GrechTech/RetroRosetta/Wiki/LevelShifter/Parts.png

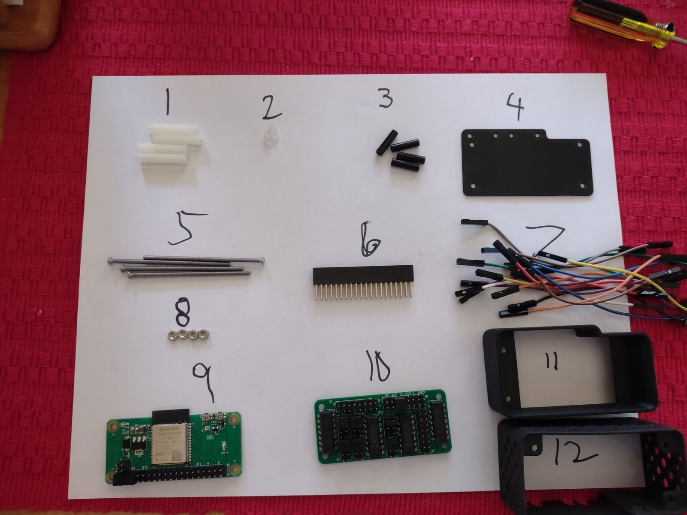
Wiki/LevelShifter/Parts.png
