GrechTech/RetroRosetta/Wiki/V2/RetroRosettaV2 DIY Setup_5.png

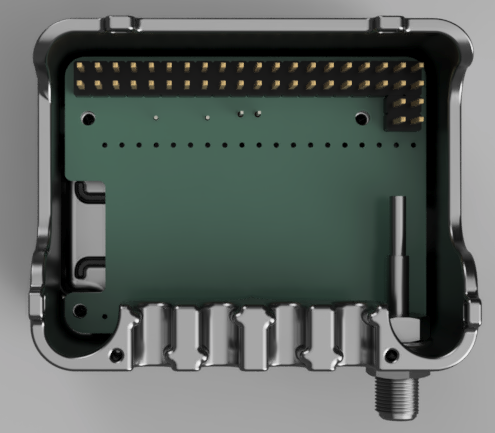
Wiki/V2/RetroRosettaV2 DIY Setup_5.png
