GrechTech/RetroRosetta/README.md

# RetroRosetta

Check the Wiki page for more information
https://github.com/GrechTech/RetroRosetta/wiki
