GrechTech/RetroRosetta/Marketing/cover2.png

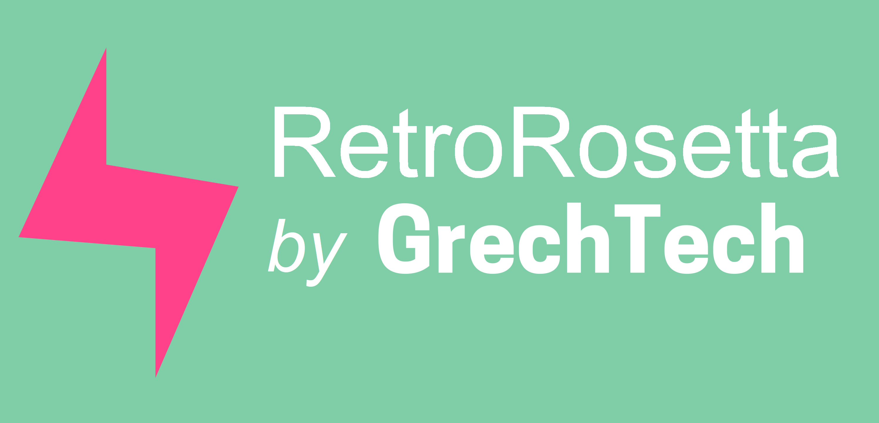
Marketing/cover2.png
