GrechTech/RetroRosetta/Wiki/3v3.png

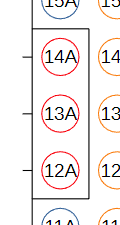
Wiki/3v3.png
