GrechTech/RetroRosetta/Wiki/BTN.png

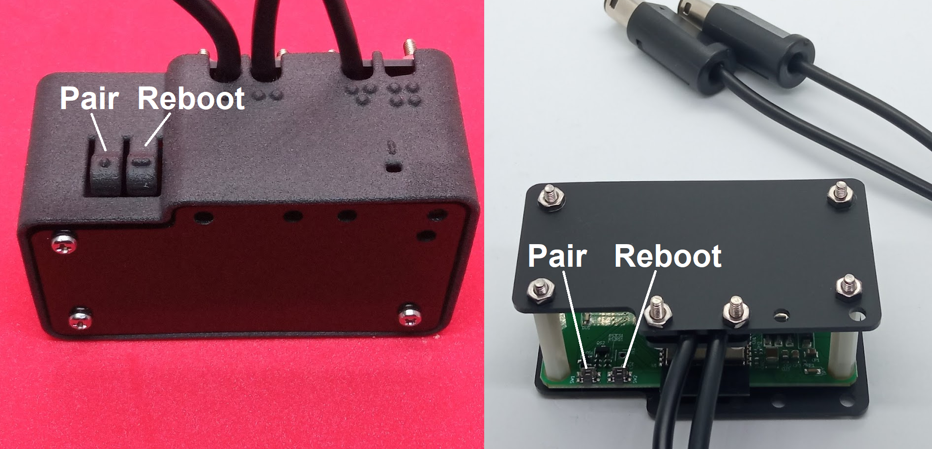
Wiki/BTN.png
