GrechTech/RetroRosetta/Wiki/Case2/1.jpg

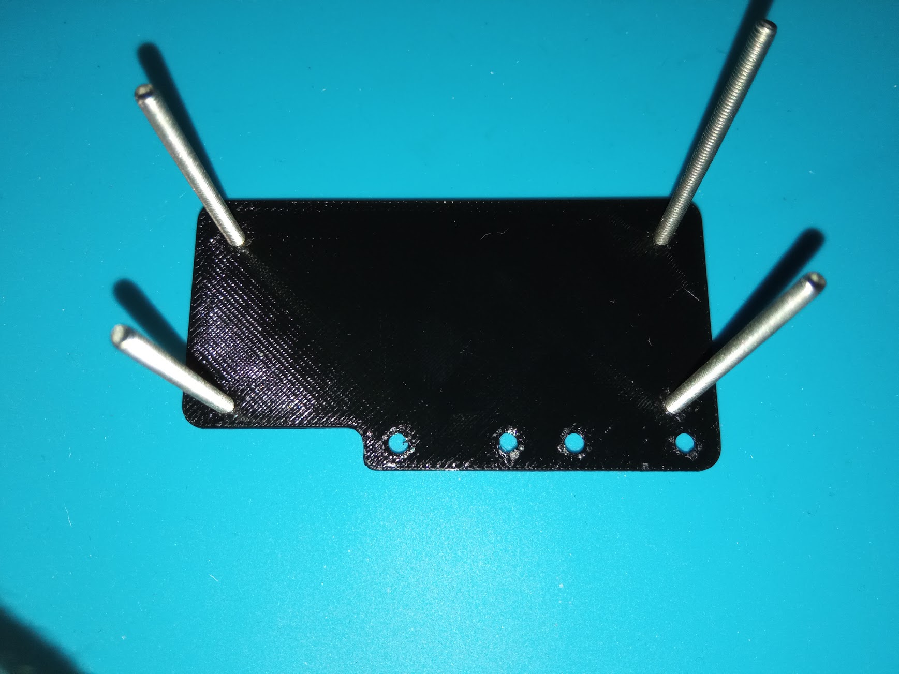
Wiki/Case2/1.jpg
