GrechTech/RetroRosetta/Wiki/Case2/2.jpg

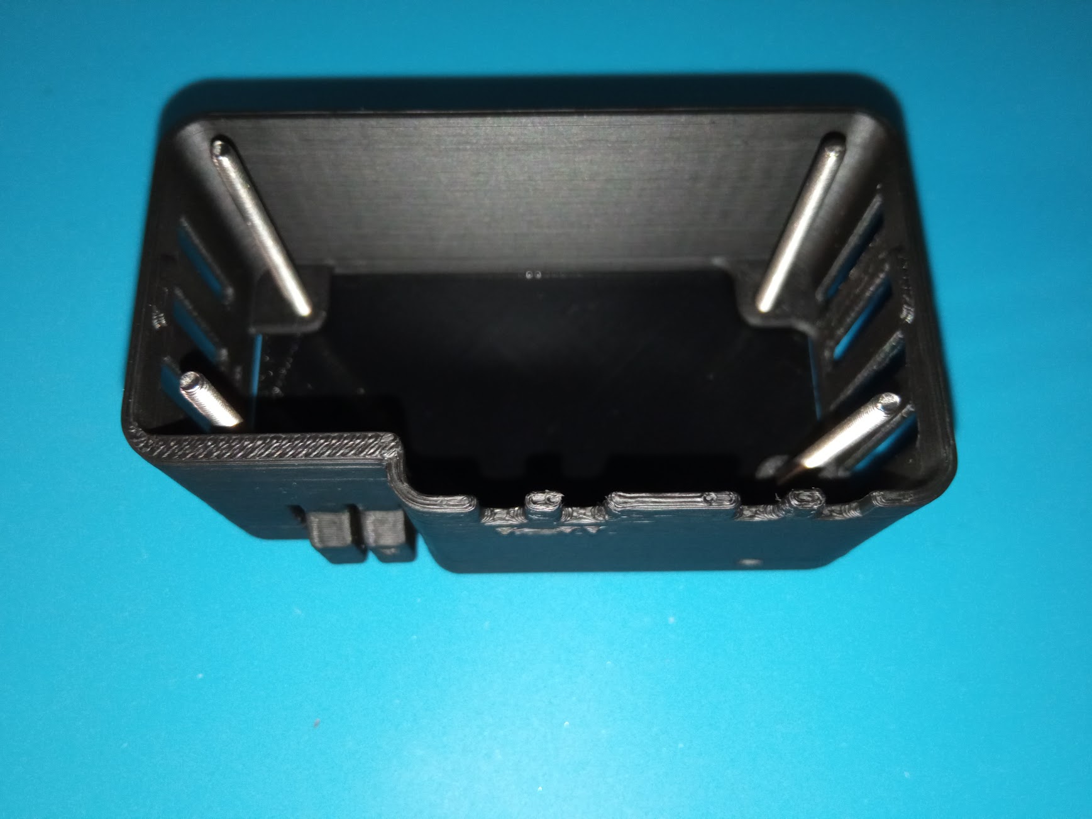
Wiki/Case2/2.jpg
