GrechTech/RetroRosetta/Wiki/Case2/3.jpg

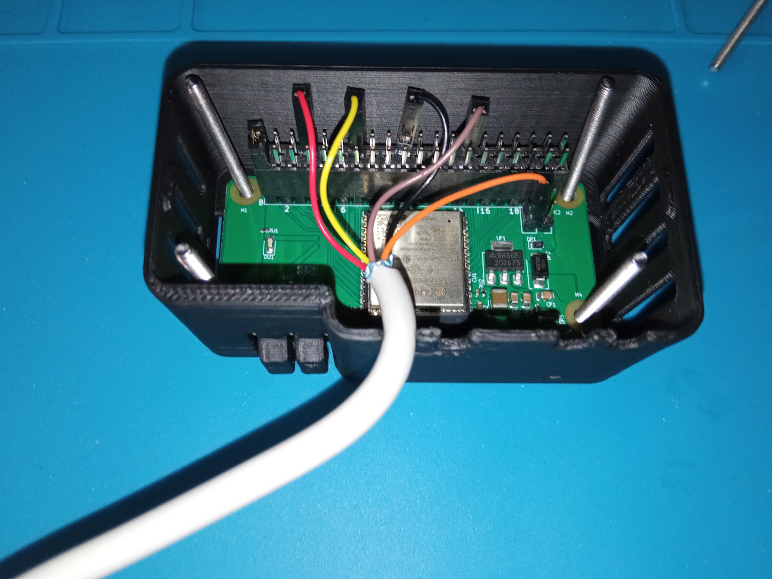
Wiki/Case2/3.jpg
