GrechTech/RetroRosetta/Wiki/Case2/4.jpg

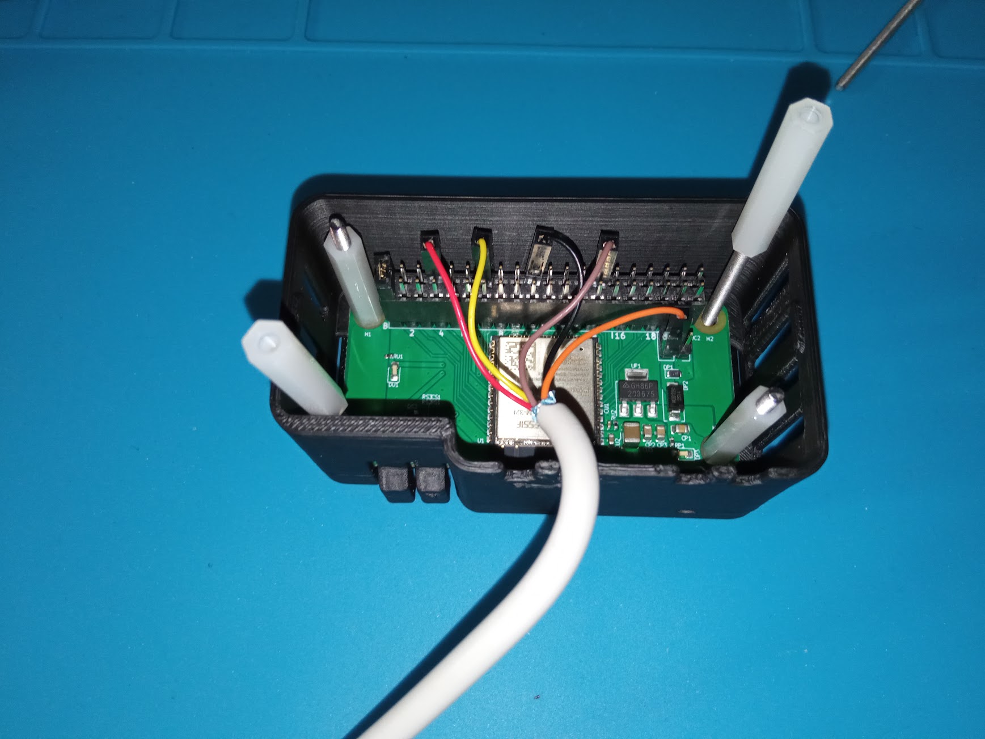
Wiki/Case2/4.jpg
