GrechTech/RetroRosetta/Wiki/Case2/5.jpg

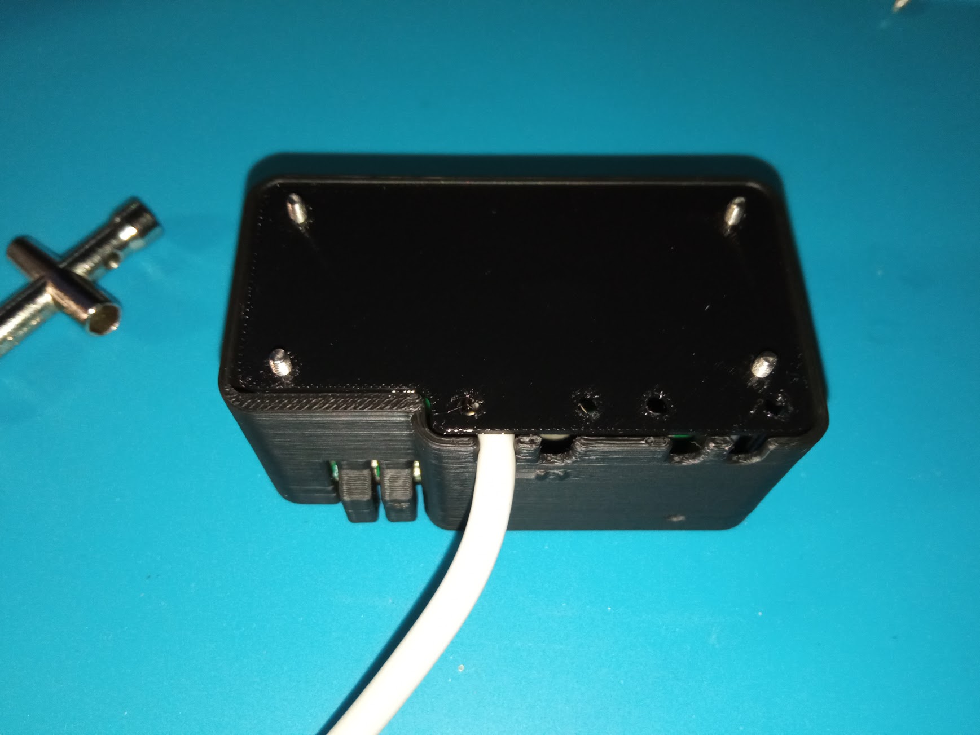
Wiki/Case2/5.jpg
