GrechTech/RetroRosetta/Wiki/Case2/6.jpg

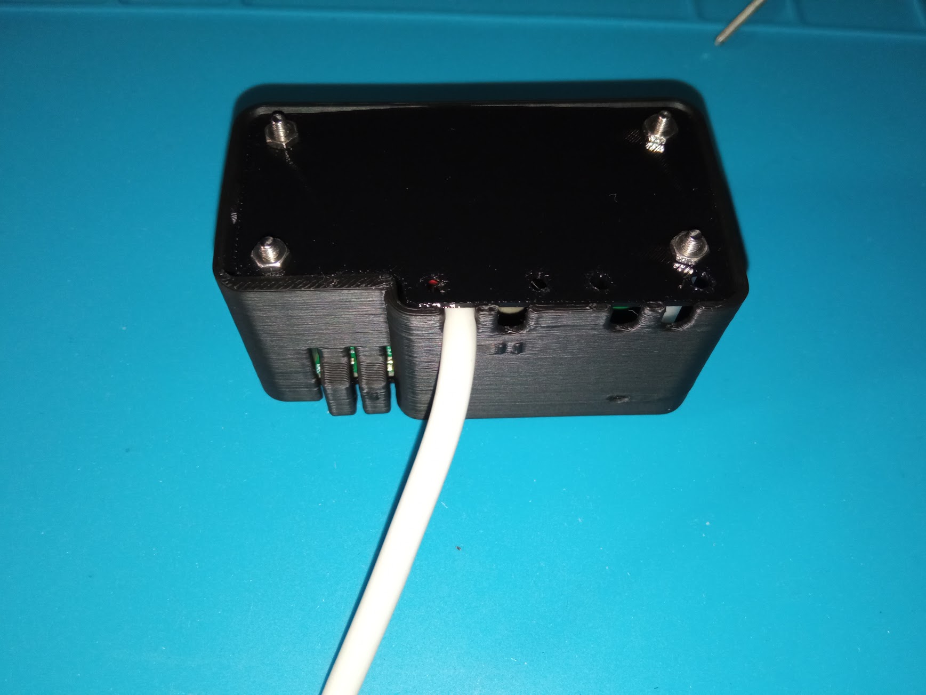
Wiki/Case2/6.jpg
