GrechTech/RetroRosetta/Wiki/Case2/7.jpg

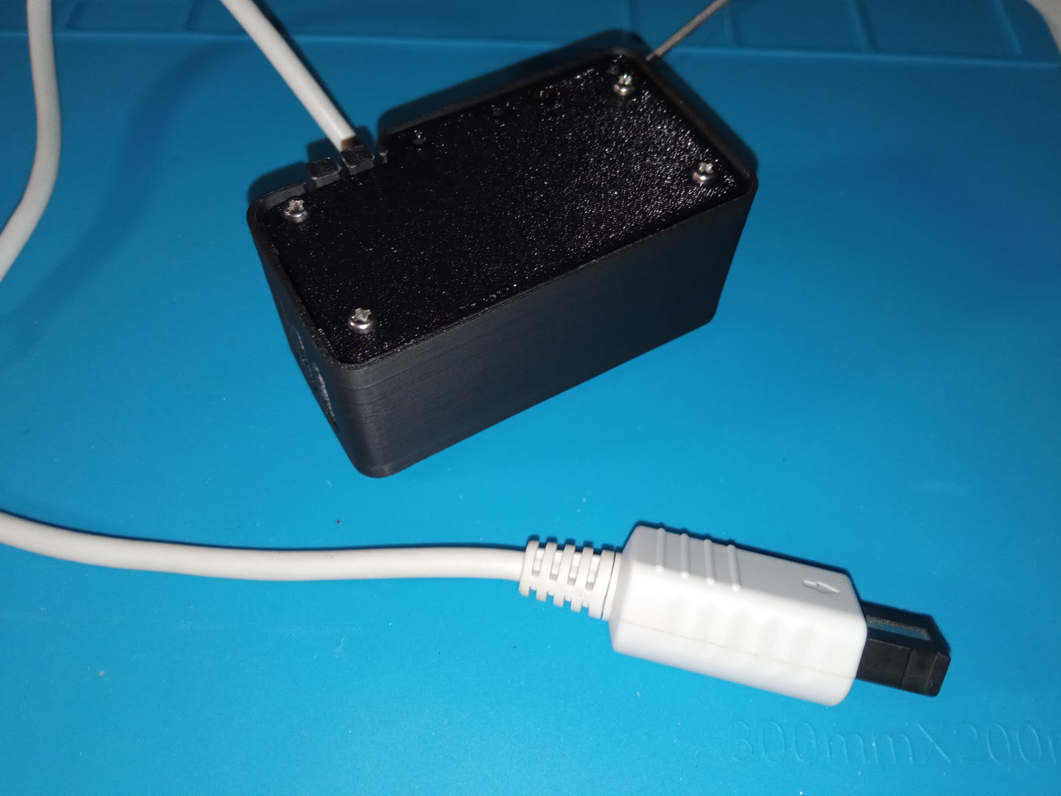
Wiki/Case2/7.jpg
