GrechTech/RetroRosetta/Wiki/DE9.png

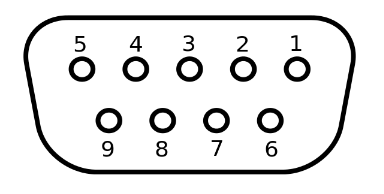
Wiki/DE9.png
