GrechTech/RetroRosetta/Wiki/Dreamcast_1P.png

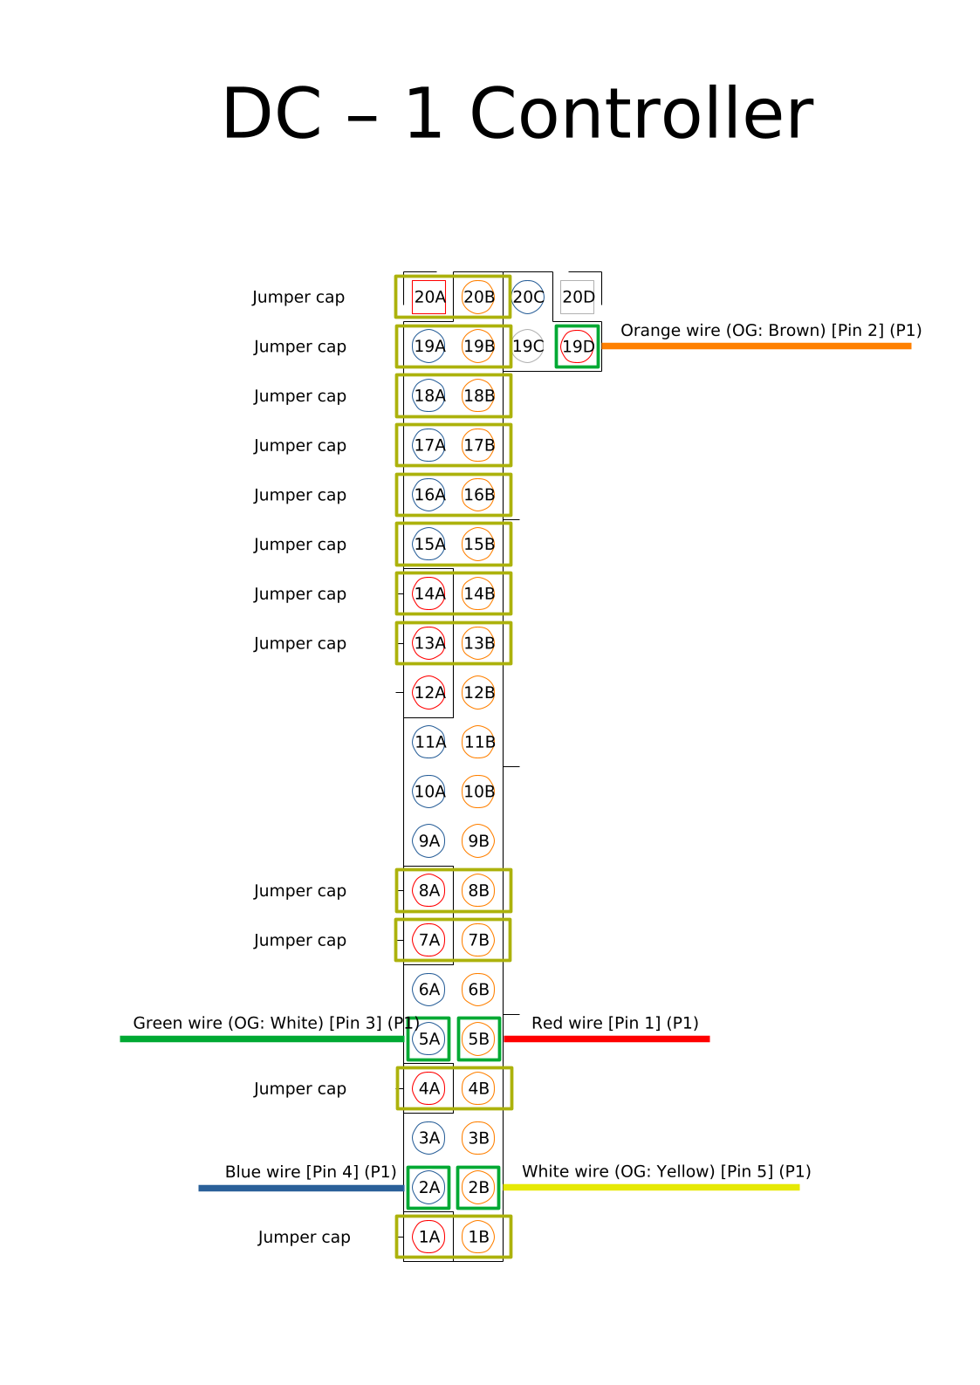
Wiki/Dreamcast_1P.png
