GrechTech/RetroRosetta/Wiki/Dreamcast_3P.png

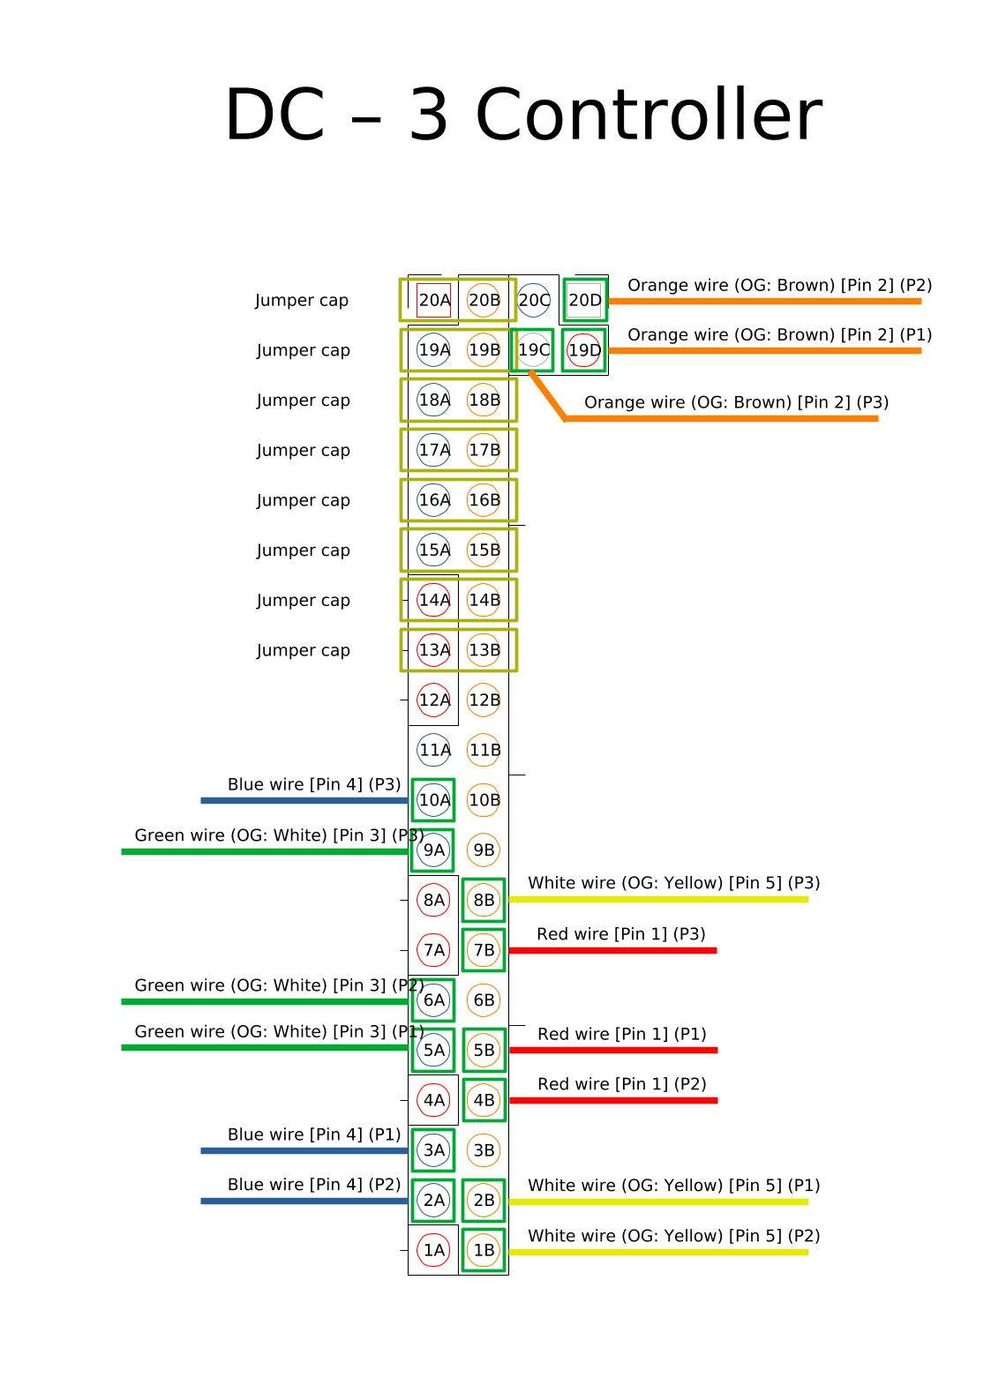
Wiki/Dreamcast_3P.png
