GrechTech/RetroRosetta/Wiki/Fami1.png

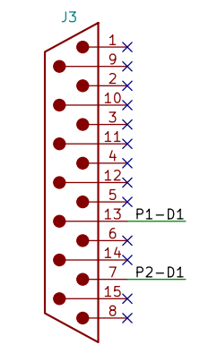
Wiki/Fami1.png
