GrechTech/RetroRosetta/Wiki/Fami2.png

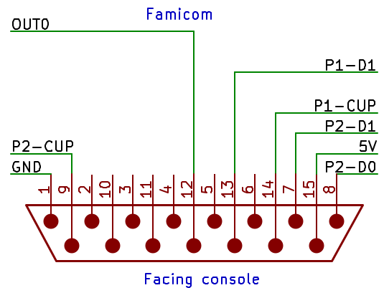
Wiki/Fami2.png
