GrechTech/RetroRosetta/Wiki/GameCube_1P.png

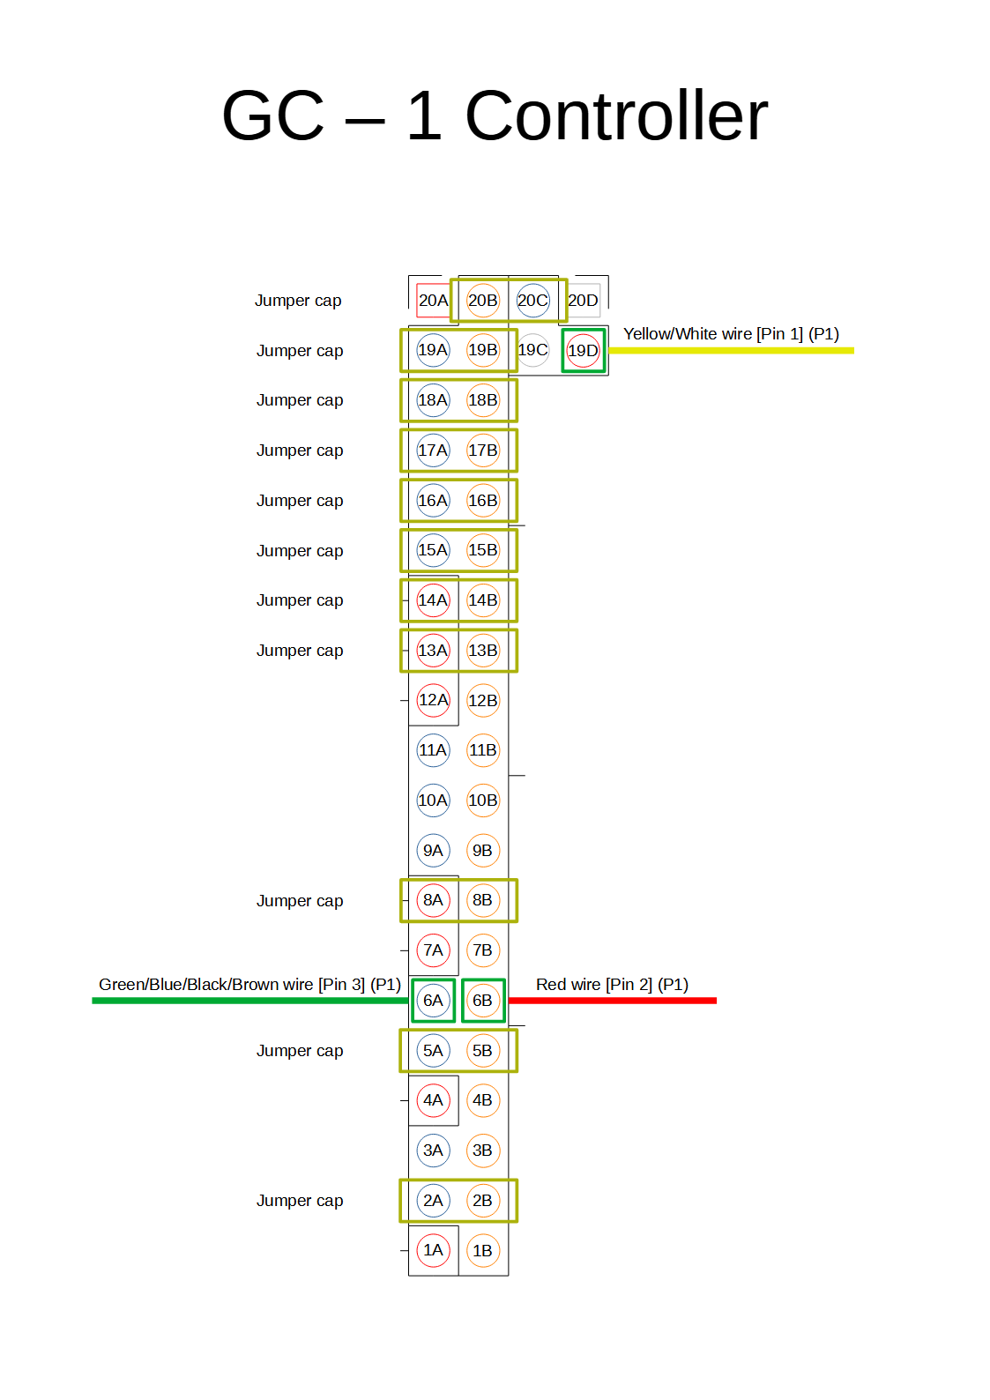
Wiki/GameCube_1P.png
