GrechTech/RetroRosetta/Wiki/GameCube_3P.png

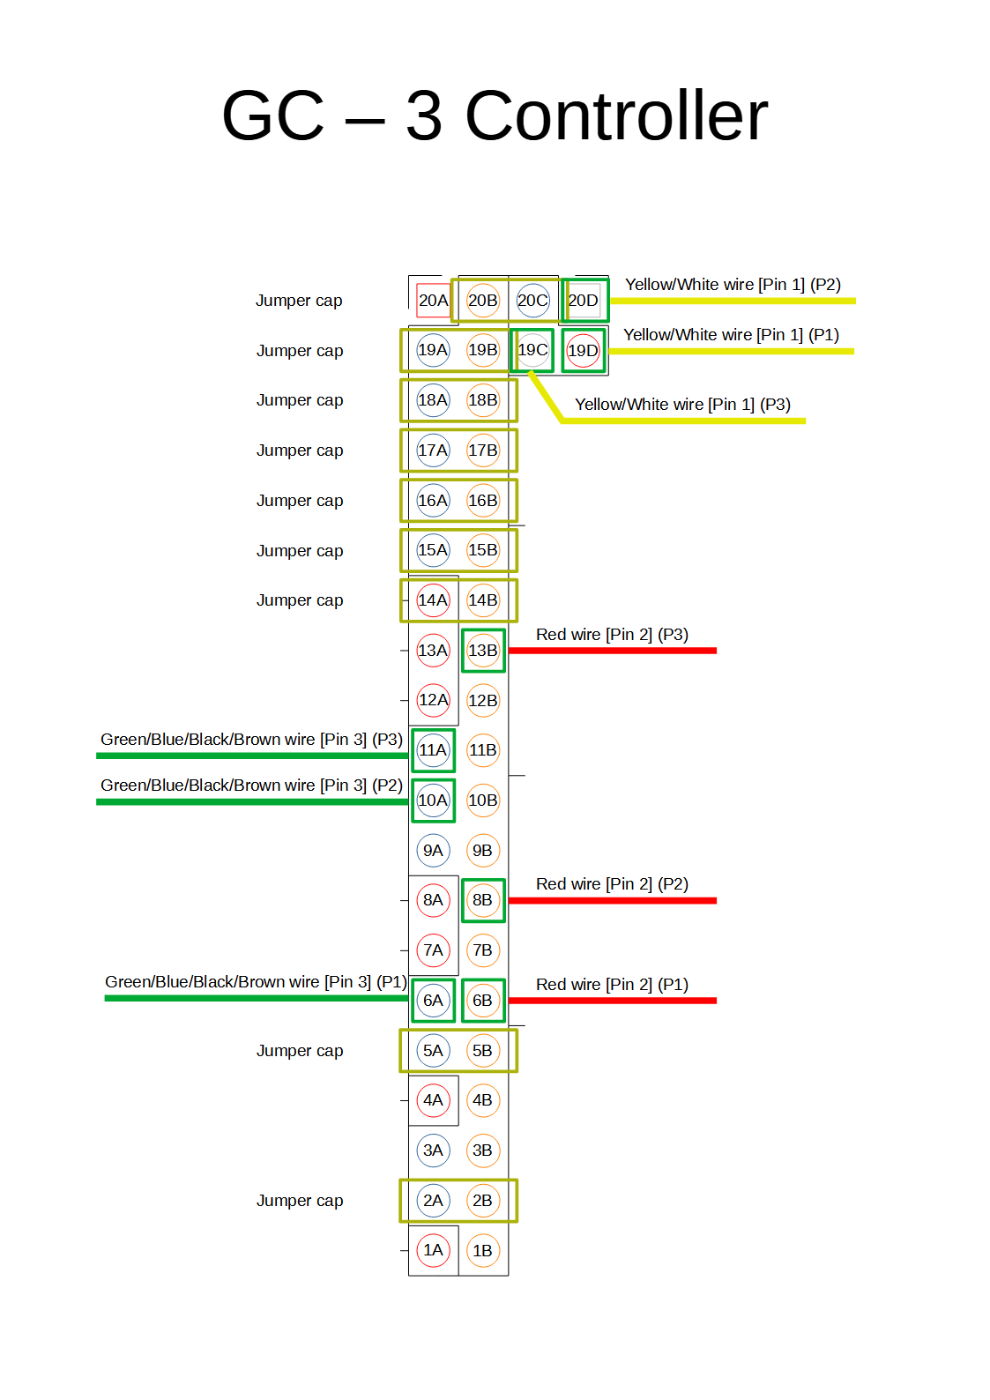
Wiki/GameCube_3P.png
