GrechTech/RetroRosetta/Wiki/LEDs.png

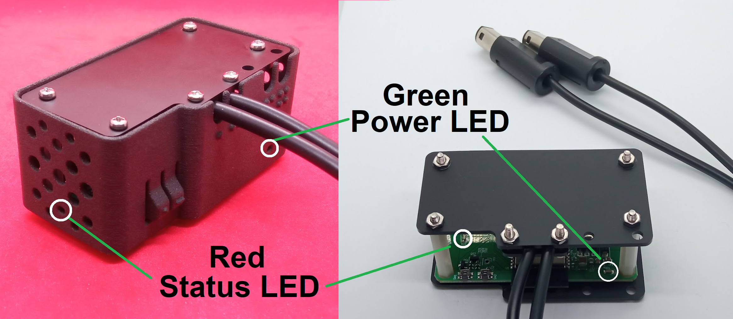
Wiki/LEDs.png
