GrechTech/RetroRosetta/Wiki/LevelShifter/BoardB.png

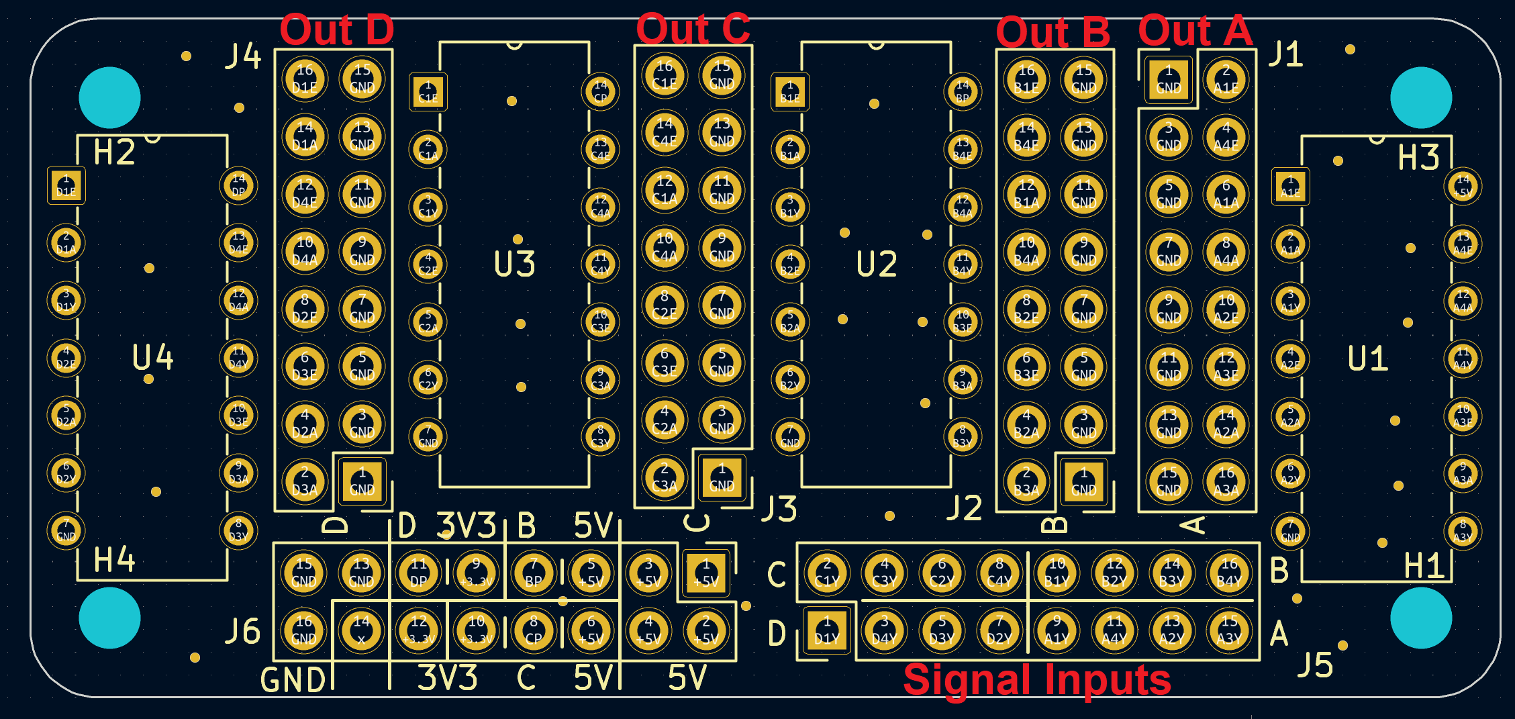
Wiki/LevelShifter/BoardB.png
