GrechTech/RetroRosetta/Wiki/LevelShifter/Case/Case0.jpg

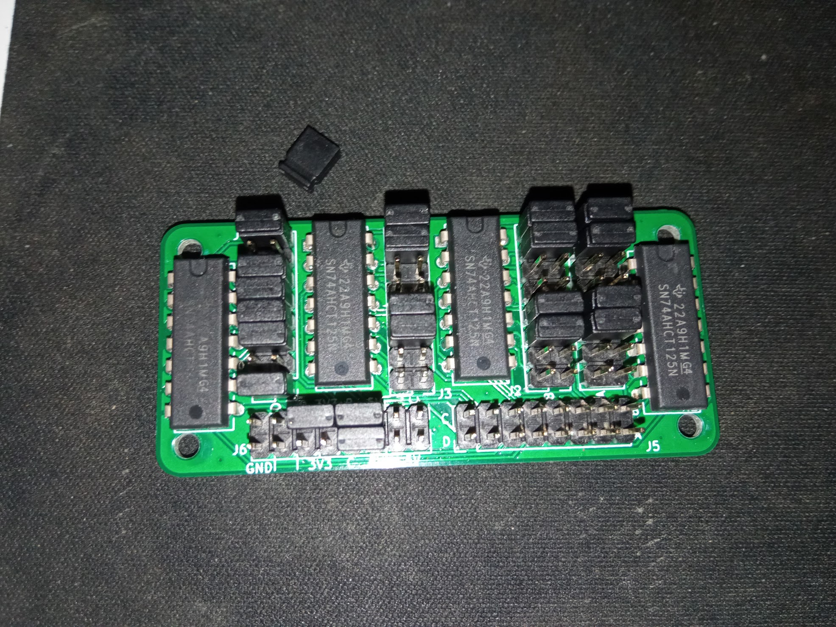
Wiki/LevelShifter/Case/Case0.jpg
