GrechTech/RetroRosetta/Wiki/LevelShifter/Case/Case1.jpg

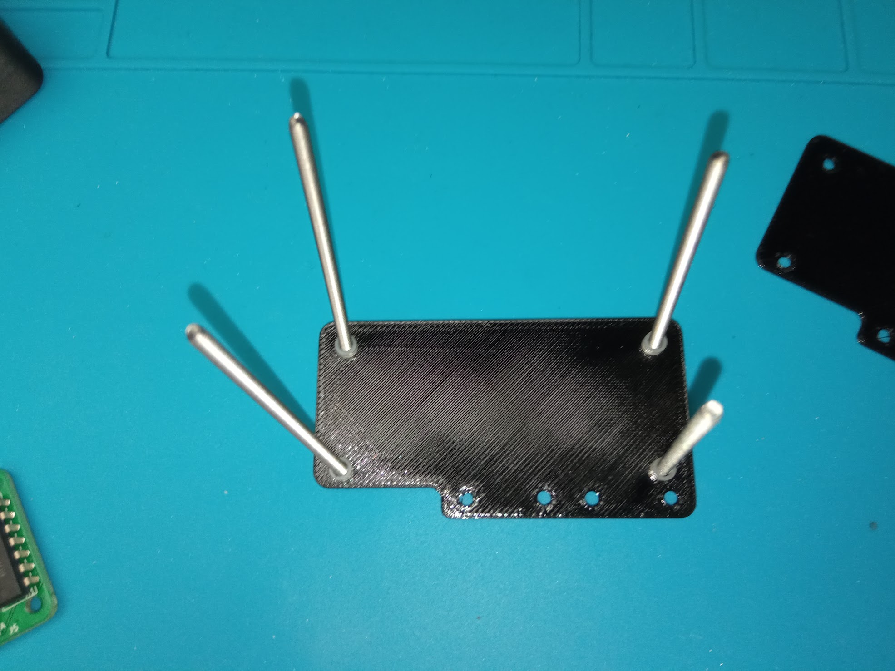
Wiki/LevelShifter/Case/Case1.jpg
