GrechTech/RetroRosetta/Wiki/LevelShifter/Case/Case2.jpg

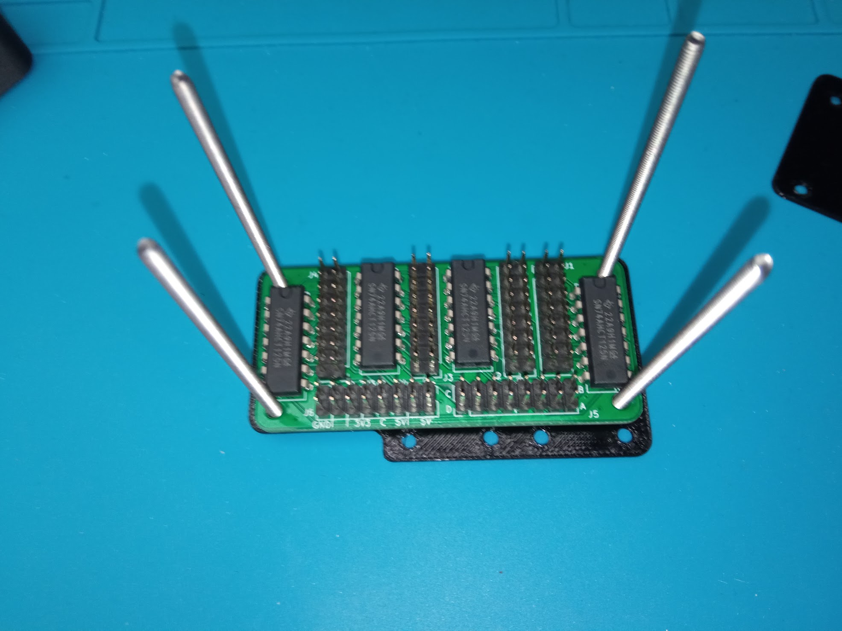
Wiki/LevelShifter/Case/Case2.jpg
