GrechTech/RetroRosetta/Wiki/LevelShifter/Case/Case3.jpg

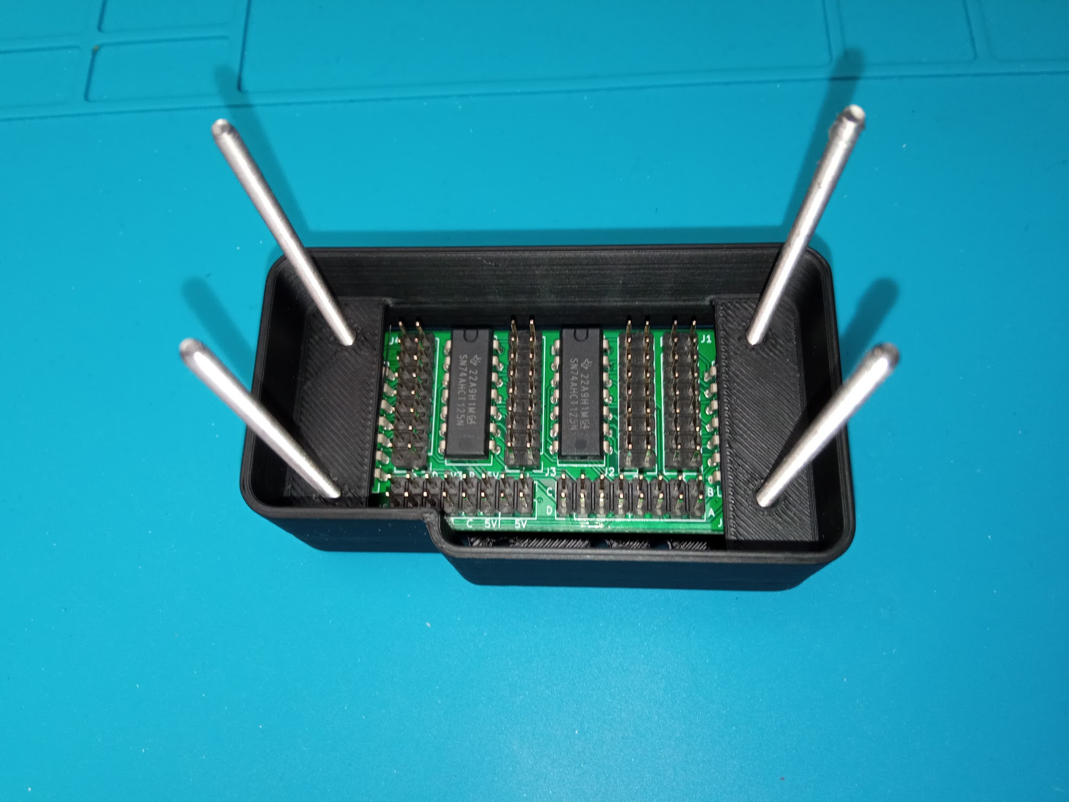
Wiki/LevelShifter/Case/Case3.jpg
