GrechTech/RetroRosetta/Wiki/LevelShifter/Case/Case4.jpg

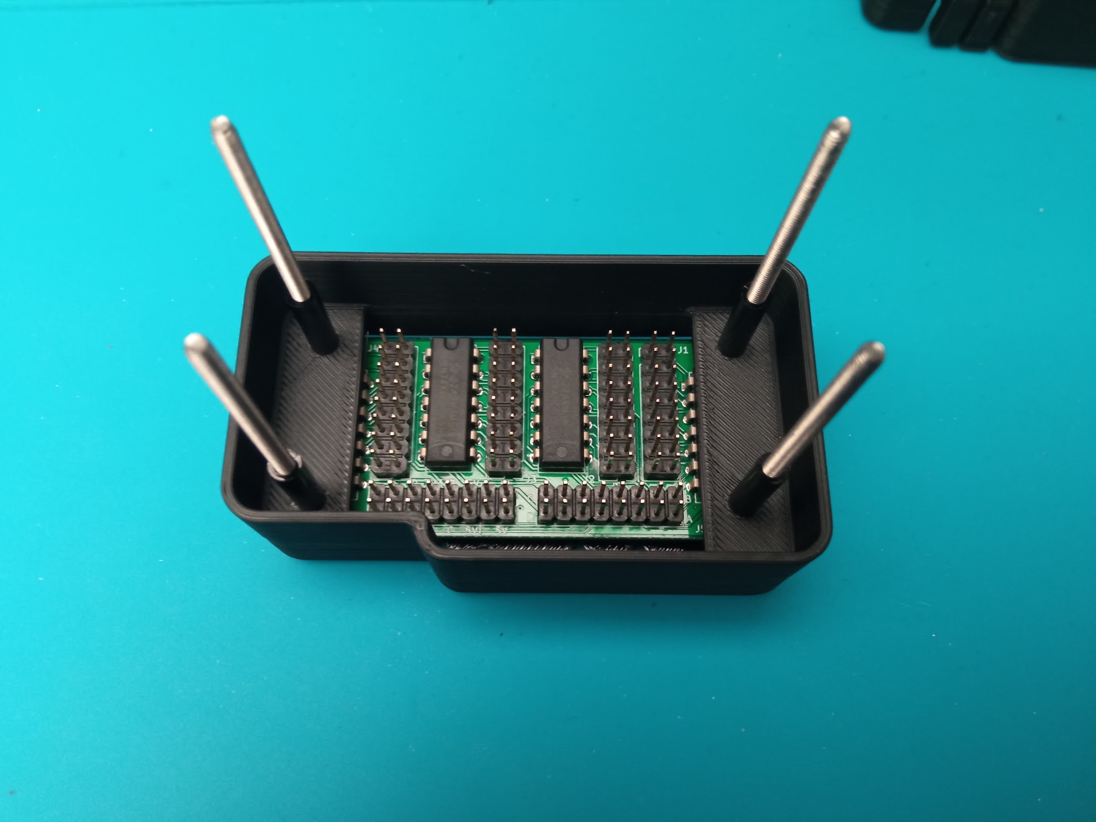
Wiki/LevelShifter/Case/Case4.jpg
