GrechTech/RetroRosetta/Wiki/LevelShifter/Case/Case5.jpg

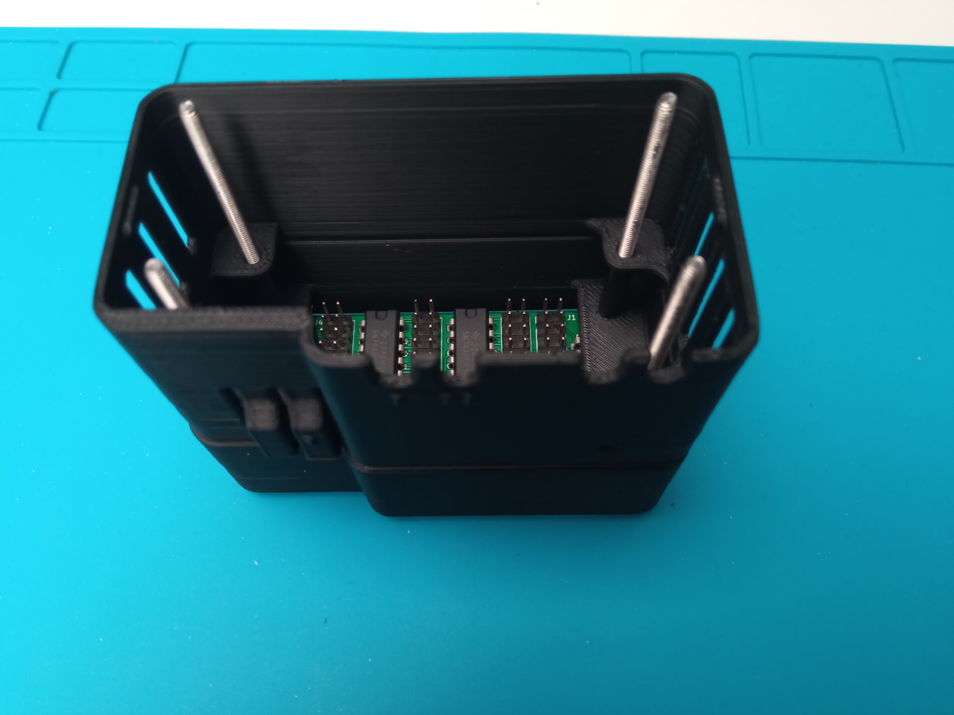
Wiki/LevelShifter/Case/Case5.jpg
