GrechTech/RetroRosetta/Wiki/LevelShifter/Case/Case6.jpg

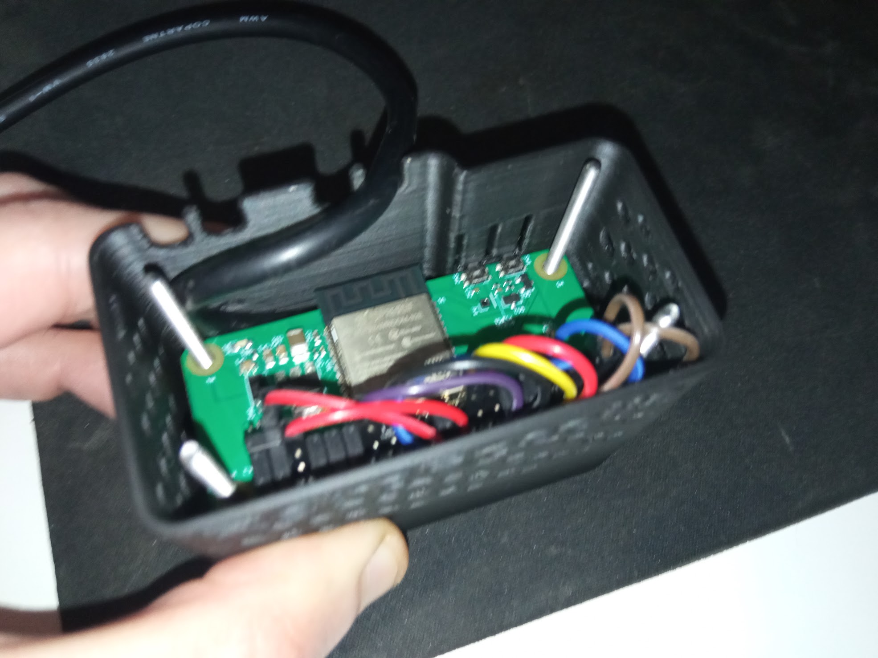
Wiki/LevelShifter/Case/Case6.jpg
