GrechTech/RetroRosetta/Wiki/LevelShifter/LSIO.png

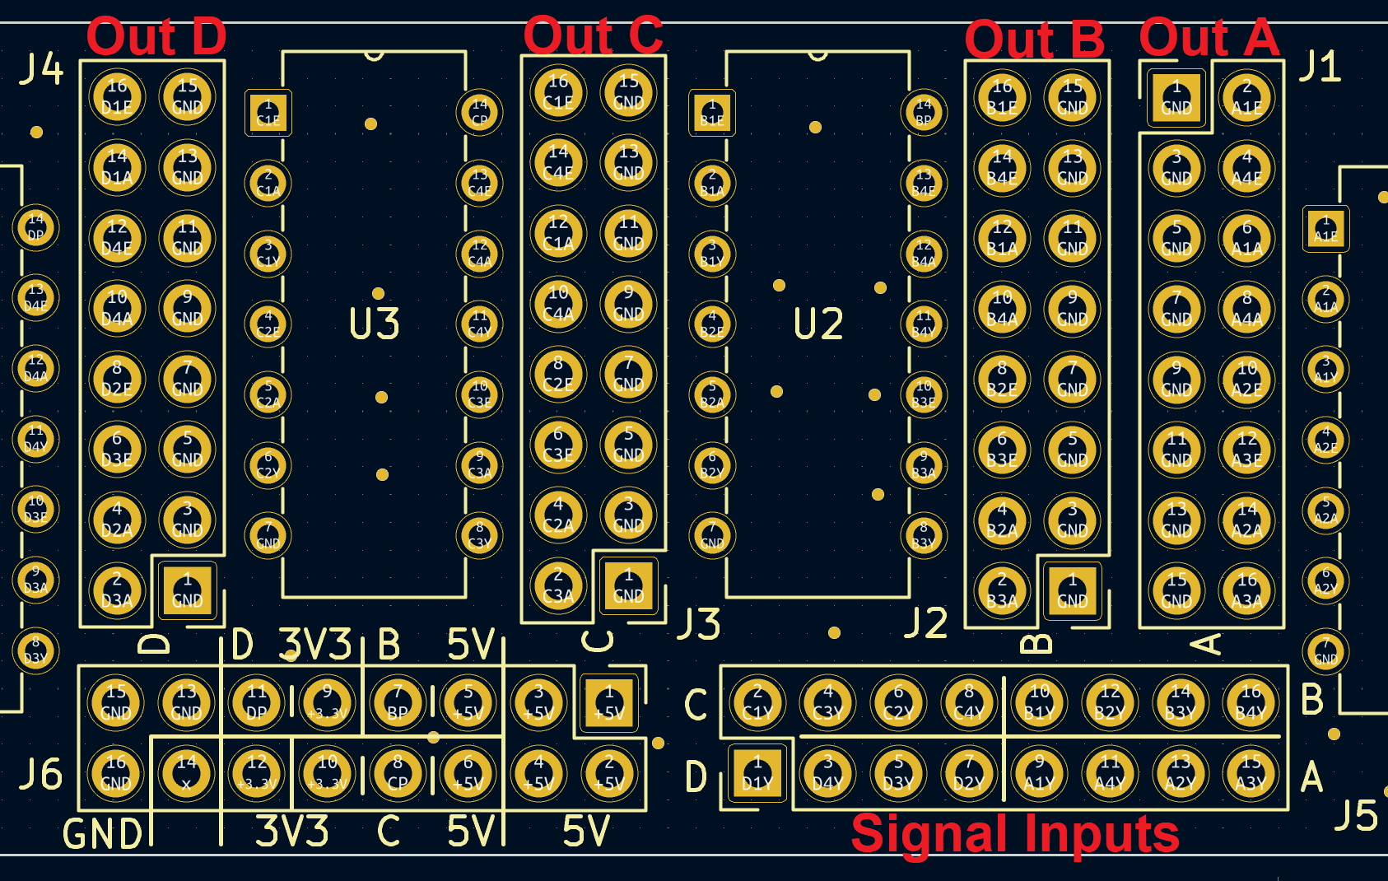
Wiki/LevelShifter/LSIO.png
