GrechTech/RetroRosetta/Wiki/LevelShifter/Schematic.png

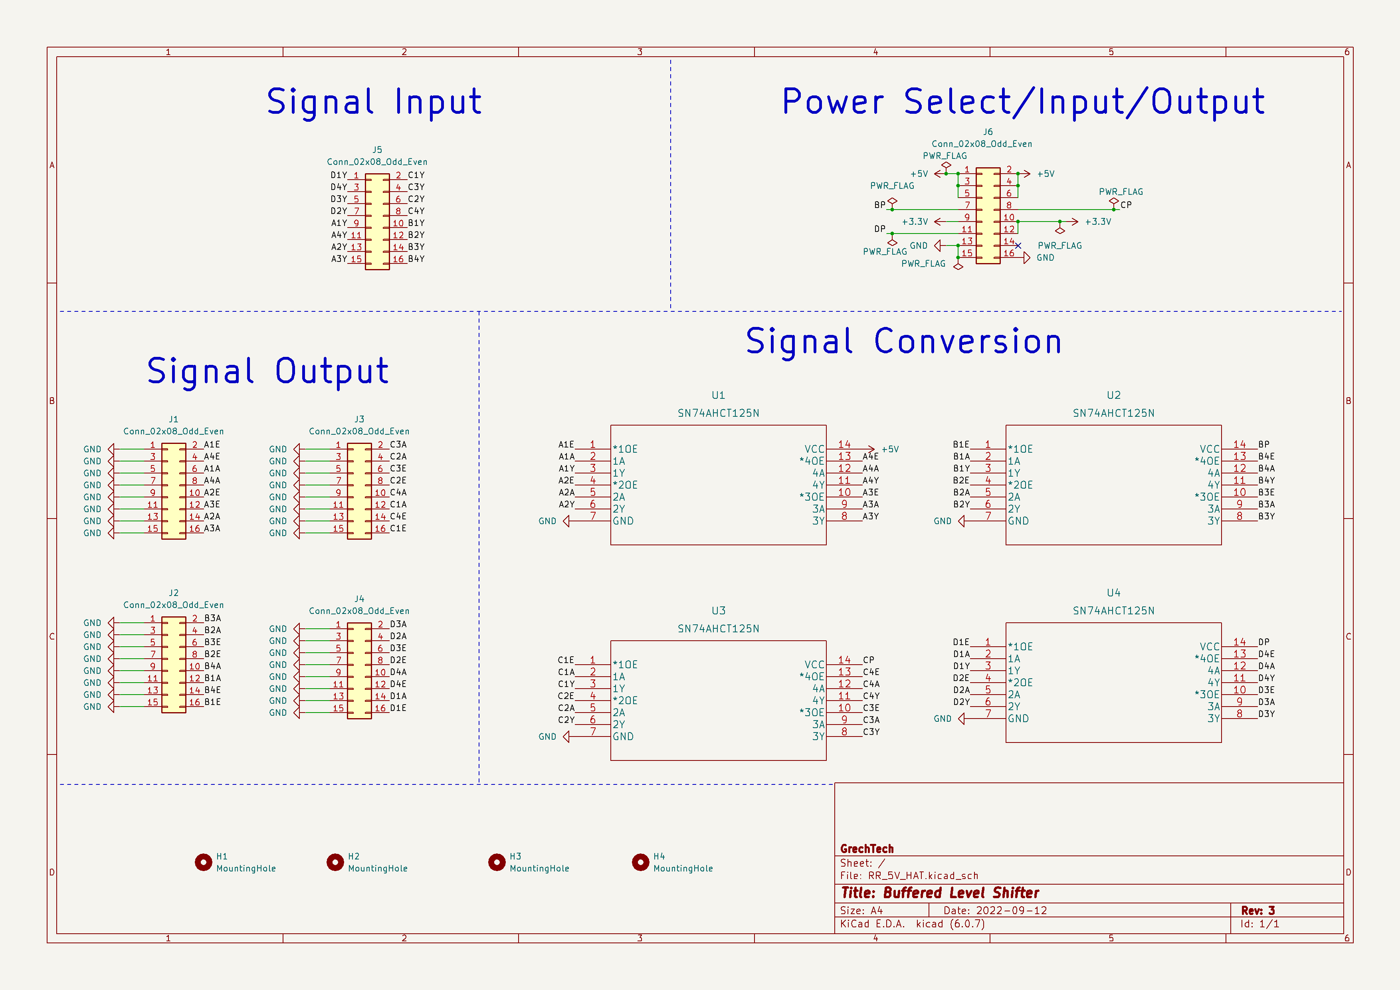
Wiki/LevelShifter/Schematic.png
