GrechTech/RetroRosetta/Wiki/N64_1P.png

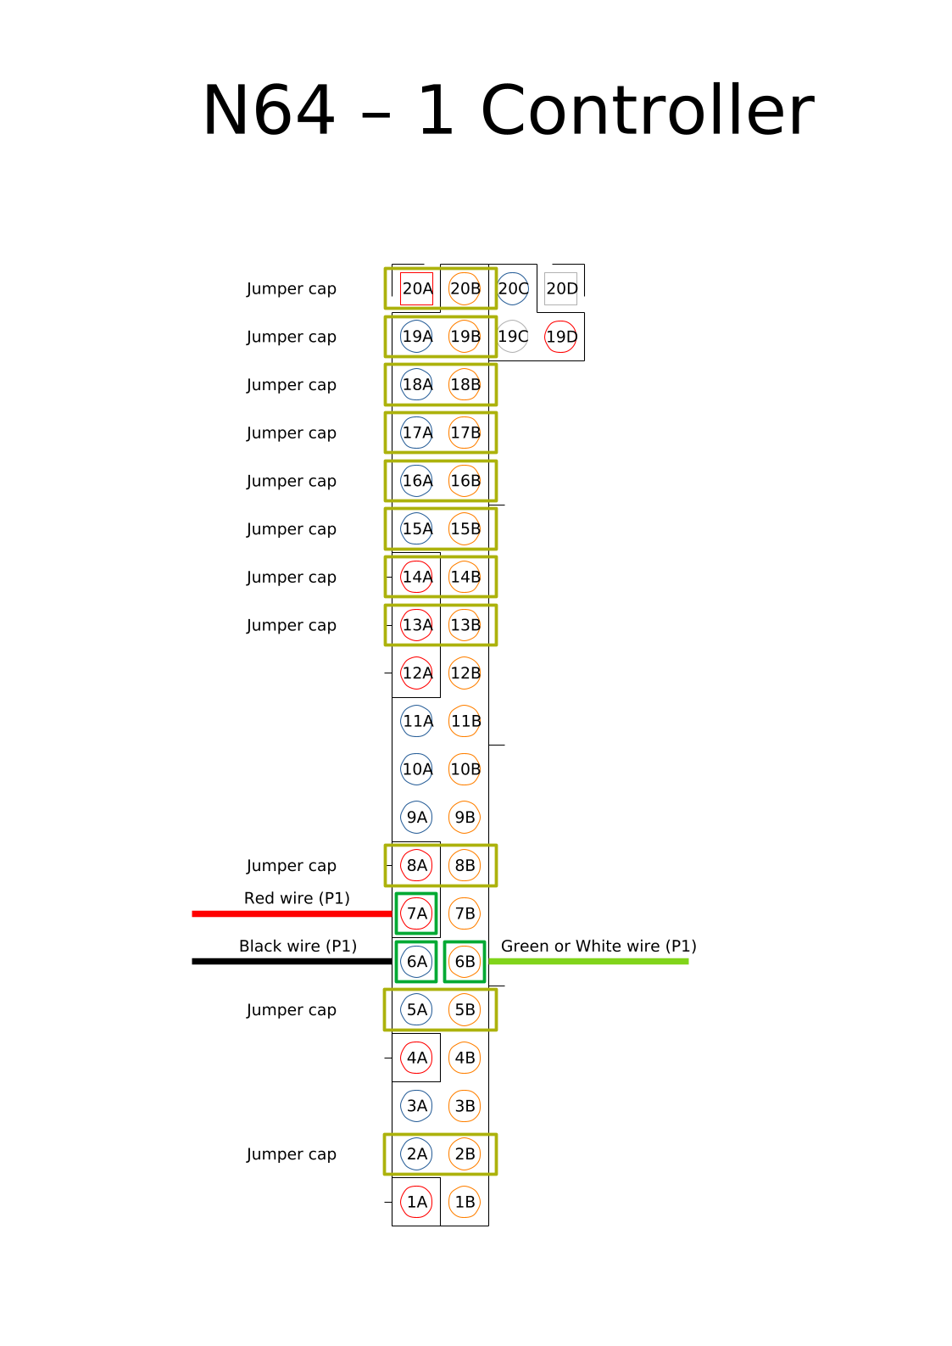
Wiki/N64_1P.png
