GrechTech/RetroRosetta/Wiki/NES.png

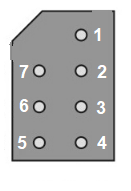
Wiki/NES.png
