GrechTech/RetroRosetta/Wiki/Pinout/DC.png

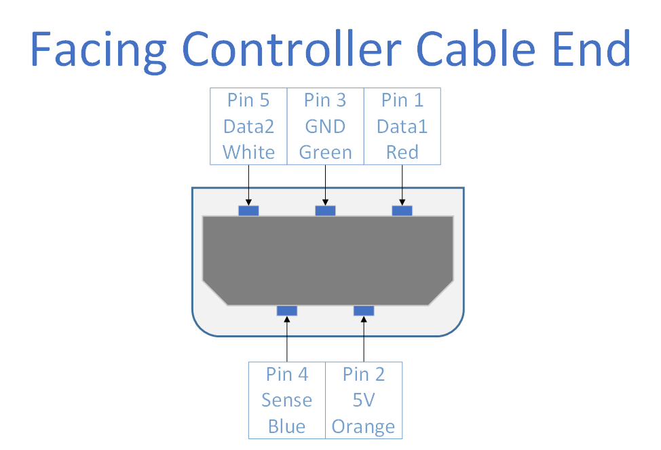
Wiki/Pinout/DC.png
