GrechTech/RetroRosetta/Wiki/Pinout/N64.png

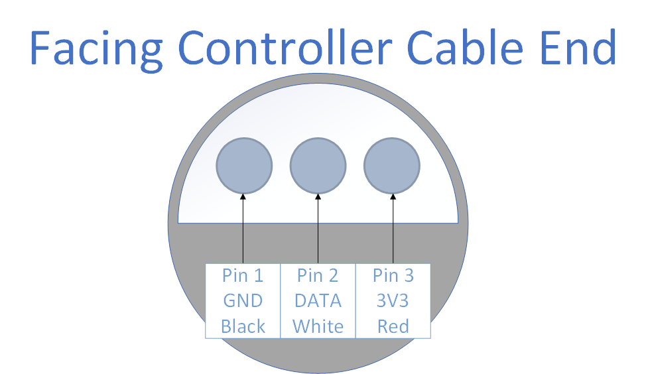
Wiki/Pinout/N64.png
