GrechTech/RetroRosetta/Wiki/Pinout/NGC.png

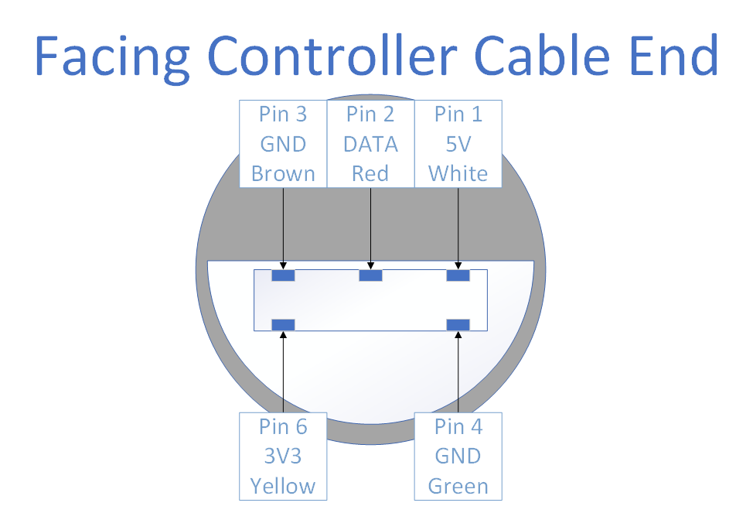
Wiki/Pinout/NGC.png
