GrechTech/RetroRosetta/Wiki/Pinout/PSX.png

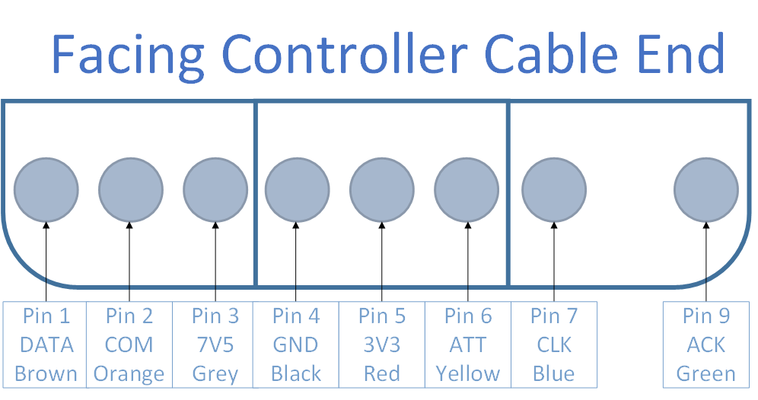
Wiki/Pinout/PSX.png
