GrechTech/RetroRosetta/Wiki/PSX_2P.png

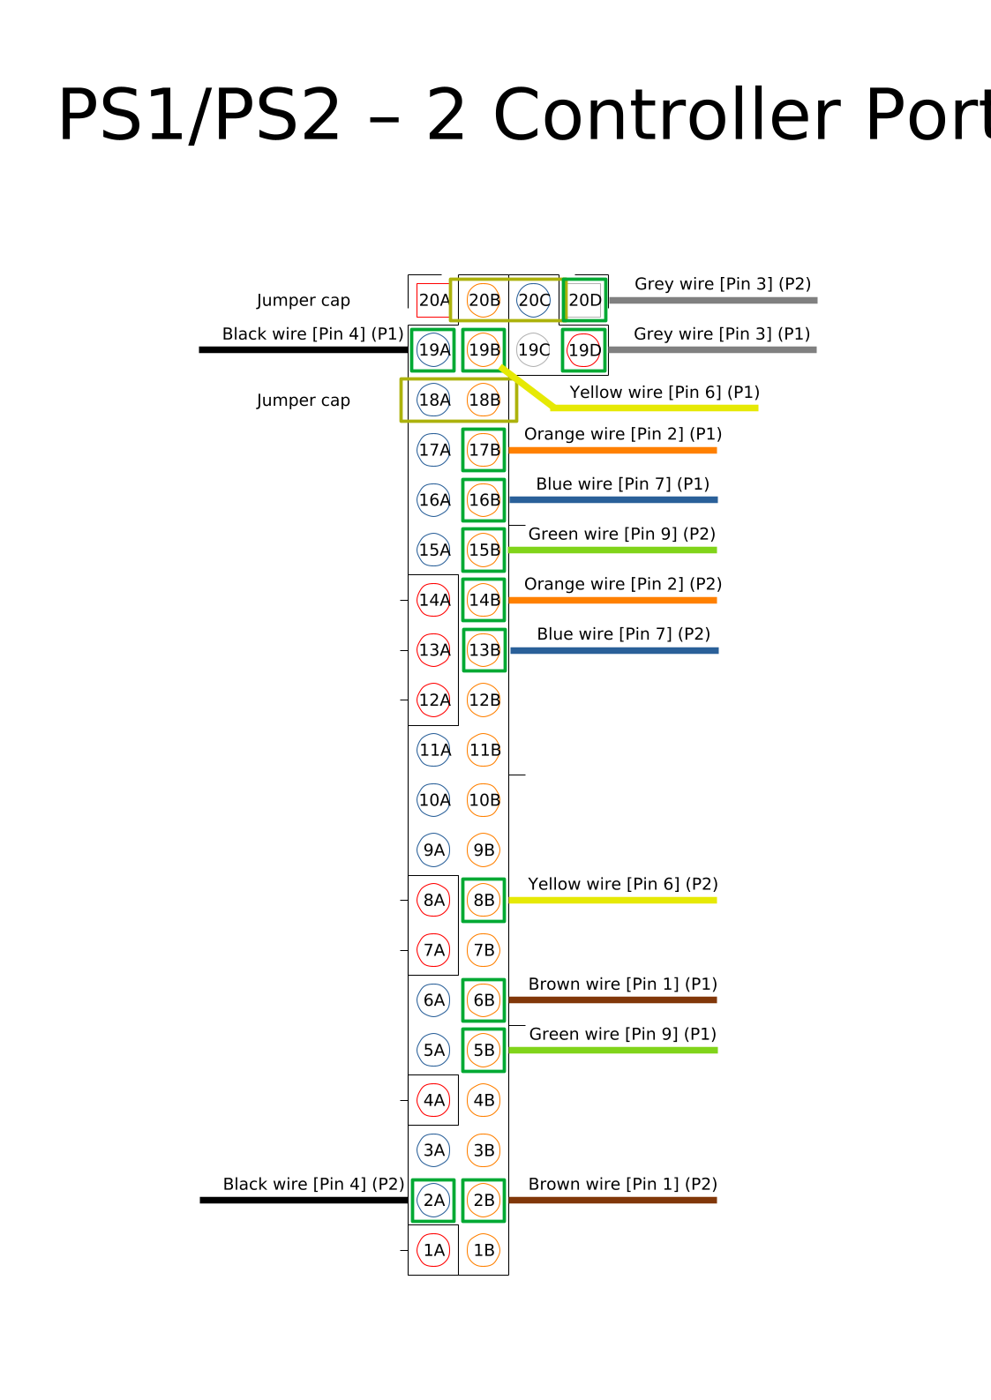
Wiki/PSX_2P.png
