GrechTech/RetroRosetta/Wiki/RRIO.jpeg

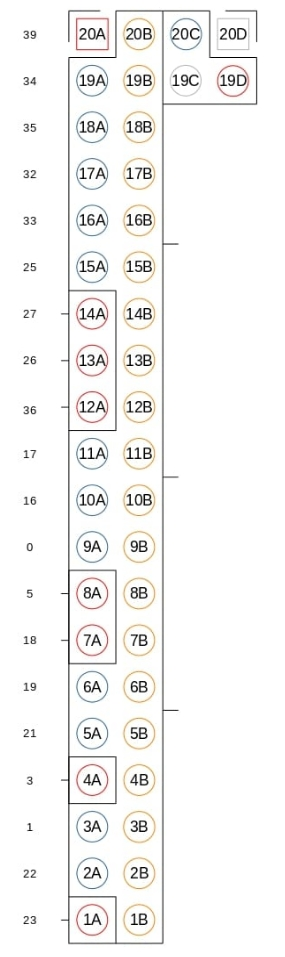
Wiki/RRIO.jpeg
