GrechTech/RetroRosetta/Wiki/Saturn.png

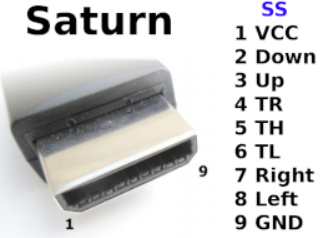
Wiki/Saturn.png
