GrechTech/RetroRosetta/Wiki/USB_Power.png

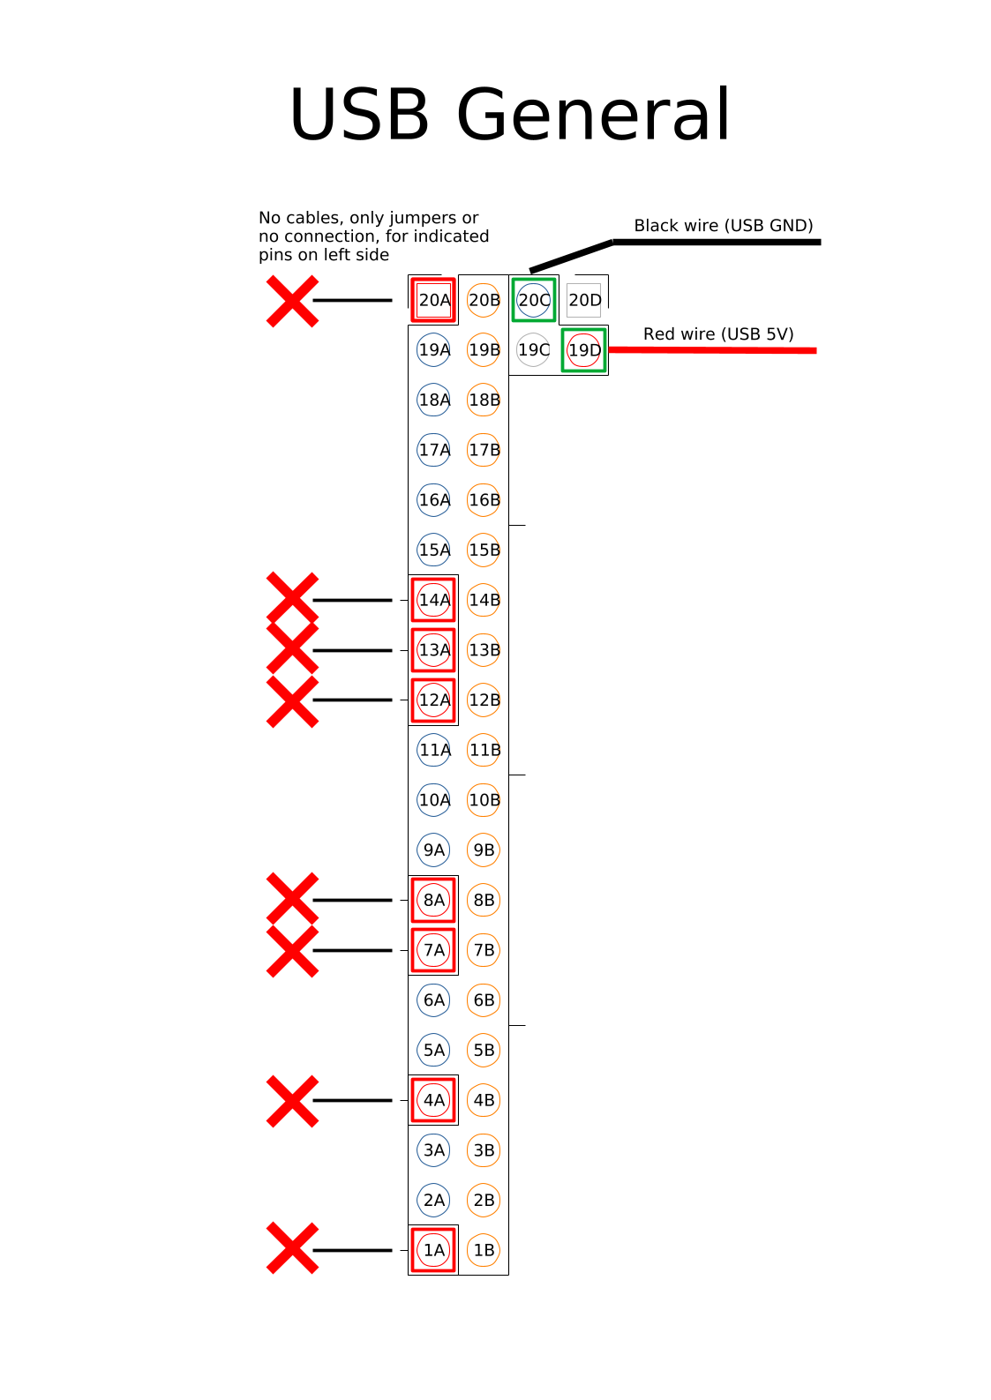
Wiki/USB_Power.png
