GrechTech/RetroRosetta/Wiki/V2/Connectors/3V - 64_4P.png

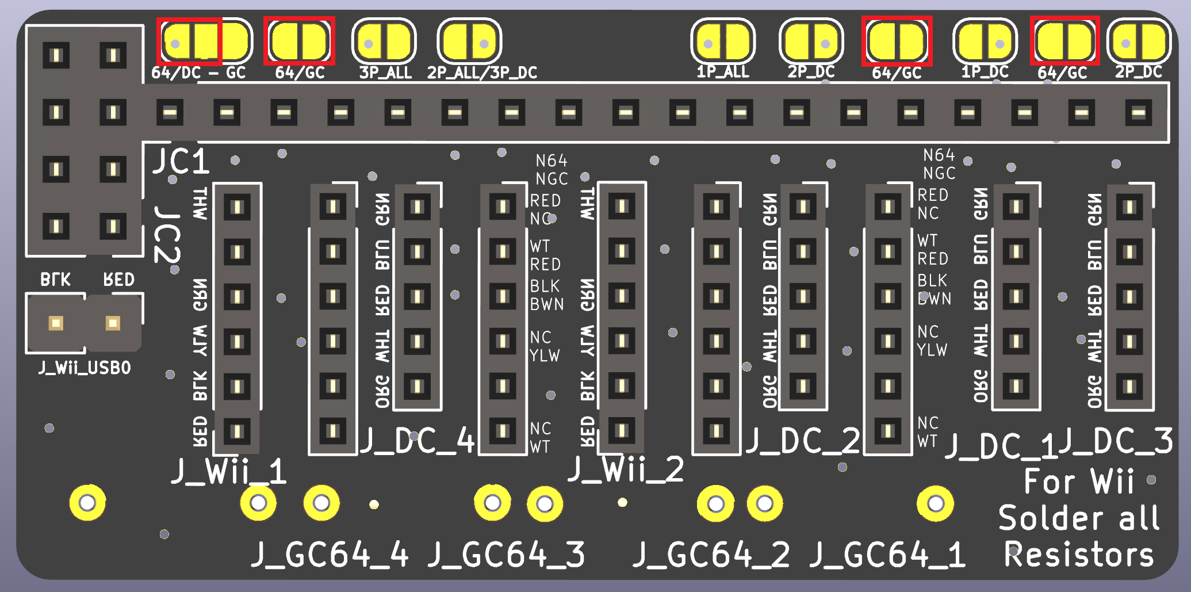
Wiki/V2/Connectors/3V - 64_4P.png
