GrechTech/RetroRosetta/Wiki/V2/Connectors/3V - Wii_REVERSE - Copy.png

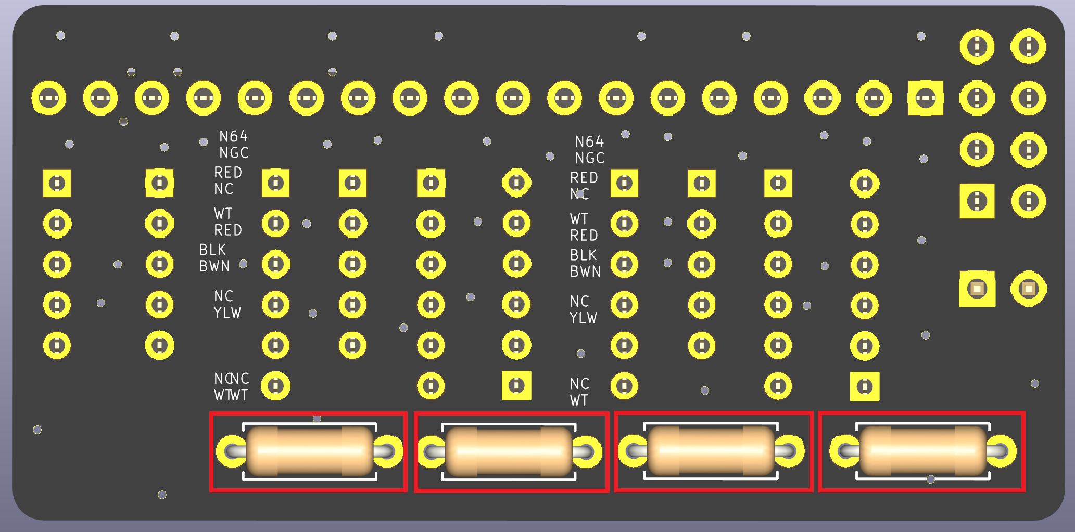
Wiki/V2/Connectors/3V - Wii_REVERSE - Copy.png
