GrechTech/RetroRosetta/Wiki/V2/Connectors/5V.png

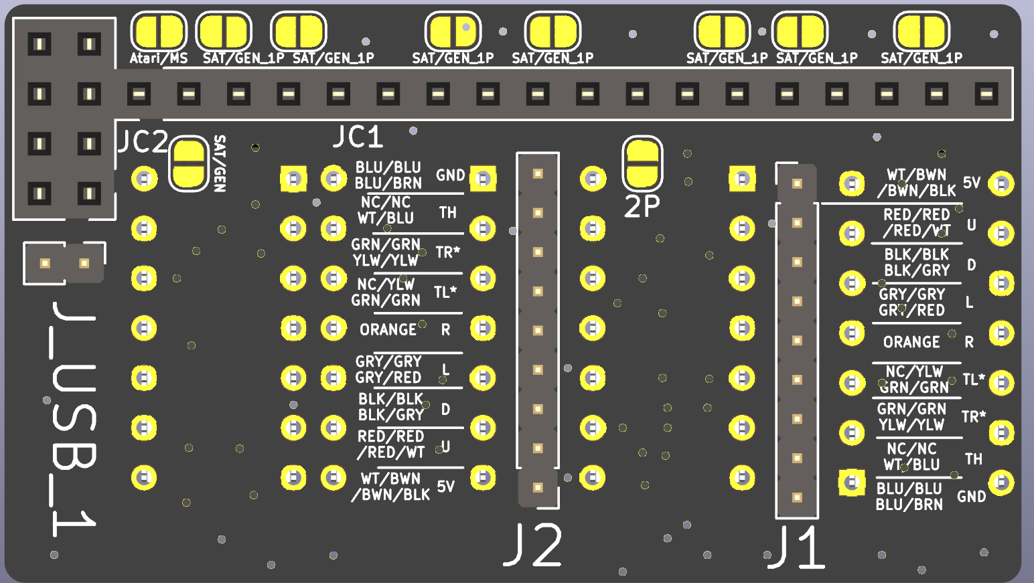
Wiki/V2/Connectors/5V.png
