GrechTech/RetroRosetta/Wiki/V2/Connectors/5V_REVERSE.png

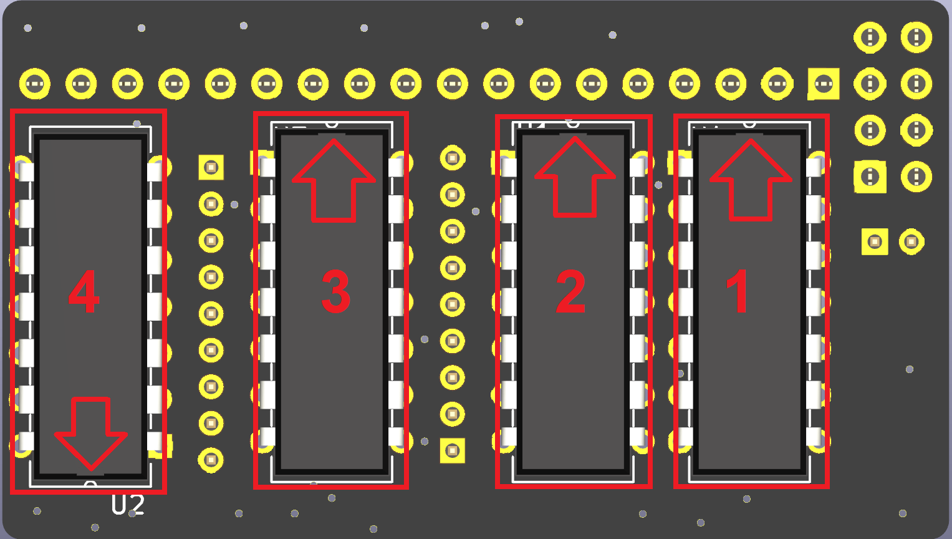
Wiki/V2/Connectors/5V_REVERSE.png
