GrechTech/RetroRosetta/Wiki/V2/Connectors/NES_3DO - 3DO.png

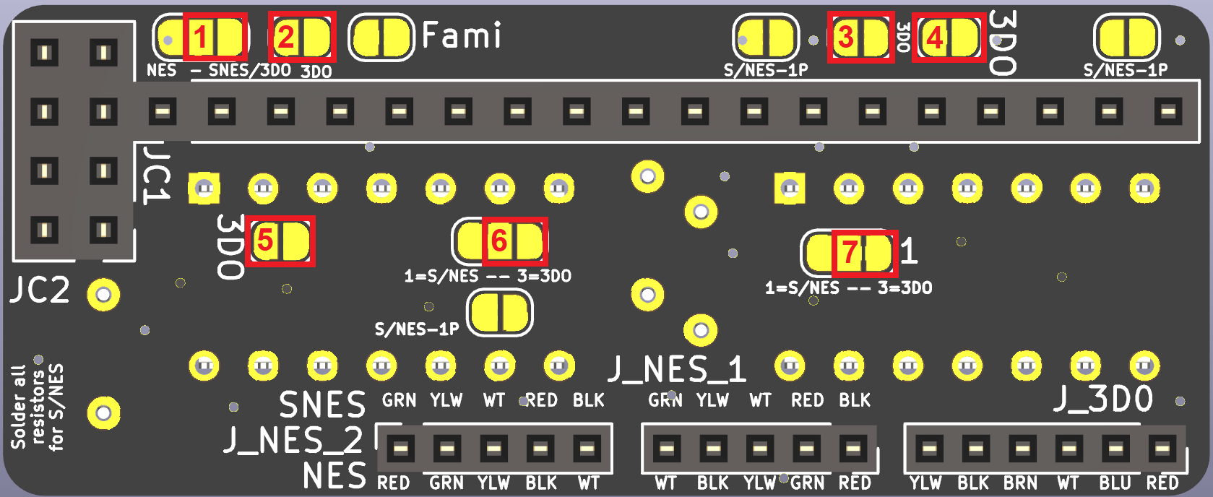
Wiki/V2/Connectors/NES_3DO - 3DO.png
