GrechTech/RetroRosetta/Wiki/V2/Connectors/NES_3DO_REVERSE - ICs.png

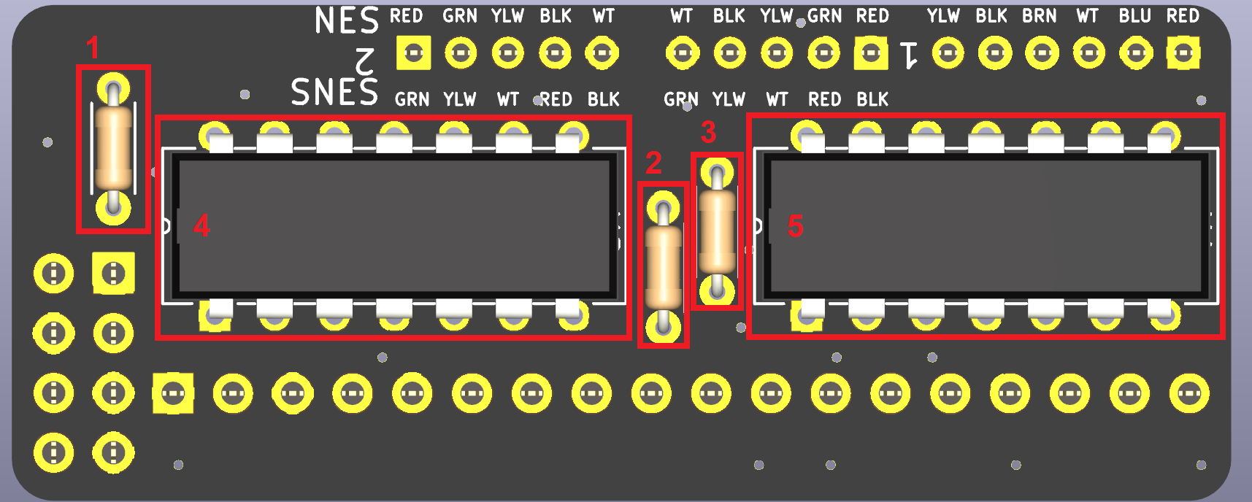
Wiki/V2/Connectors/NES_3DO_REVERSE - ICs.png
