GrechTech/RetroRosetta/Wiki/V2/Connectors/PSX.png

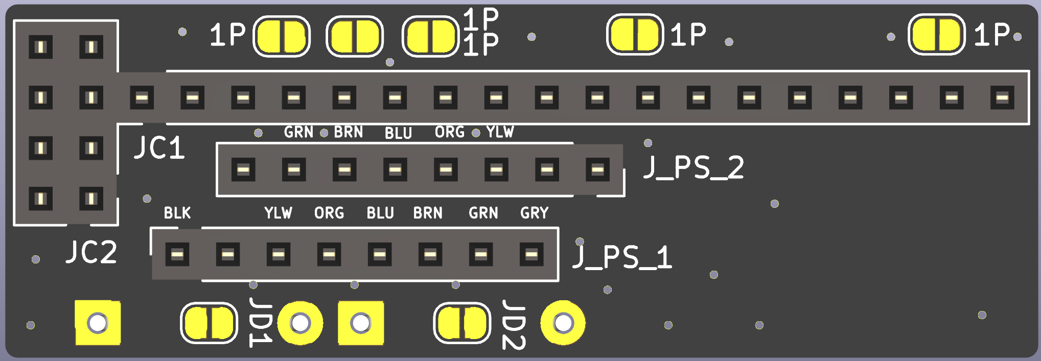
Wiki/V2/Connectors/PSX.png
