GrechTech/RetroRosetta/Wiki/V2/Connectors/PSX_REVERSE.png

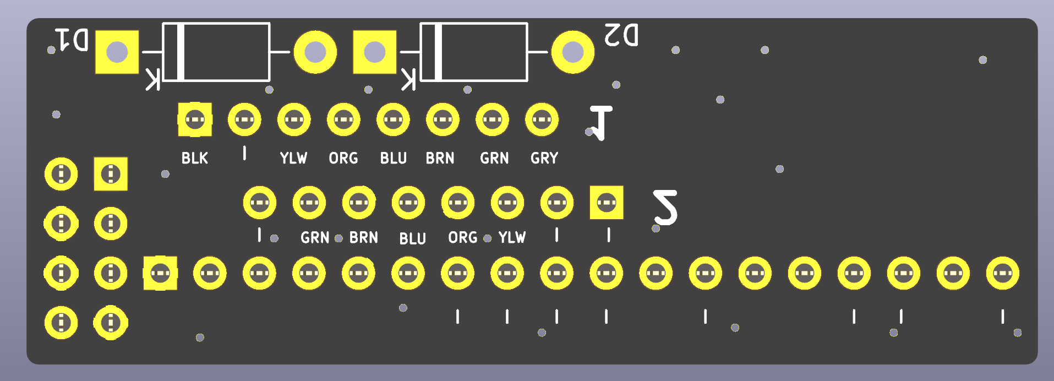
Wiki/V2/Connectors/PSX_REVERSE.png
