GrechTech/RetroRosetta/Wiki/V2/GTRR_V4_1B.png

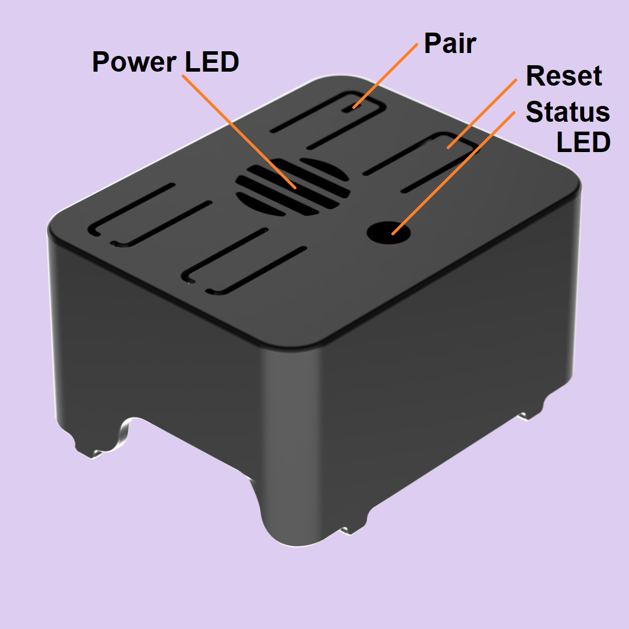
Wiki/V2/GTRR_V4_1B.png
