GrechTech/RetroRosetta/Wiki/V2/GTRR_V4_2B.png

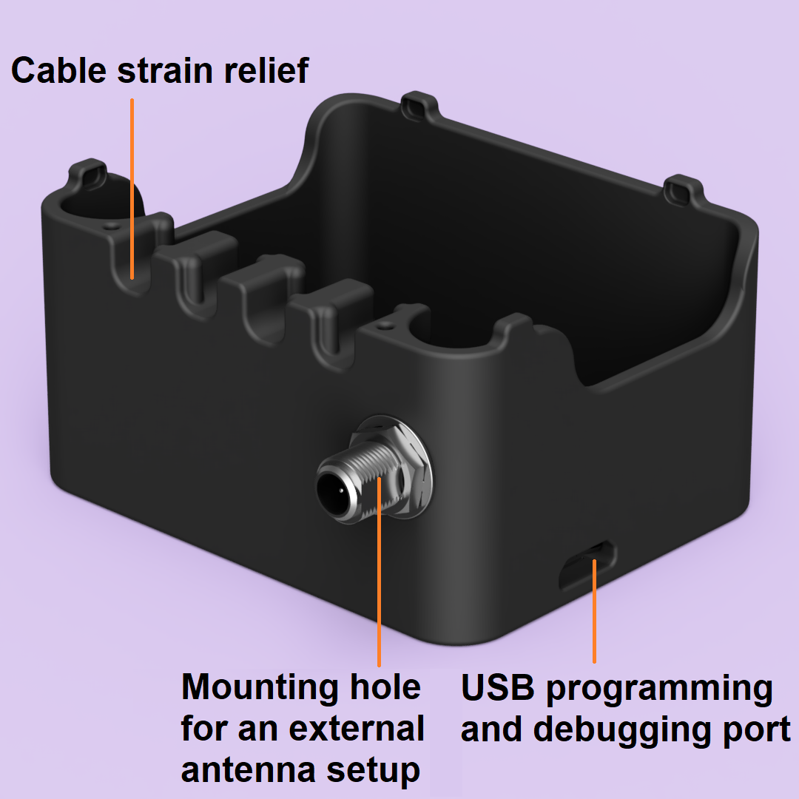
Wiki/V2/GTRR_V4_2B.png
