GrechTech/RetroRosetta/Wiki/V2/RR_IO.png

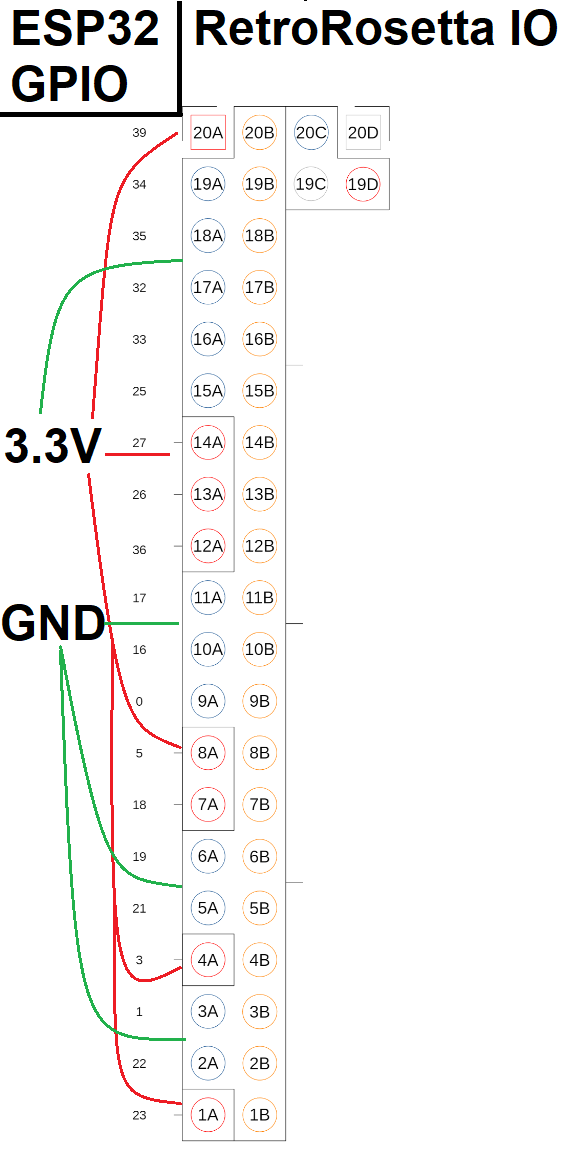
Wiki/V2/RR_IO.png
