GrechTech/RetroRosetta/Wiki/WEB.png

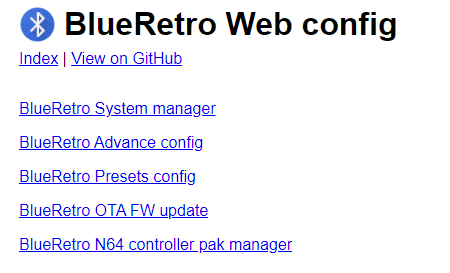
Wiki/WEB.png
