GrechTech/RetroRosetta/Wiki/WiiExt_1P.png

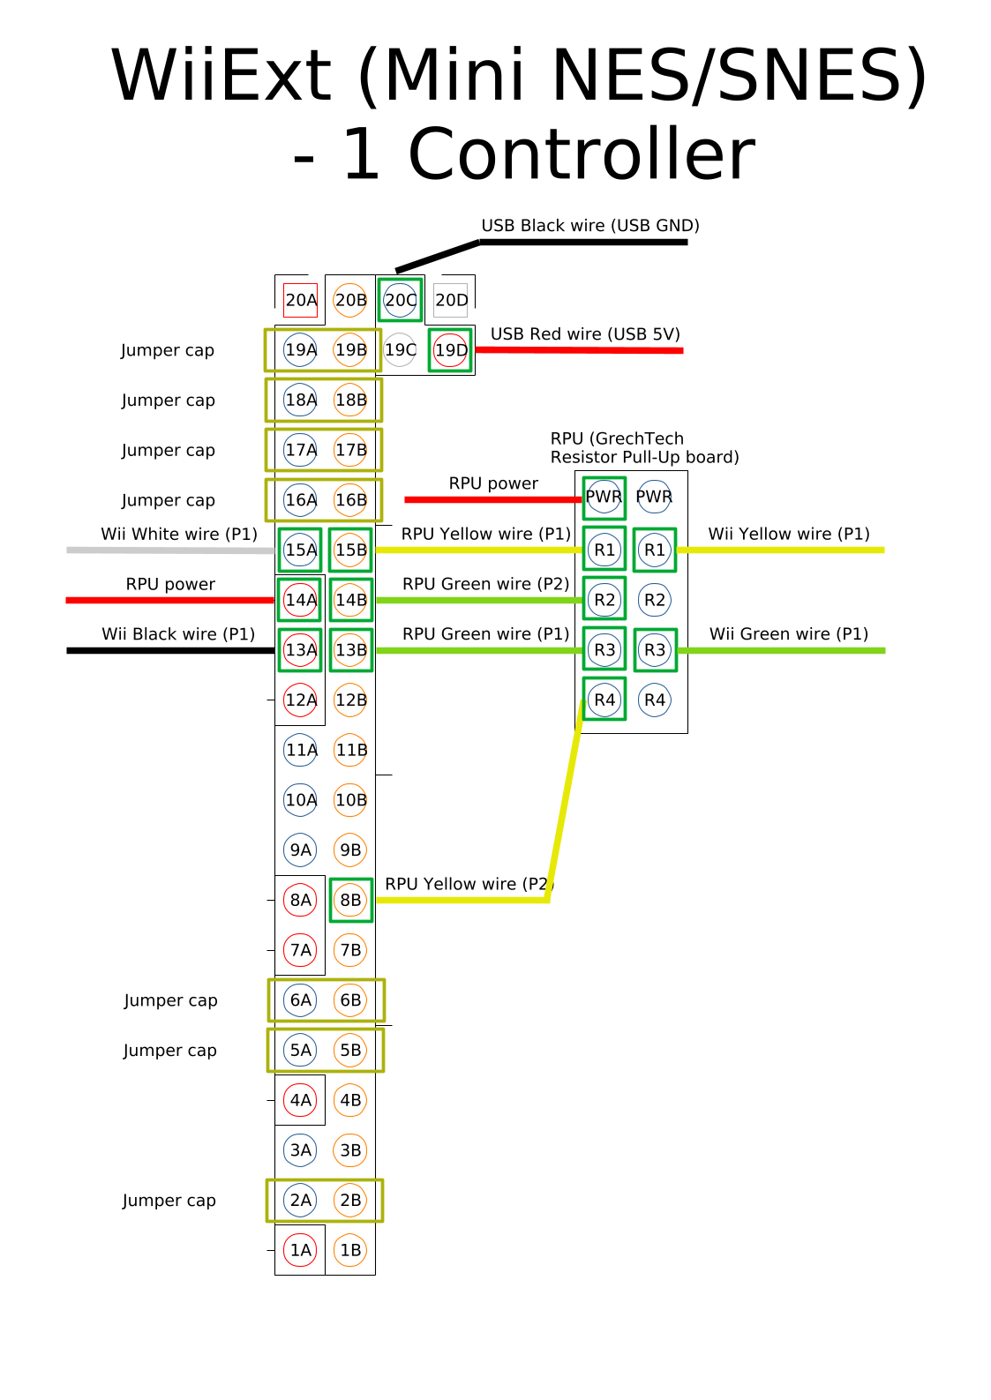
Wiki/WiiExt_1P.png
