GrechTech/RetroRosetta/HW/Case/Case 1 (2022)/Case 1.step

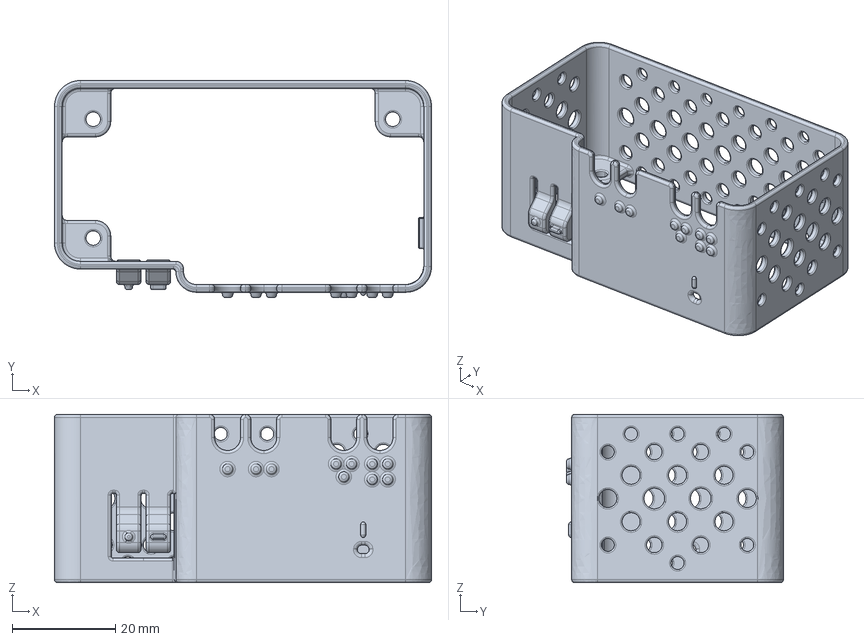
[picture p54: CAD file, 2023-08-14]
HW/Case/Case 1 (2022)/Case 1.step
73.0 x 42.0 x 32.6 mm
