GrechTech/RetroRosetta/HW/V2/Case/Case2.step

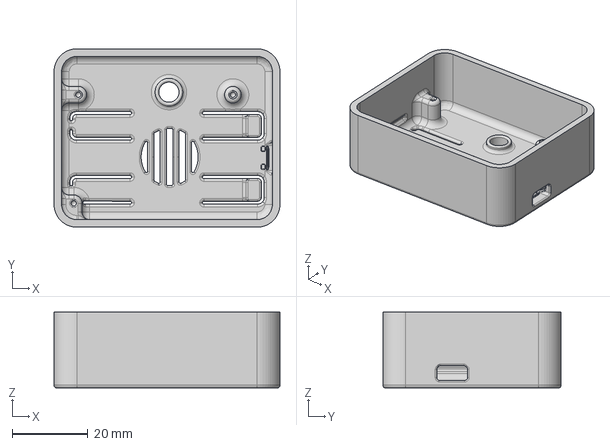
[picture p55: CAD file, 2023-12-24]
HW/V2/Case/Case2.step
59.5 x 47.0 x 20.0 mm
