GrechTech/RetroRosetta/HW/V2/Case/Top2.step

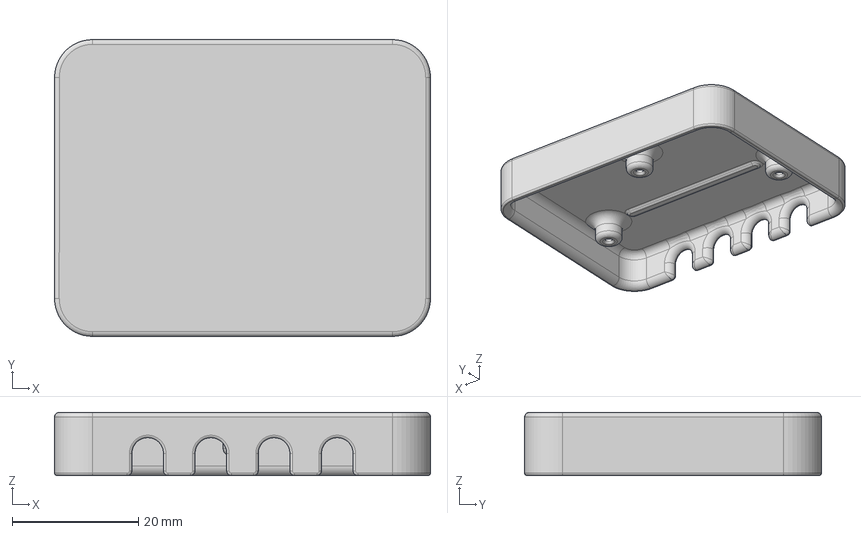
[picture p56: CAD file, 2023-12-24]
HW/V2/Case/Top2.step
59.5 x 47.0 x 10.0 mm
