GrechTech/RetroRosetta/HW/V1/Case/Case Slim (2023 Unreleased)/RetroRosetta Slim2 Assembly.step

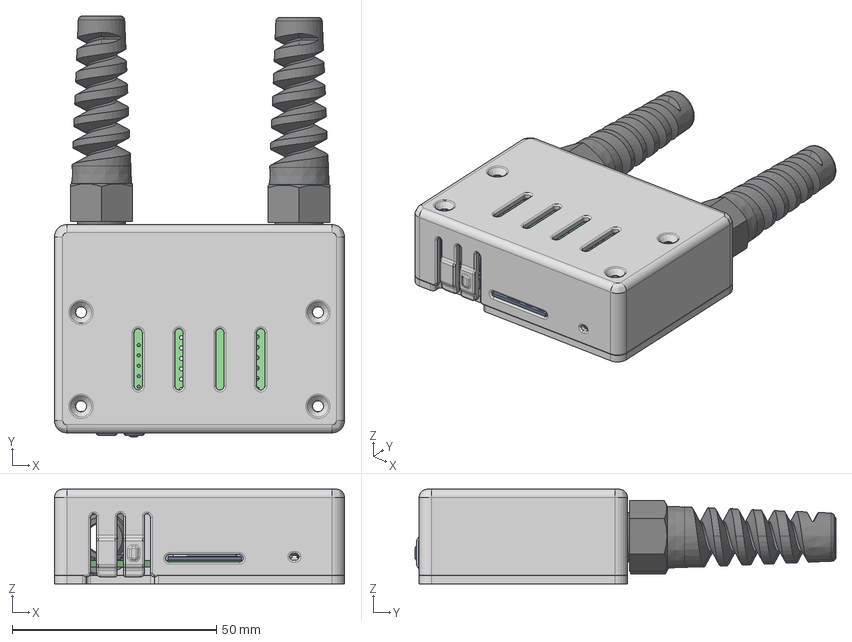
[picture p57: CAD file, 2023-12-24, an earlier design]
HW/V1/Case/Case Slim (2023 Unreleased)/RetroRosetta Slim2 Assembly.step
71.0 x 103.0 x 23.2 mm
RR_5V_HAT PCB
Case Main
Case Btm
