GrechTech/RetroRosetta/HW/V1/Case/Case Slim (2023 Unreleased)/Slim1 Case Main.step

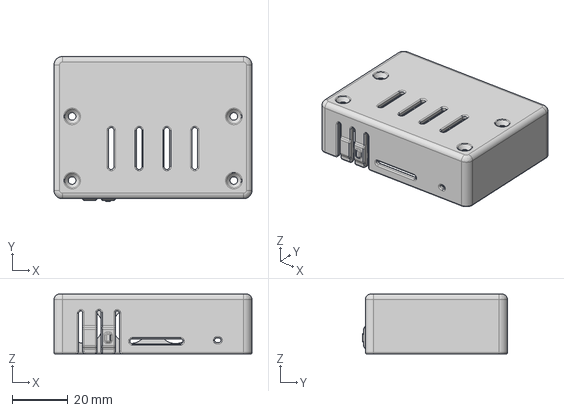
[picture p58: CAD file, 2023-12-24, an earlier design]
HW/V1/Case/Case Slim (2023 Unreleased)/Slim1 Case Main.step
71.0 x 52.0 x 21.5 mm
