GrechTech/RetroRosetta/HW/V1/Case/Case Slim (2023 Unreleased)/RetroRosetta Slim1 Assembly.step

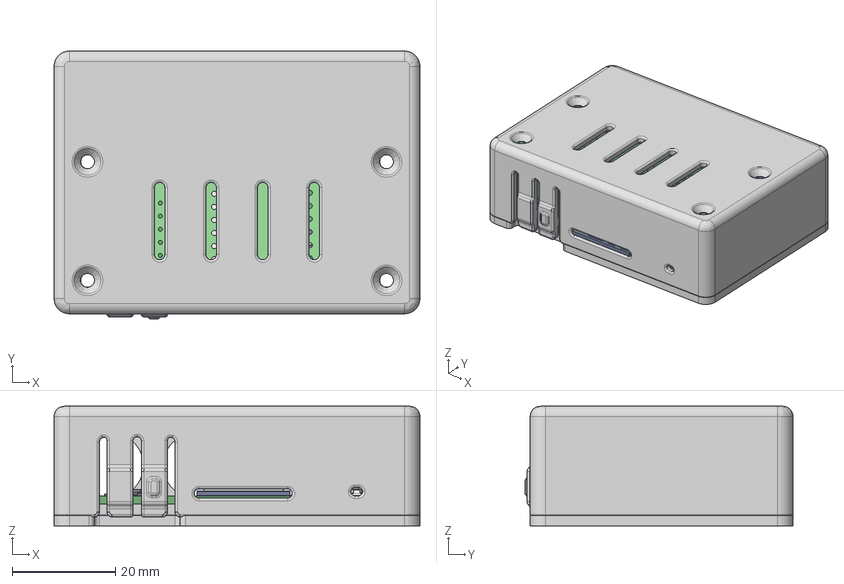
[picture p59: CAD file, 2023-12-24, an earlier design]
HW/V1/Case/Case Slim (2023 Unreleased)/RetroRosetta Slim1 Assembly.step
71.0 x 52.0 x 23.2 mm
RR_5V_HAT PCB
Case Main
Case Btm
