GrechTech/RetroRosetta/HW/V1/Case/Case 1 Alt (2022 Unreleased)/Case C4.step

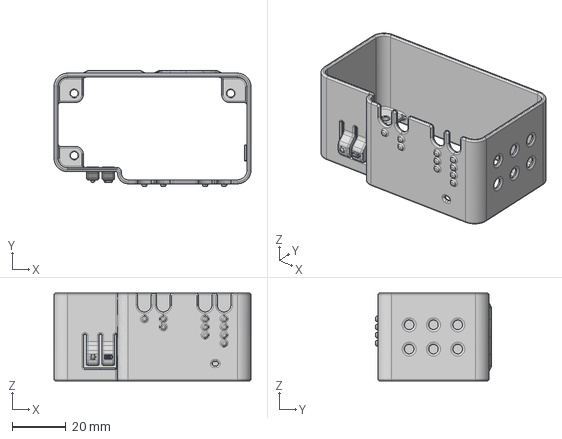
[picture p60: CAD file, 2023-12-24, an earlier design]
HW/V1/Case/Case 1 Alt (2022 Unreleased)/Case C4.step
73.0 x 43.0 x 32.6 mm
