GrechTech/RetroRosetta/HW/V1/Case/Case Extender/Case Ext.step

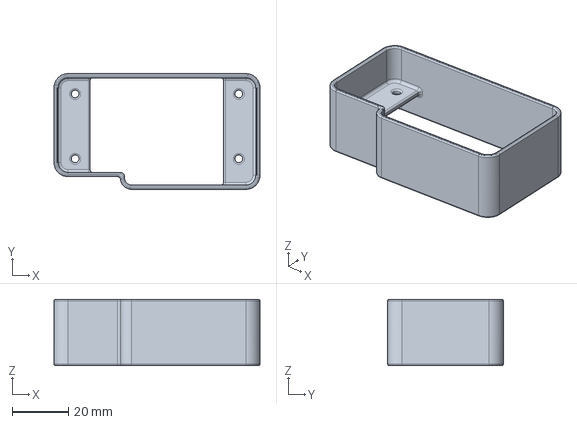
[picture p61: CAD file, 2023-12-24, an earlier design]
HW/V1/Case/Case Extender/Case Ext.step
73.0 x 41.0 x 23.4 mm
