GrechTech/RetroRosetta/HW/V1/Case/Case Extras/Case Flat.step

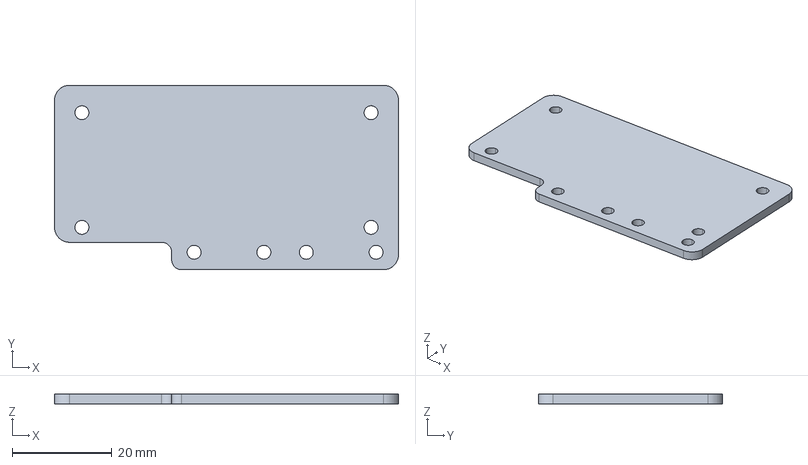
[picture p62: CAD file, 2023-12-24, an earlier design]
HW/V1/Case/Case Extras/Case Flat.step
69.0 x 37.0 x 2.00 mm
