GrechTech/RetroRosetta/HW/V1/PCB/RetroRosettaLevelShifter/RetroRosettaLevelShifter.step

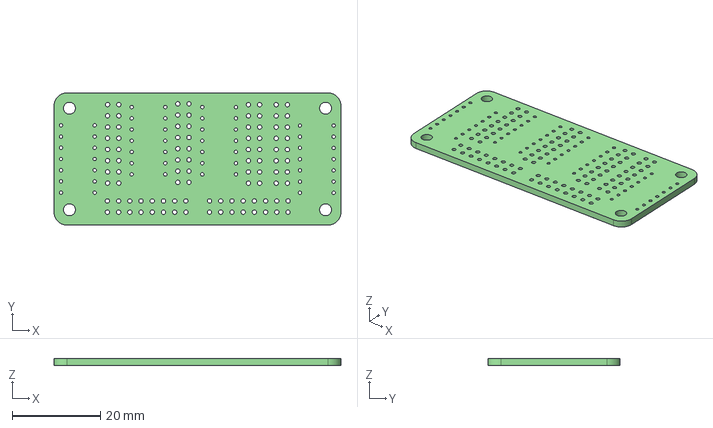
[picture p63: CAD file, 2023-12-24, an earlier design]
HW/V1/PCB/RetroRosettaLevelShifter/RetroRosettaLevelShifter.step
65.0 x 30.0 x 1.60 mm
