GrechTech/RetroRosetta/HW/V1/PCB/RetroRosettaV1/RetroRosettaV1.step

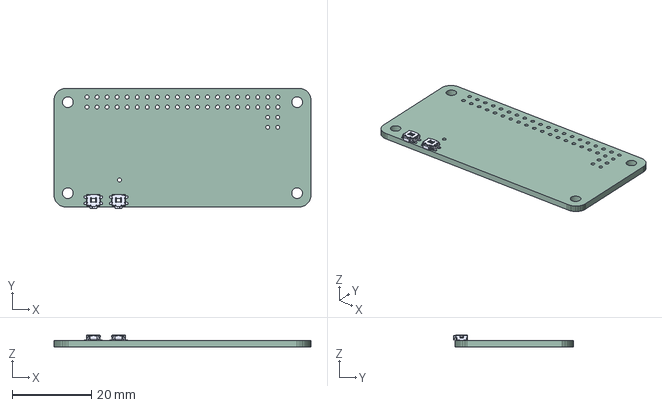
[picture p64: CAD file, 2023-12-24, an earlier design]
HW/V1/PCB/RetroRosettaV1/RetroRosettaV1.step
65.0 x 30.4 x 3.00 mm
PCB
