GrechTech/RetroRosetta/HW/V1/Case/Case 1 Alt (2022 Unreleased)/Case D.step

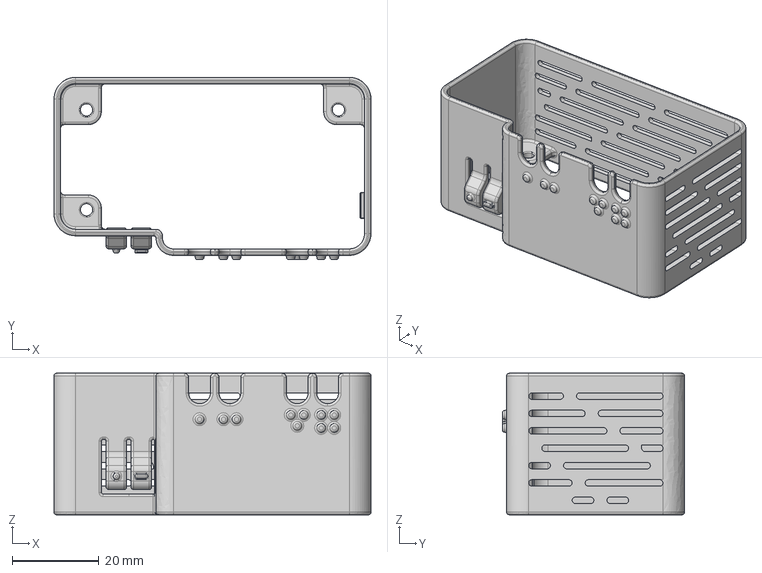
[picture p65: CAD file, 2023-12-24, an earlier design]
HW/V1/Case/Case 1 Alt (2022 Unreleased)/Case D.step
73.0 x 42.0 x 32.6 mm
