GrechTech/RetroRosetta/HW/V1/Case/Case Extras/Case Grip.step

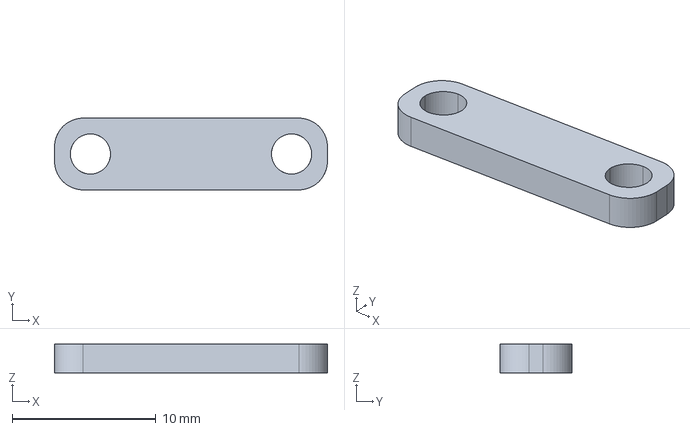
[picture p66: CAD file, 2023-12-24, an earlier design]
HW/V1/Case/Case Extras/Case Grip.step
19.0 x 5.00 x 2.00 mm
