GrechTech/RetroRosetta/HW/V1/Case/Case Slim (2023 Unreleased)/Slim2 Case Btm.step

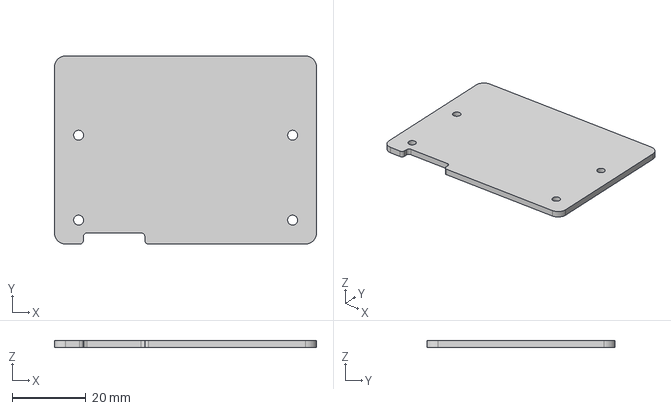
[picture p67: CAD file, 2023-12-24, an earlier design]
HW/V1/Case/Case Slim (2023 Unreleased)/Slim2 Case Btm.step
71.0 x 51.0 x 2.00 mm
