GrechTech/RetroRosetta/(list of files, cad)

Other CAD files:
HW/V1/Case/Case Slim (2023 Unreleased)/Slim2 Case Main.step
HW/V1/Case/Case 1 Alt (2022 Unreleased)/Case C.step
HW/V1/Case/Case Slim (2023 Unreleased)/Slim1 Case Btm.step
HW/V1/Case/Case 2 (2023)/Case 2.f3d
HW/V1/Case/Case Extras/Case Flat.stl
HW/V1/Case/Case Extras/Case Grip.stl
