GrechTech/RetroRosetta/Documenation/CaseAssembly.pdf

## Basic Case Assembly

## Parts

8 x M2.5 hex nuts
4 x M2.5 * 35mm bolts
4 x M2.5 * 12mm bolts
4 x M2.5 * 25mm white plastic spacers (Threaded hex)
4 x M2.5 * 2mm white plastic spacers (Unthreaded smooth) 2x Main acrylic case sheet
2 x Cable grip acrylic case

## Recommended tools

PH00 screwdriver
M2.5 hex wrench/spanner OR small mole grips

## Instructions

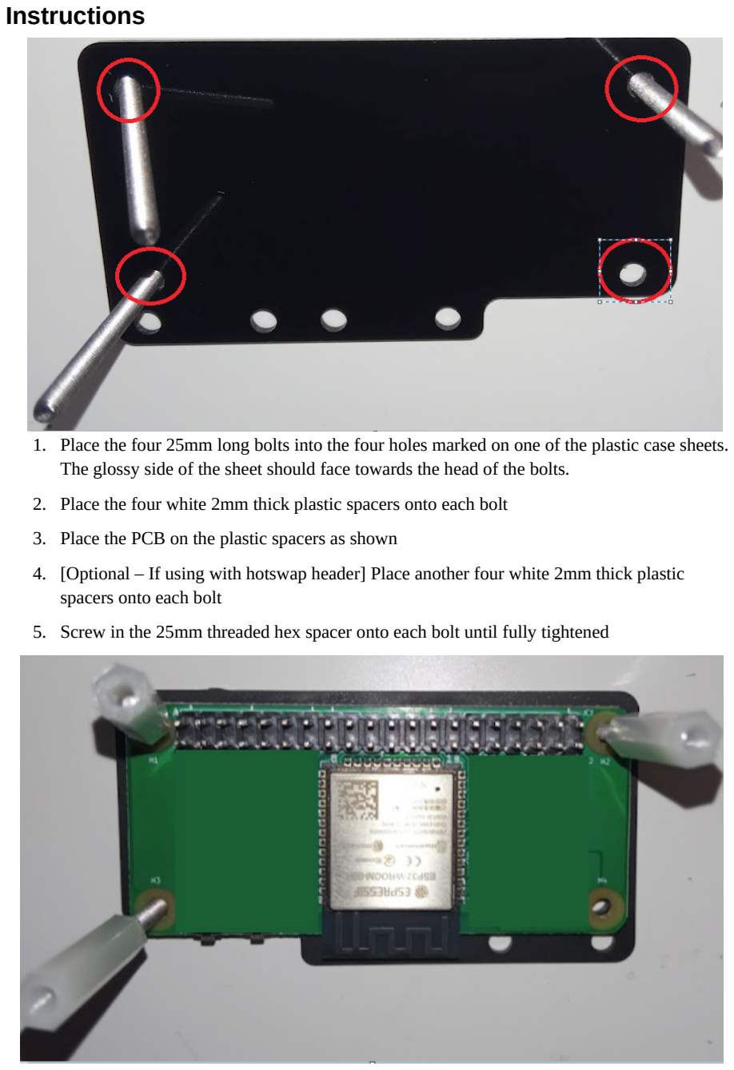
[picture p68: page 2]

1. Place the four 25mm long bolts into the four holes marked on one of the plastic case sheets. The glossy side of the sheet should face towards the head of the bolts.
2. Place the four white 2mm thick plastic spacers onto each bolt
3. Place the PCB on the plastic spacers as shown
4. [Optional – If using with hotswap header] Place another four white 2mm thick plastic spacers onto each bolt
5. Screw in the 25mm threaded hex spacer onto each bolt until fully tightened

6. Complete the cable and jumper connection process for your system
7. Lay the cable out across the 2nd piece of acrylic with the glossy side up like so

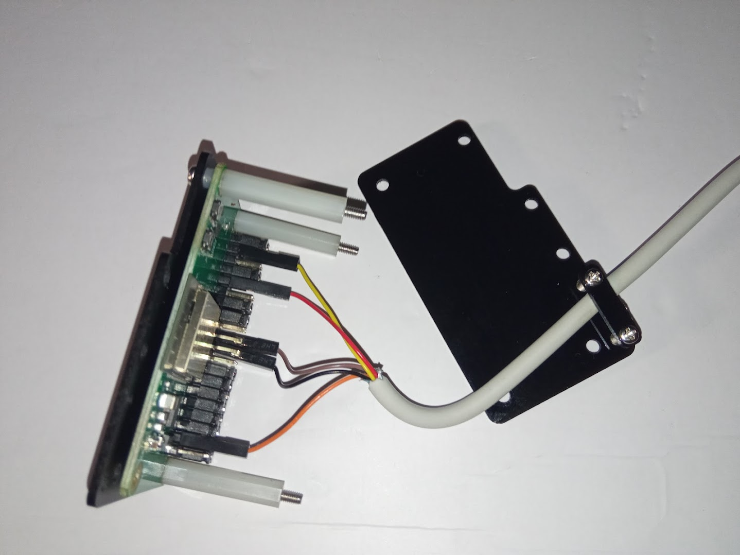
[picture p69: figure]

8. Insert the 15mm long bolts into the holes shown and place the cables between the bolts
9. Add the cable grip acrylic piece to the bolts over the cables as shown
10. Use M2.5 nuts to lightly secure the grip in place
11. Repeat steps 6 to 8 for the 2nd grip if 2 to 4 cables are used
12. Pull the cable through until it is a length that allows you to easily place the final case sheet atop the spacers, with the matte side of the sheet facing up
13. Secure the top piece to the bolts with four nuts

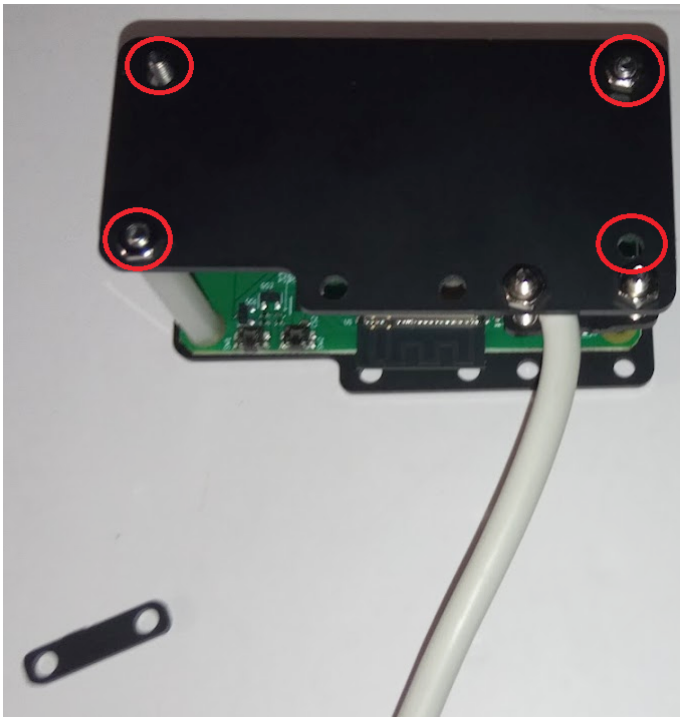
[picture p70: figure]
