GrechTech/RetroRosetta/Documenation/V2/3DO Soldering guide.pdf

# SNES Soldering guide

## 1 CONFIGURATION JUMPERS

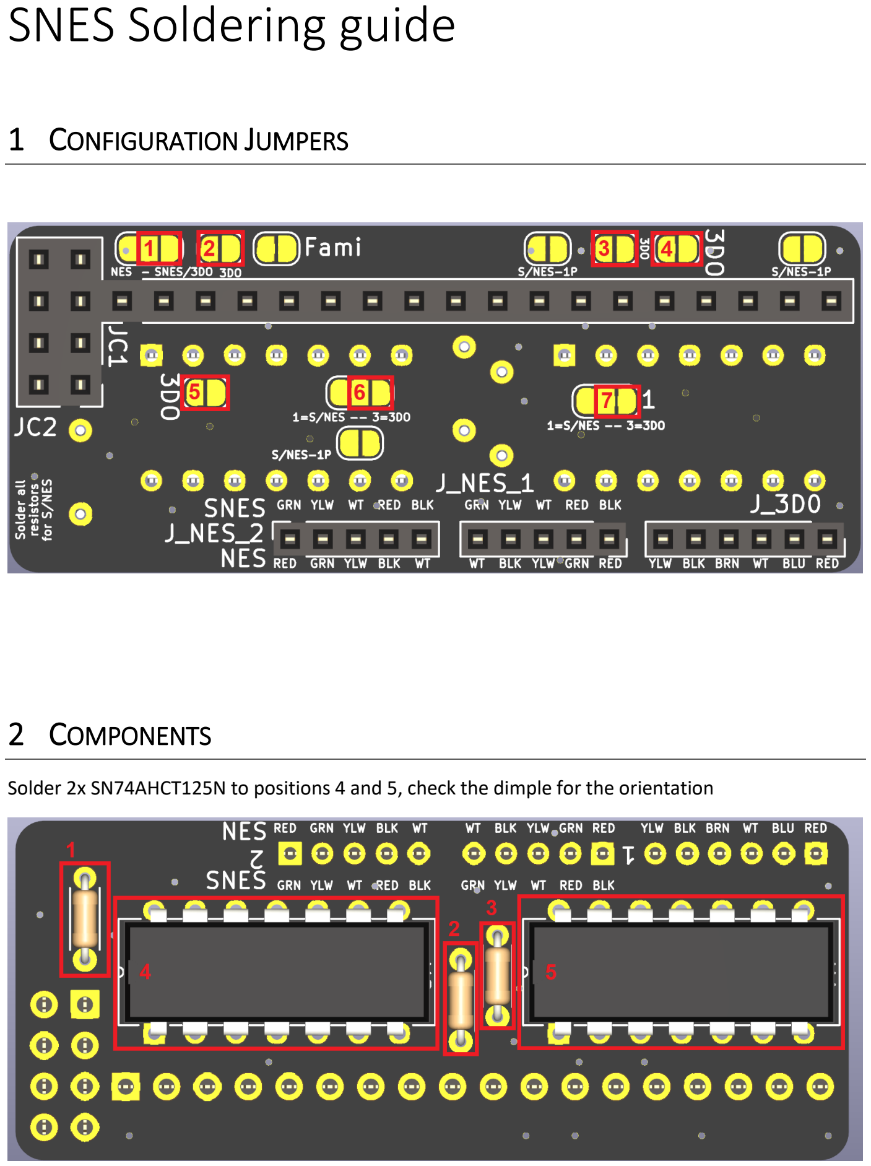
[picture p77: page 1]

## 2 COMPONENTS

Solder 2x SN74AHCT125N to positions 4 and 5, check the dimple for the orientation

## 3 HEADERS

Facing the same side as the configuration pins, solder:

1x20 2.54mm socket header

2x4 2.54mm socket header

1x2 2.54mm socket header

## 4 CONNECTORS

Solder the controller cables to J_3DO ensuring you follow the colour guide.
