GrechTech/RetroRosetta/Documenation/V2/DC Soldering guide.pdf

# DC Soldering guide

### 1 CONFIGURATION JUMPERS

### 1.1 4 PLAYER

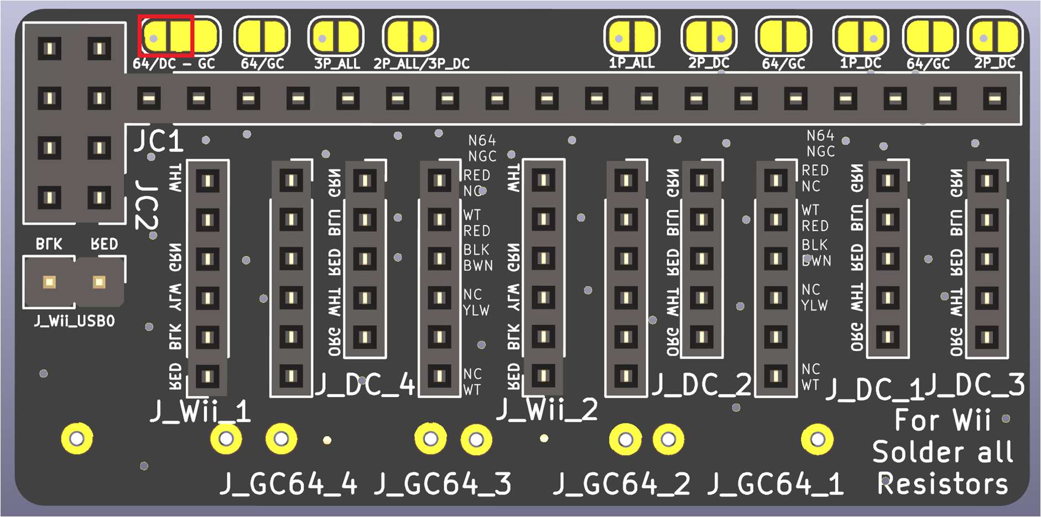
[picture p78: figure]

### 2 HEADERS

Facing the same side as the configuration pins, solder: 1x20 2.54mm socket header
2x4 2.54mm socket header
1x2 2.54mm socket header

### 3 REVISED CONNECTOR GUIDE

Solder the controller cables to J_DC_1 to J_DC_4. If your model was bought after August 2023, it’s likely you will need the following revised colour guide:

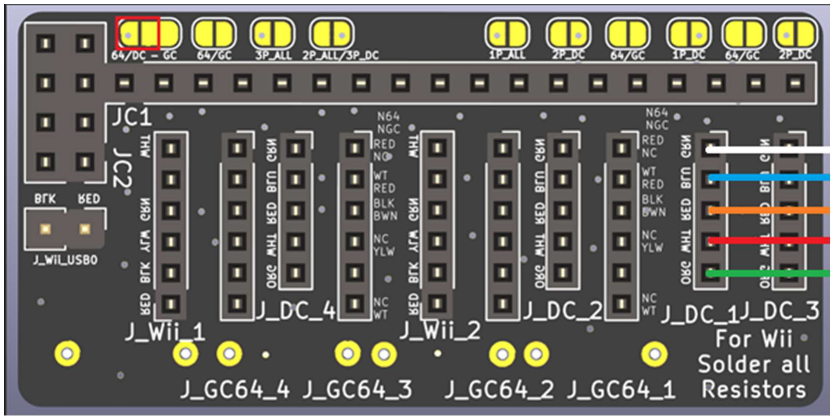
[picture p79: figure]

PCB Colour Name → Cable Colour | → Pinout
Green | → White | → Ground
Blue | → Blue | → Sense
Red | → Orange | → Data 1
White | → Red | → Data 2
Orange | → Green | → VCC

### 4 CONNECTORS [ORIGINAL]

Solder the controller cables to J_DC_1 to J_DC_4. If your cable is a pre August 2023 model using the following wire colours, then follow the PCBs colour guides for the wires. If your model was bought after August 2023, please note our supplier of Dreamcast cables changed their wire colours, see the guide further below.

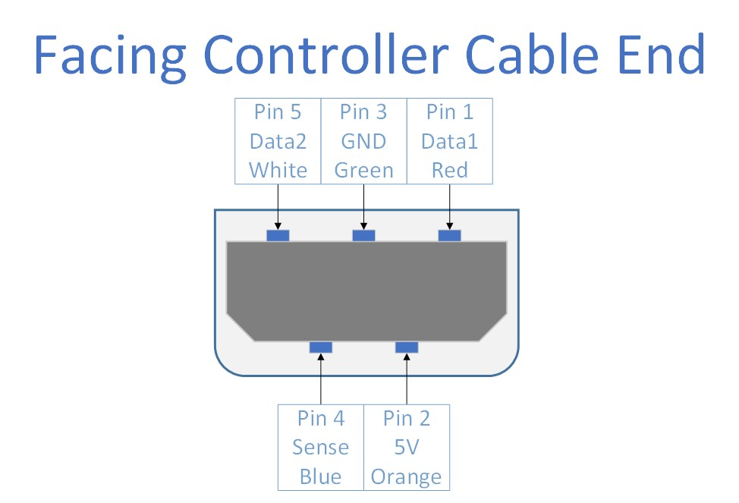
[picture p80: figure]
