GrechTech/RetroRosetta/Documenation/V2/GC Soldering guide.pdf

# NGC Soldering guide

## 1 CONFIGURATION JUMPERS

### 1.1 4 PLAYER

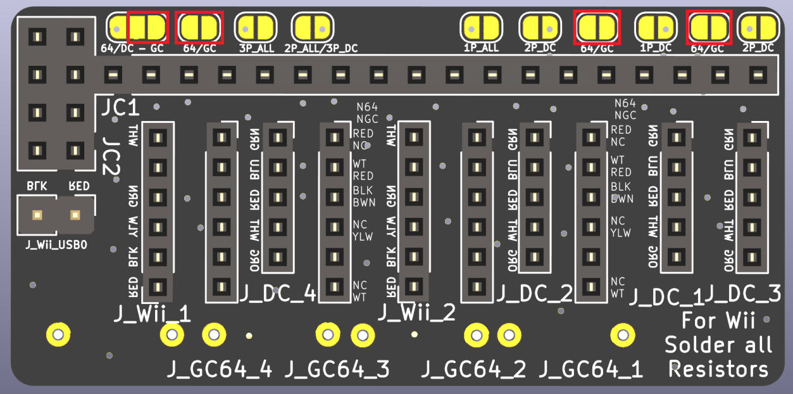
[picture p81: figure]

## 2 HEADERS

Facing the same side as the configuration pins, solder:

1x20 2.54mm socket header

2x4 2.54mm socket header

1x2 2.54mm socket header

## 3 CONNECTORS

Solder the controller cables to J_GC64_1 to J_GC64_4, using the colour guides for the NGC (Lower colours on the silkscreen)
