GrechTech/RetroRosetta/Documenation/V2/Genesis Soldering guide.pdf

# Saturn Soldering guide

## 1 CONFIGURATION JUMPERS

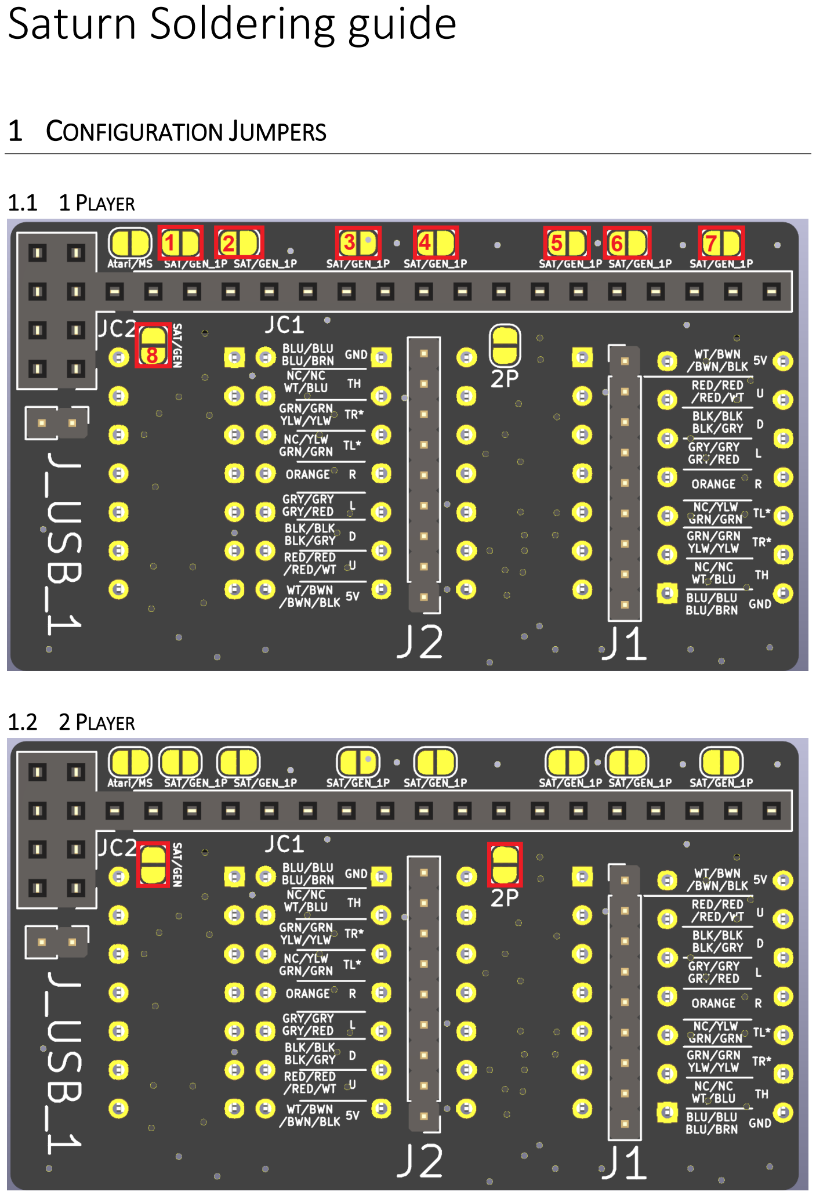
[picture p82: page 1]

### 1.1 1 PLAYER

### 1.2 2 PLAYER

## 2 COMPONENTS

Solder 4x SN74AHCT125N, check the dimple for the orientation


## 3 HEADERS

Facing the same side as the configuration pins, solder:

1x20 2.54mm socket header

2x4 2.54mm socket header

1x2 2.54mm socket header

## 4 CONNECTORS

Solder the controller cables to J1 and J2, ensuring you follow the Genesis colour guide (The third, bottom left colour).
