GrechTech/RetroRosetta/Documenation/V2/PS Soldering guide.pdf

# PSX Soldering guide

## 1 CONFIGURATION JUMPERS

### 1.1 1 PLAYER

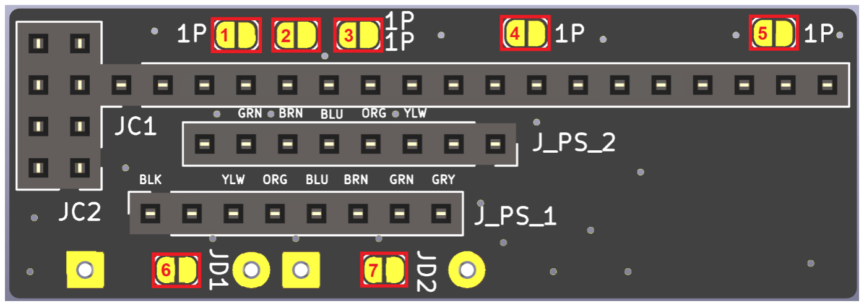
[picture p85: figure]

### 1.2 2 PLAYER

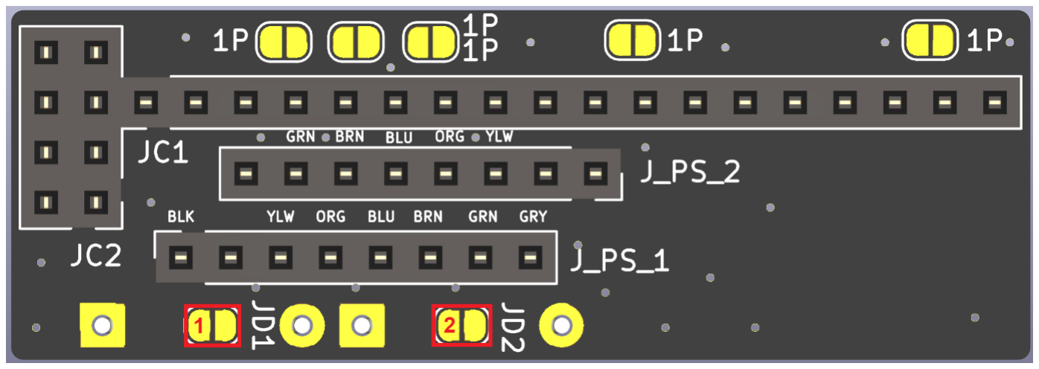
[picture p86: figure]

## 2 HEADERS

Facing the same side as the configuration pins, solder:

1x20 2.54mm socket header

2x4 2.54mm socket header

1x2 2.54mm socket header

## 3 CONNECTORS

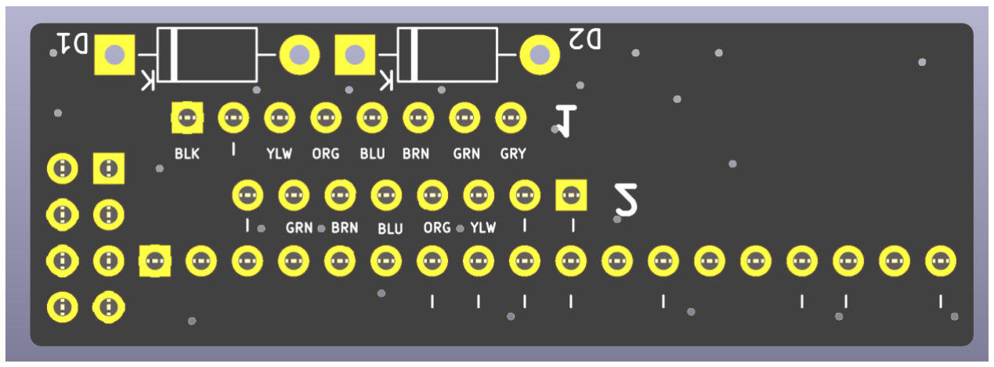
[picture p87: figure]

Solder the controller cables to J_PS_1 and for 2 players, J_PS_2, ensuring you follow the colour guide.
