GrechTech/RetroRosetta/Documenation/V2/Wii Soldering guide.pdf

# Wii - Mini NES / SNES Soldering guide

## 1 CONFIGURATION JUMPERS

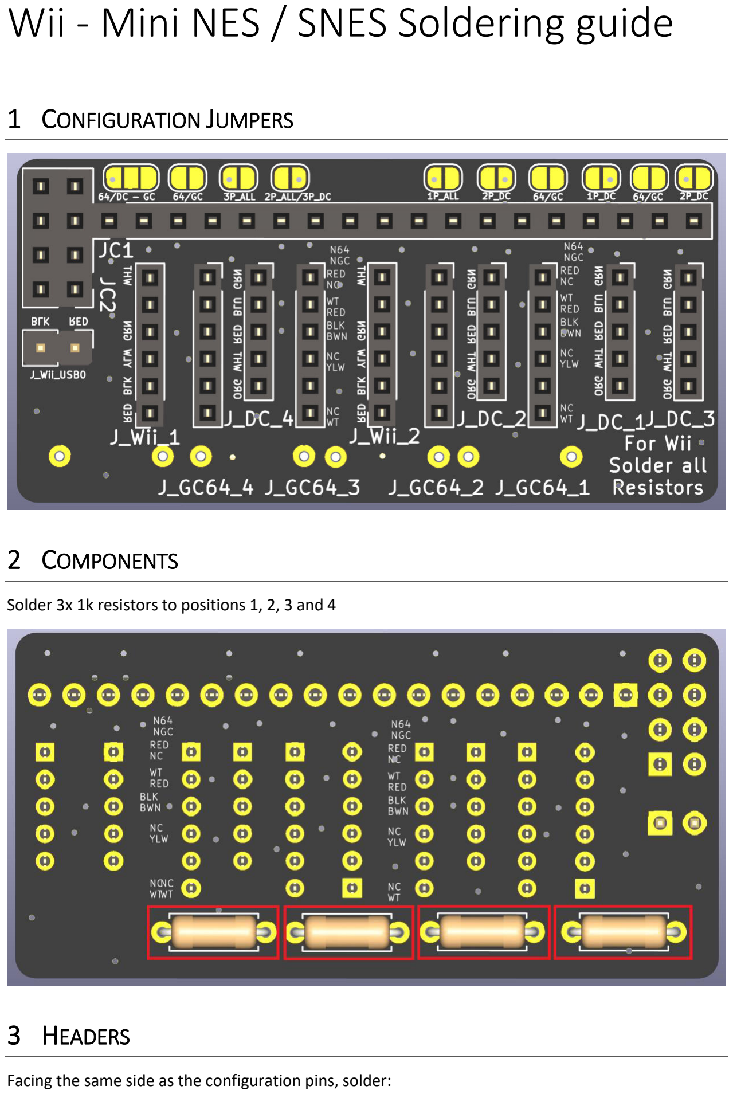
[picture p90: page 1]

## 2 COMPONENTS

Solder 3x 1k resistors to positions 1, 2, 3 and 4

## 3 HEADERS

Facing the same side as the configuration pins, solder:

1x20 2.54mm socket header

2x4 2.54mm socket header

1x2 2.54mm socket header

## 4 CONNECTORS

Solder the controller cables to J_Wii_1 to J_Wii_4, using the colour guides for the wires.

Solder the USB power input cable to J_Wii_USB0, using the colour guides for the wires.
