GrechTech/RetroRosetta/Documenation/Setup/DC 2 Player Cable Setup Guide.pdf

## Dreamcast cable assembly

1. If recycling a cable from a broken controller, or if using an extension cable, cut the cable 10-40cm from the plug.
2. Strip 3-5 cm of the outer insulation sleeving from the cable
3. Isolate the inner wires from the cable and strip 5mm from each wire
4. Crimp each wire with a female Dupont crimp in line with the crimping guide
5. Repeat steps 1 to 4 for a second cable

## Crimping


1. Place the wire in a female Dupont crimp
2. Fold the pull relief around the wire


3. Use a crimping tool to shrink the connector around the wire ends
4. Slide the connector housing onto the crimp until it mounts, making sure the orientation is correct

## Dreamcast 2 Player connection diagram

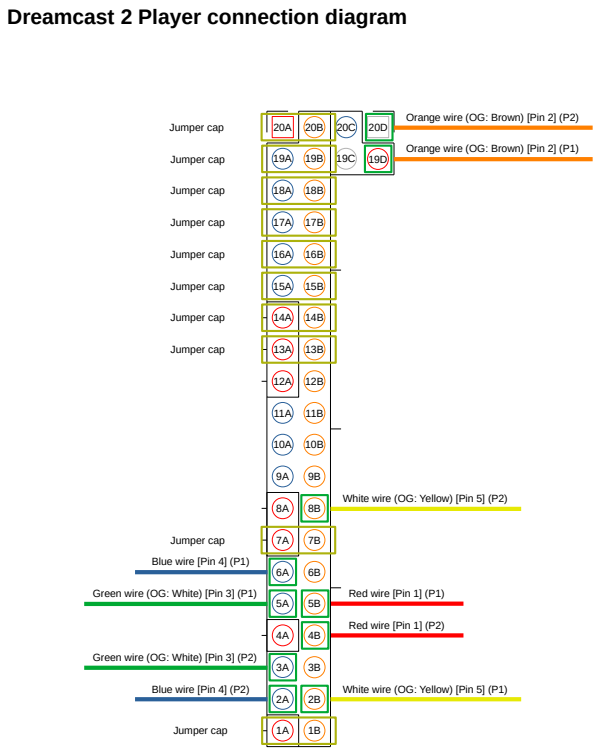
[picture p101: page 2]
Jumper cap

Orange wire (OG: Brown) [Pin 2] (P2)

Orange wire (OG: Brown) [Pin 2] (P1)

White wire (OG: Yellow) [Pin 5] (P2)

Jumper cap
Blue wire [Pin 4] (P1)

Green wire (OG: White) [Pin 3] (P1)

Red wire [Pin 1] (P1)

Red wire [Pin 1] (P2)

Green wire (OG: White) [Pin 3] (P2)

Blue wire [Pin 4] (P2)

White wire (OG: Yellow) [Pin 5] (P1)

## Dreamcast 2 Player connection guide

1. Place the jumper caps on rows 1, 7, 13, 14, 15, 16, 17, 18, 19, 20
2. Connect the blue wire [Pin 4] of Player 1 to pin 2A
3. Connect the white (OG yellow) wire [Pin 5] of Player 1 to pin 5B
4. Connect the red wire [Pin 1] of Player 1 to pin 5B
5. Connect the green (OG white) wire [Pin 3] of Player 1 to pin 5A
6. Connect the orange (OG brown) wire [Pin 2] of Player 1 to pin 19D
7. Connect the blue wire [Pin 4] of Player 2 to pin 8A
8. Connect the white (OG yellow) wire [Pin 5] of Player 2 to pin 8B
9. Connect the red wire [Pin 1] of Player 2 to pin 4B
10. Connect the green (OG white) wire [Pin 3] of Player 2 to pin 4A
11. Connect the orange (OG brown) wire [Pin 2] of Player 2 to pin 19C or leave disconnected
1. Connections should now resemble the diagram
