GrechTech/RetroRosetta/Documenation/Setup/IO.pdf

# IO General

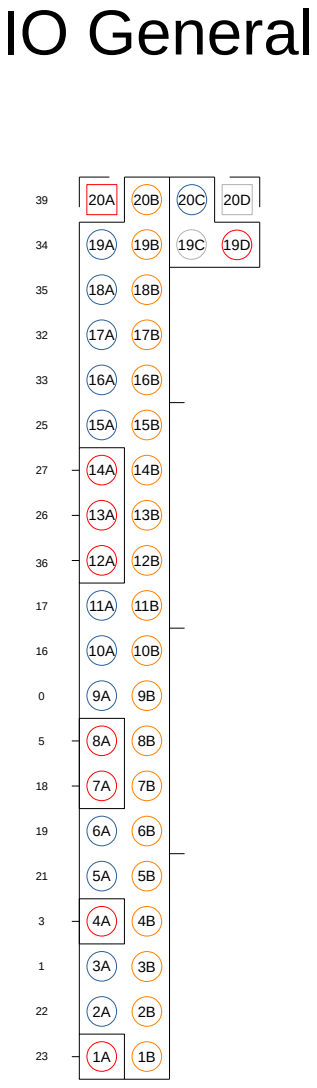
[picture p104: page 1]

# N64 – 1 Controller

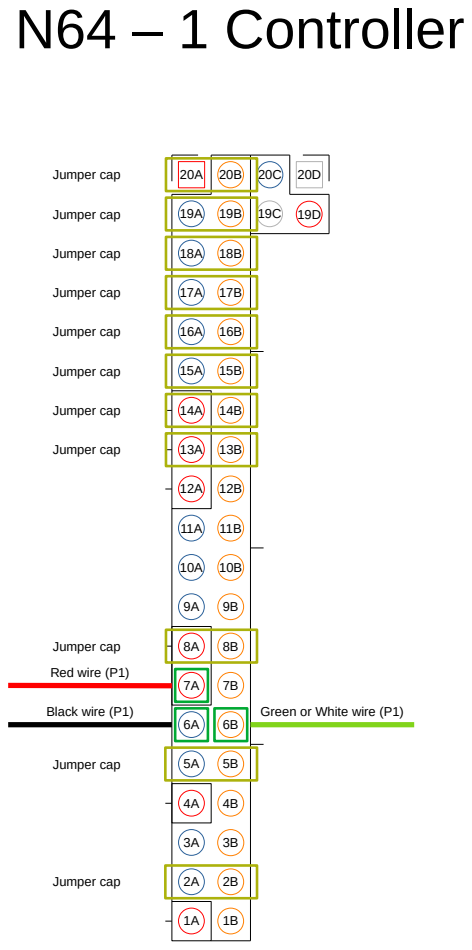
[picture p105: page 2]
Black wire (P1); Green or White wire (P1); Red wire (P1); Jumper cap

# N64 – 2 Controller

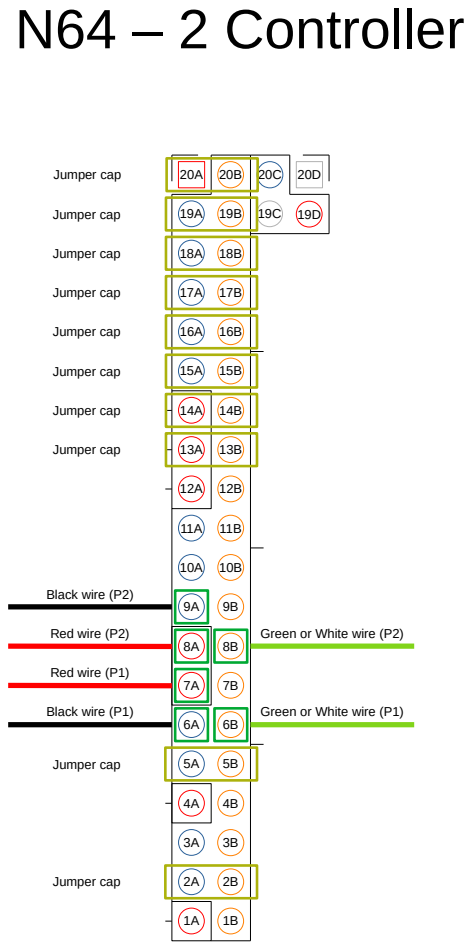
[picture p106: page 3]
Black wire (P1); Green or White wire (P1); Red wire (P1); Jumper cap; Black wire (P2); Red wire (P2)

Green or White wire (P2)

# N64 – 3 Controller

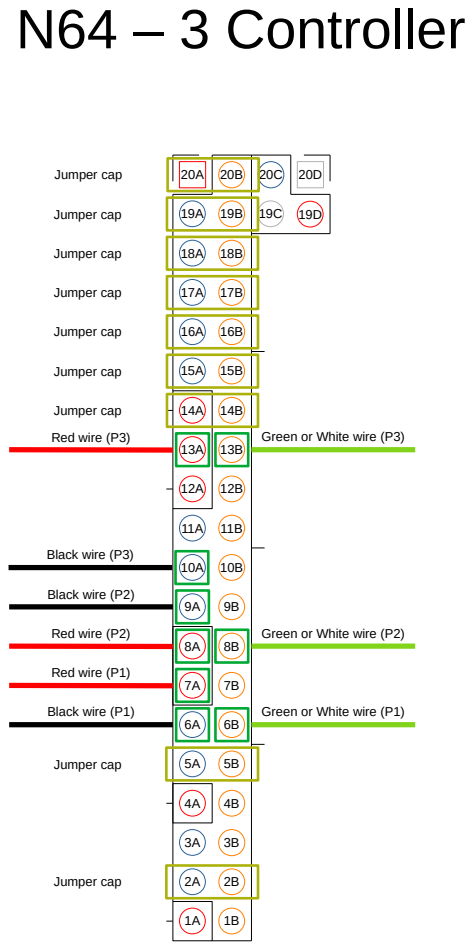
[picture p107: page 4]
Black wire (P1); Green or White wire (P1); Red wire (P1); Jumper cap; Black wire (P2); Red wire (P2); Red wire (P3); Green or White wire (P3); Black wire (P3)

Green or White wire (P2)

# N64 – 4 Controller

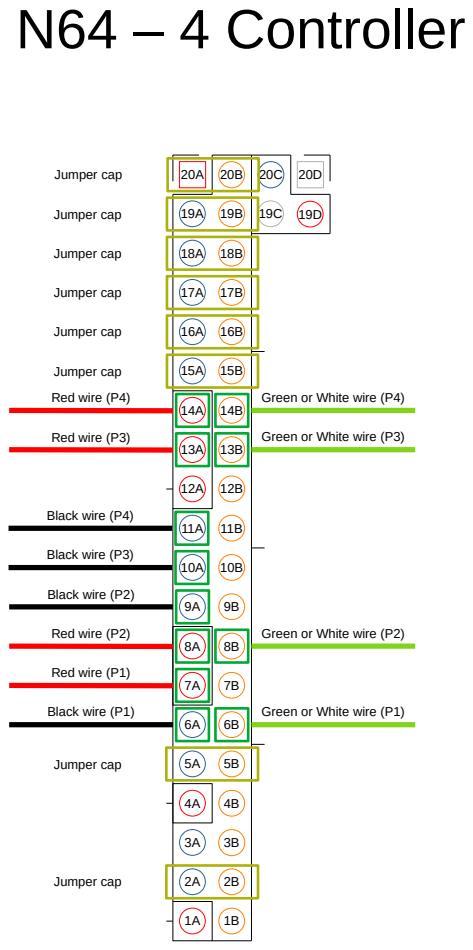
[picture p108: page 5]
Black wire (P1); Green or White wire (P1); Red wire (P1); Jumper cap; Black wire (P2); Red wire (P2); Red wire (P3); Green or White wire (P3); Black wire (P3); Black wire (P4); Red wire (P4); Green or White wire (P4)

Green or White wire (P2)

# GC – 1 Controller

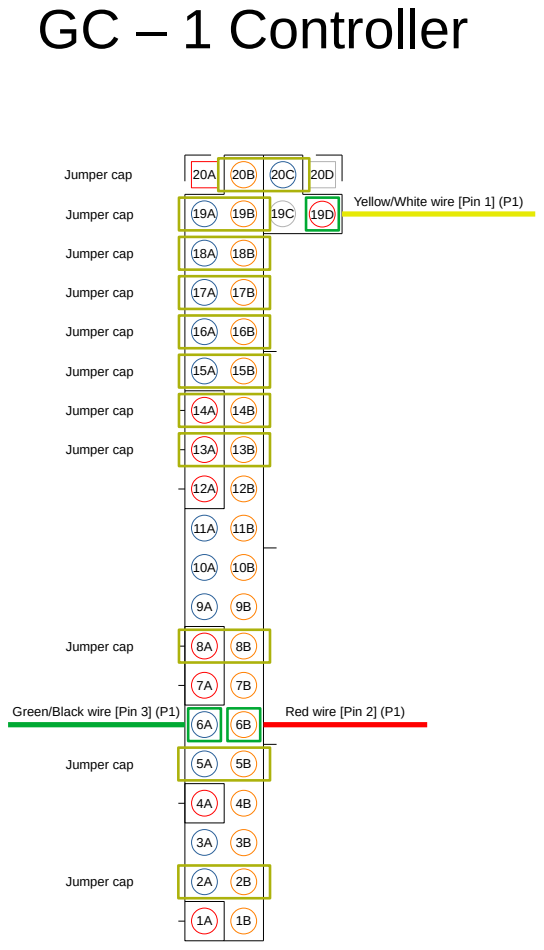
[picture p109: page 6]
Green/Black wire [Pin 3] (P1); Red wire [Pin 2] (P1); Jumper cap

Yellow/White wire [Pin 1] (P1)

# GC – 2 Controller

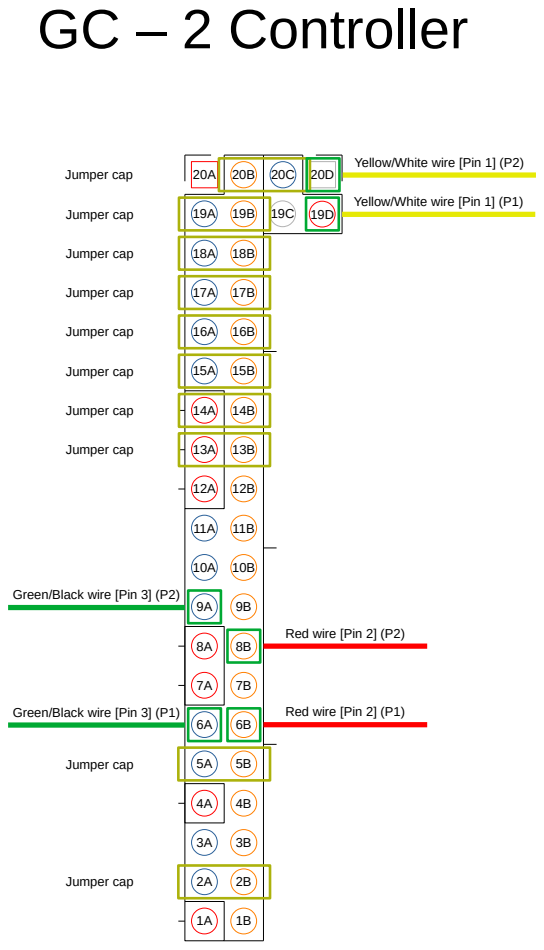
[picture p110: page 7]
Jumper cap

Yellow/White wire [Pin 1] (P2)

Yellow/White wire [Pin 1] (P1)

Green/Black wire [Pin 3] (P2)

Red wire [Pin 2] (P2)

Green/Black wire [Pin 3] (P1)

Red wire [Pin 2] (P1)

# GC – 3 Controller

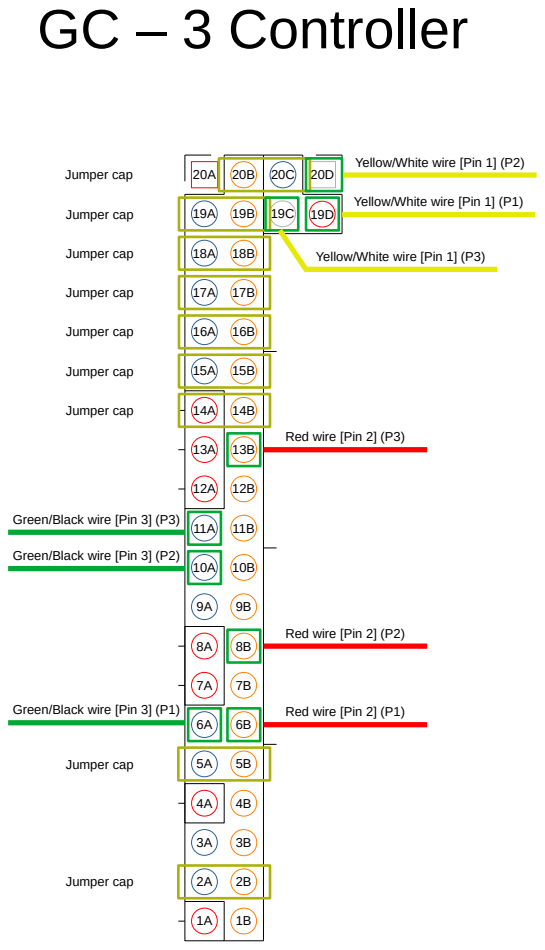
[picture p111: page 8]
Jumper cap

Yellow/White wire [Pin 1] (P2)

Yellow/White wire [Pin 1] (P1)

Yellow/White wire [Pin 1] (P3)

Red wire [Pin 2] (P3)

Green/Black wire [Pin 3] (P3)

Green/Black wire [Pin 3] (P2)

Red wire [Pin 2] (P2)

Green/Black wire [Pin 3] (P1)

Red wire [Pin 2] (P1)

# GC – 4 Controller

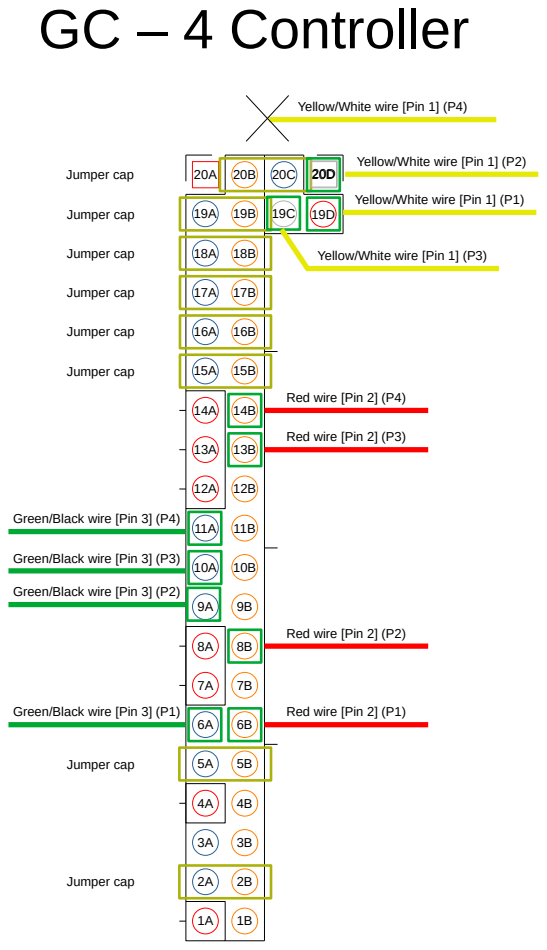
[picture p112: page 9]
Jumper cap

Yellow/White wire [Pin 1] (P4)

Yellow/White wire [Pin 1] (P2)

Yellow/White wire [Pin 1] (P1)

Yellow/White wire [Pin 1] (P3)

Red wire [Pin 2] (P4)

Red wire [Pin 2] (P3)

Green/Black wire [Pin 3] (P4)

Green/Black wire [Pin 3] (P3)

Green/Black wire [Pin 3] (P2)

Red wire [Pin 2] (P2)

Green/Black wire [Pin 3] (P1)

Red wire [Pin 2] (P1)

# DC – 1 Controller

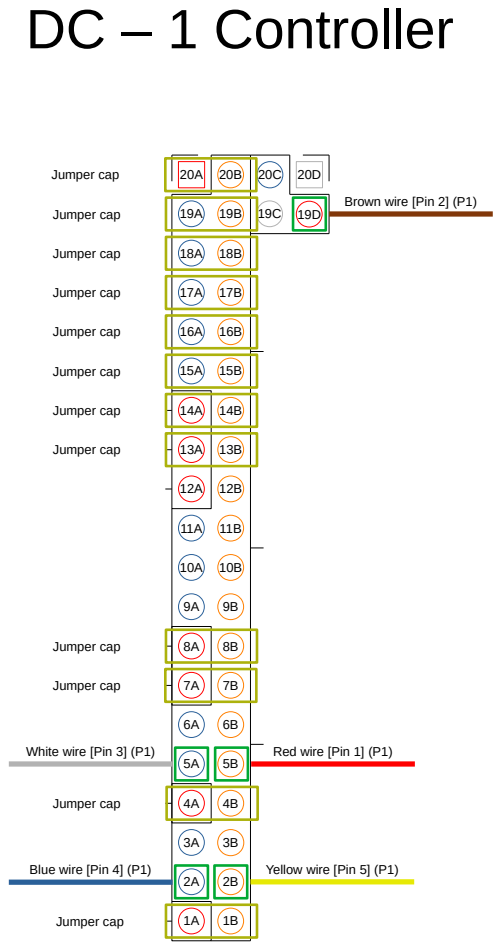
[picture p113: page 10]
Jumper cap

Brown wire [Pin 2] (P1)

White wire [Pin 3] (P1)

Red wire [Pin 1] (P1)

Blue wire [Pin 4] (P1)

Yellow wire [Pin 5] (P1)

# DC – 2 Controller

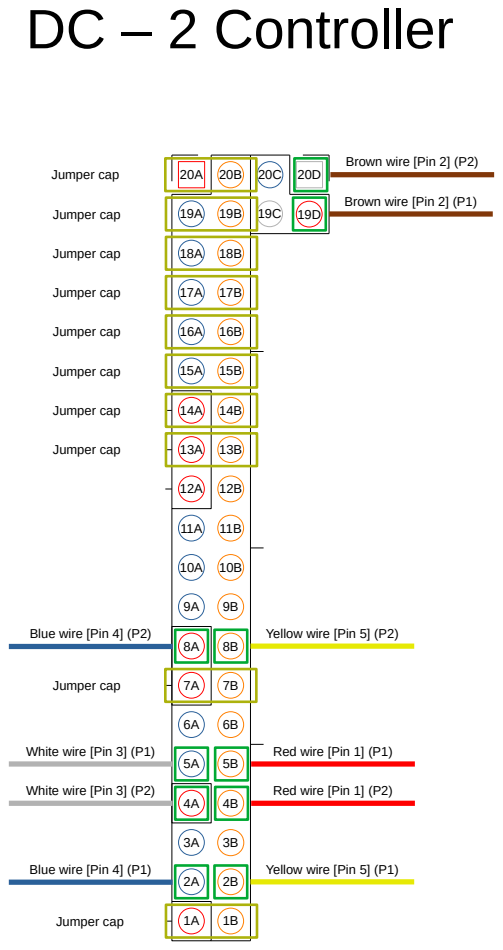
[picture p114: page 11]
Jumper cap; White wire [Pin 3] (P2); Red wire [Pin 1] (P2); Blue wire [Pin 4] (P2); Yellow wire [Pin 5] (P2)

Brown wire [Pin 2] (P2)

Brown wire [Pin 2] (P1)

White wire [Pin 3] (P1)

Red wire [Pin 1] (P1)

Blue wire [Pin 4] (P1)

Yellow wire [Pin 5] (P1)

# DC – 3 Controller

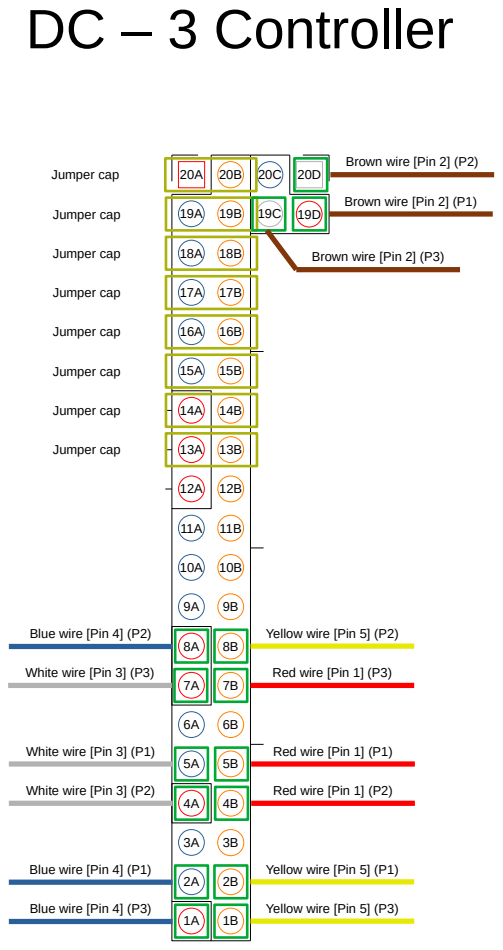
[picture p115: page 12]
Jumper cap; White wire [Pin 3] (P2); Red wire [Pin 1] (P2); Blue wire [Pin 4] (P2); Yellow wire [Pin 5] (P2); White wire [Pin 3] (P3); Red wire [Pin 1] (P3); Blue wire [Pin 4] (P3); Yellow wire [Pin 5] (P3)

Brown wire [Pin 2] (P2)

Brown wire [Pin 2] (P1)

Brown wire [Pin 2] (P3)

White wire [Pin 3] (P1)

Red wire [Pin 1] (P1)

Blue wire [Pin 4] (P1)

Yellow wire [Pin 5] (P1)

# DC – 4 Controller

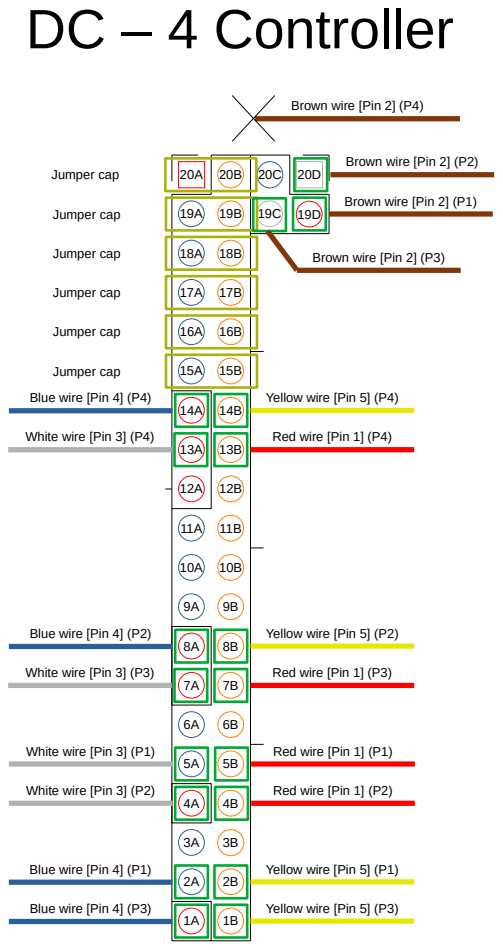
[picture p116: page 13]
Jumper cap; White wire [Pin 3] (P2); Red wire [Pin 1] (P2); Blue wire [Pin 4] (P2); Yellow wire [Pin 5] (P2); White wire [Pin 3] (P3); Red wire [Pin 1] (P3); Blue wire [Pin 4] (P3); Yellow wire [Pin 5] (P3); White wire [Pin 3] (P4); Red wire [Pin 1] (P4); Blue wire [Pin 4] (P4); Yellow wire [Pin 5] (P4)

Brown wire [Pin 2] (P4)

Brown wire [Pin 2] (P2)

Brown wire [Pin 2] (P1)

Brown wire [Pin 2] (P3)

White wire [Pin 3] (P1)

Red wire [Pin 1] (P1)

Blue wire [Pin 4] (P1)

Yellow wire [Pin 5] (P1)

# PS1/PS2 – 1 Controller Port

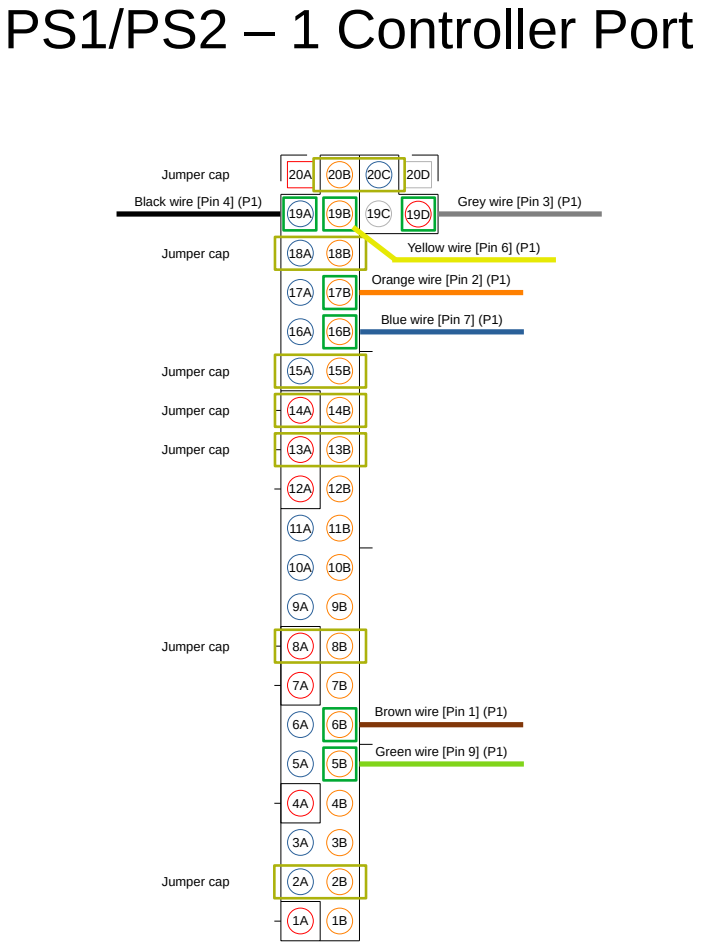
[picture p117: page 14]
Jumper cap

Jumper cap
Black wire [Pin 4] (P1)

Grey wire [Pin 3] (P1)

Yellow wire [Pin 6] (P1)

Orange wire [Pin 2] (P1)

Blue wire [Pin 7] (P1)

Brown wire [Pin 1] (P1)

Green wire [Pin 9] (P1)

# PS1/PS2 – 2 Controller Port

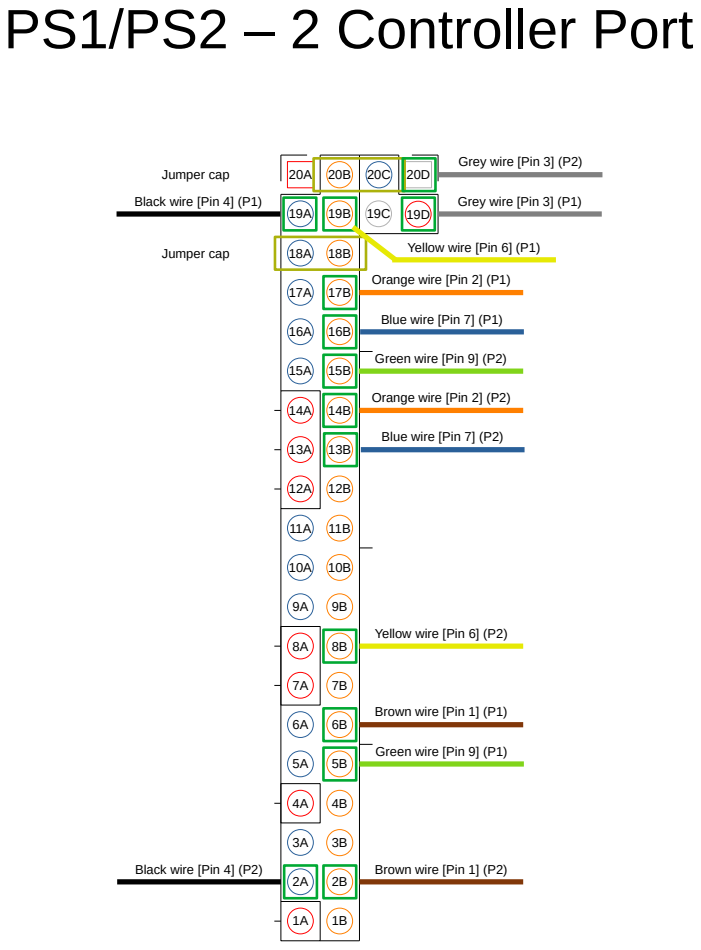
[picture p118: page 15]
Jumper cap

Grey wire [Pin 3] (P2)

Jumper cap
Black wire [Pin 4] (P1)

Grey wire [Pin 3] (P1)

Yellow wire [Pin 6] (P1)

Orange wire [Pin 2] (P1)

Blue wire [Pin 7] (P1)

Green wire [Pin 9] (P2)

Orange wire [Pin 2] (P2)

Blue wire [Pin 7] (P2)

Yellow wire [Pin 6] (P2)

Brown wire [Pin 1] (P1)

Green wire [Pin 9] (P1)

Black wire [Pin 4] (P2)

Brown wire [Pin 1] (P2)
