GrechTech/RetroRosetta/Documenation/Setup/N64 1 Player Cable Setup Guide.pdf

## N64 cable assembly

1. If recycling a cable from a broken controller, or if using an extension cable, cut the cable 10-40cm from the plug.
2. Strip 3-5 cm of the outer insulation sleeving from the cable
3. Isolate the inner wires from the cable and strip 5mm from each wire

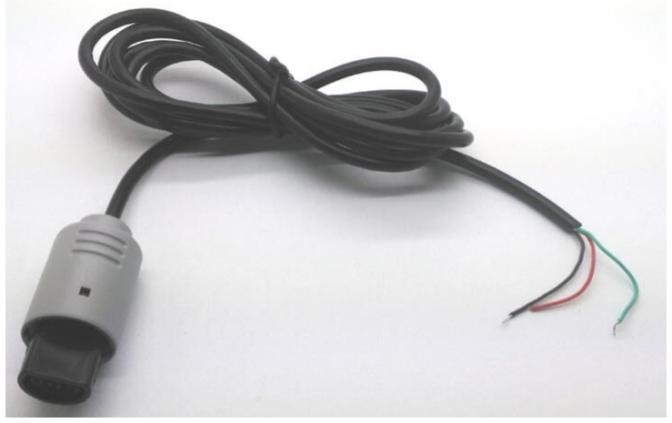
[picture p122: figure]

4. Crimp each wire with a female Dupont crimp in line with the crimping guide

## Crimping

1. Place the wire in a female Dupont crimp
2. Fold the pull relief around the wire


3. Use a crimping tool to shrink the connector around the wire ends
4. Slide the connector housing onto the crimp until it mounts, making sure the orientation is correct

## N64 1 Player connection diagram

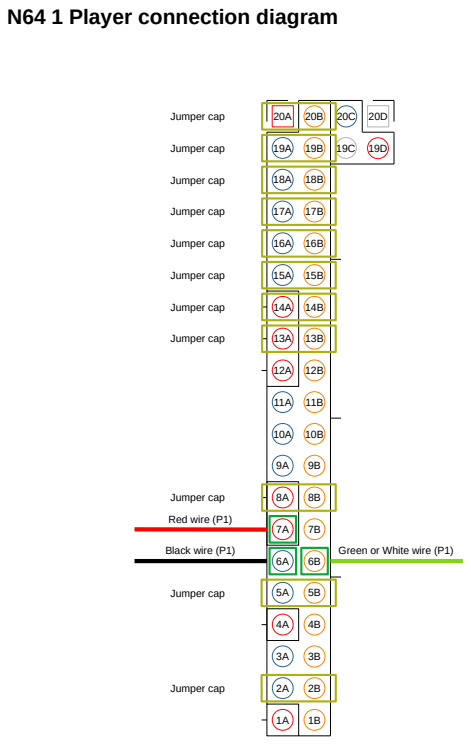
[picture p123: page 2]
Black wire (P1); Green or White wire (P1); Red wire (P1); Jumper cap

## N64 1 Player connection guide

1. Place the jumper caps on rows 2, 5, 8, 13, 14, 15, 16, 17, 18, 19 and 20
2. Connect the red wire to pin 7A
3. Connect the black wire to pin 6A
4. Connect the green wire to pin 6B
5. Connections should now resemble the diagram
