GrechTech/RetroRosetta/Documenation/Setup/N64 4 Player Cable Setup Guide.pdf

## N64 cable assembly

1. If recycling a cable from a broken controller, or if using an extension cable, cut the cable 10-40cm from the plug.
2. Strip 3-5 cm of the outer insulation sleeving from the cable
3. Isolate the inner wires from the cable and strip 5mm from each wire


4. Crimp each wire with a female Dupont crimp in line with the crimping guide
5. Repeat steps 1 to 4 for a second, third and fourth cable

## Crimping

1. Place the wire in a female Dupont crimp
2. Fold the pull relief around the wire


3. Use a crimping tool to shrink the connector around the wire ends
4. Slide the connector housing onto the crimp until it mounts, making sure the orientation is correct

## N64 4 Player connection diagram

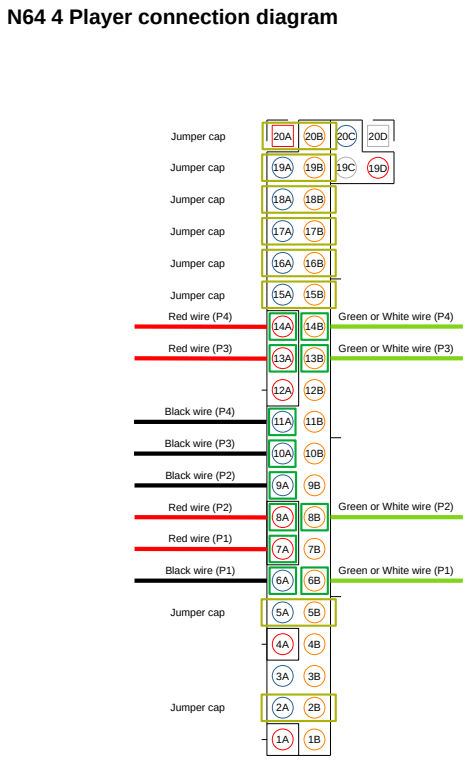
[picture p125: page 2]
Black wire (P1); Green or White wire (P1); Red wire (P1); Jumper cap; Black wire (P2); Red wire (P2); Red wire (P3); Green or White wire (P3); Black wire (P3); Black wire (P4); Red wire (P4); Green or White wire (P4)

Green or White wire (P2)

## N64 4 Player connection guide

1. Place the jumper caps on rows 2, 5, 15, 16, 17, 18, 19 and 20
2. Connect the red wire of the Player 1 cable to pin 7A
3. Connect the black wire of the Player 1 cable to pin 6A
4. Connect the green wire of the Player 1 cable to pin 6B
5. Connect the red wire of the Player 2 cable to pin 8A
6. Connect the black wire of the Player 2 cable to pin 9A
7. Connect the green wire of the Player 2 cable to pin 8B
8. Connect the red wire of the Player 3 cable to pin 13A
9. Connect the black wire of the Player 3 cable to pin 10A
10. Connect the green wire of the Player 3 cable to pin 13B
11. Connect the red wire of the Player 4 cable to pin 14A
12. Connect the black wire of the Player 4 cable to pin 11A
13. Connect the green wire of the Player 4 cable to pin 14B
14. Connections should now resemble the diagram
