GrechTech/RetroRosetta/Documenation/Setup/PS 1 Player Cable Setup Guide.pdf

PS Cable assembly
1. If recycling a cable from a broken controller, or if using an extension cable, cut the cable 10-40cm from the plug.
2. Strip 3-5 cm of the outer insulation sleeving from the cable
3. Cut down the red wire and terminate it with insulated tape
4. Strip 5mm from the remaining wires.
5. Crimp each stripped wire with a female Dupont crimp in line with the crimping guide

## Crimping

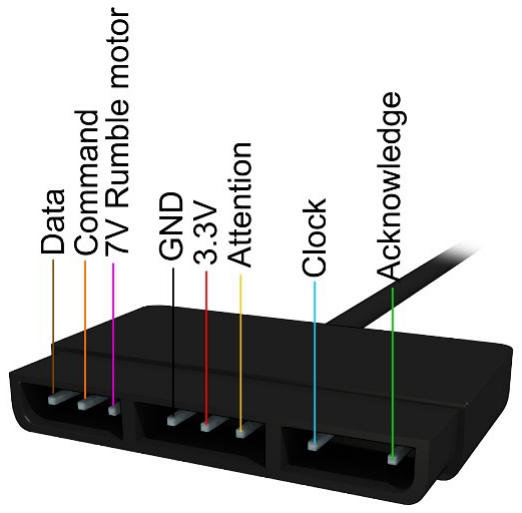
[picture p126: figure]

1. Place the wire in a female Dupont crimp
2. Fold the pull relief around the wire


3. Use a crimping tool to shrink the connector around the wire ends
4. Slide the connector housing onto the crimp until it mounts, making sure the orientation is correct

## PS1/PS2 Single Port (1 Player or Multitap) connection diagram

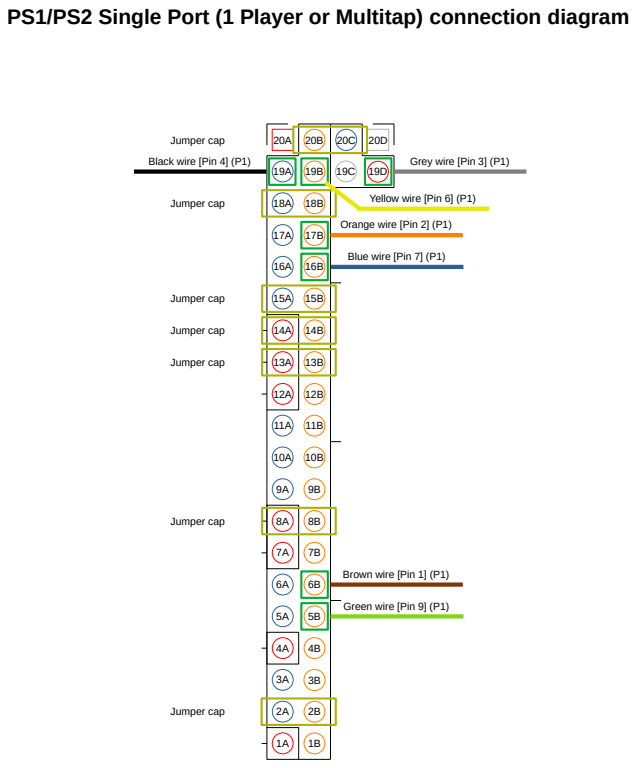
[picture p127: page 2]
Jumper cap

Jumper cap
Black wire [Pin 4] (P1)

Grey wire [Pin 3] (P1)

Yellow wire [Pin 6] (P1)

Orange wire [Pin 2] (P1)

Blue wire [Pin 7] (P1)

Brown wire [Pin 1] (P1)

Green wire [Pin 9] (P1)

## PS1/PS2 Single Port (1 Player or Multitap) connection guide

1. Place the jumper caps on rows 2, 8, 13, 14, 15 and 18
2. On row 20, place the jumper cap across the two central pins (20B & 20C) of the row
3. Connect the green wire (Port pin 9) to pin 5B
4. Connect the brown wire (Port pin 1) to pin 6B
5. Connect the blue wire (Port pin 7) to pin 16B
6. Connect the orange wire (Port pin 2) to pin 17B
7. Connect the yellow wire (Port pin 6) to pin 19B
8. Connect the black wire (Port pin 4) to pin 19A
9. Connect the grey wire (Port pin 3) to pin 19D
1. Connections should now resemble the diagram
