GrechTech/RetroRosetta/Wiki/V2/RetroRosettaV2 DIY Setup_3.png

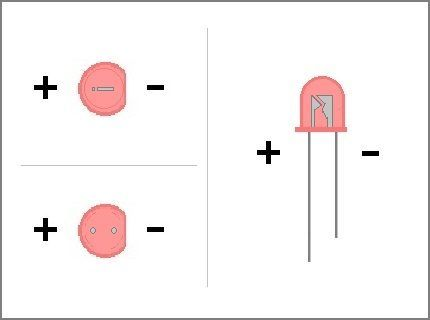
Wiki/V2/RetroRosettaV2 DIY Setup_3.png
