GrechTech/RetroRosetta/HW/V2/PCB/RetroRosettaV2.kicad_pcb

## KiCad design HW/V2/PCB/RetroRosettaV2.kicad_pcb (2023-12-26)

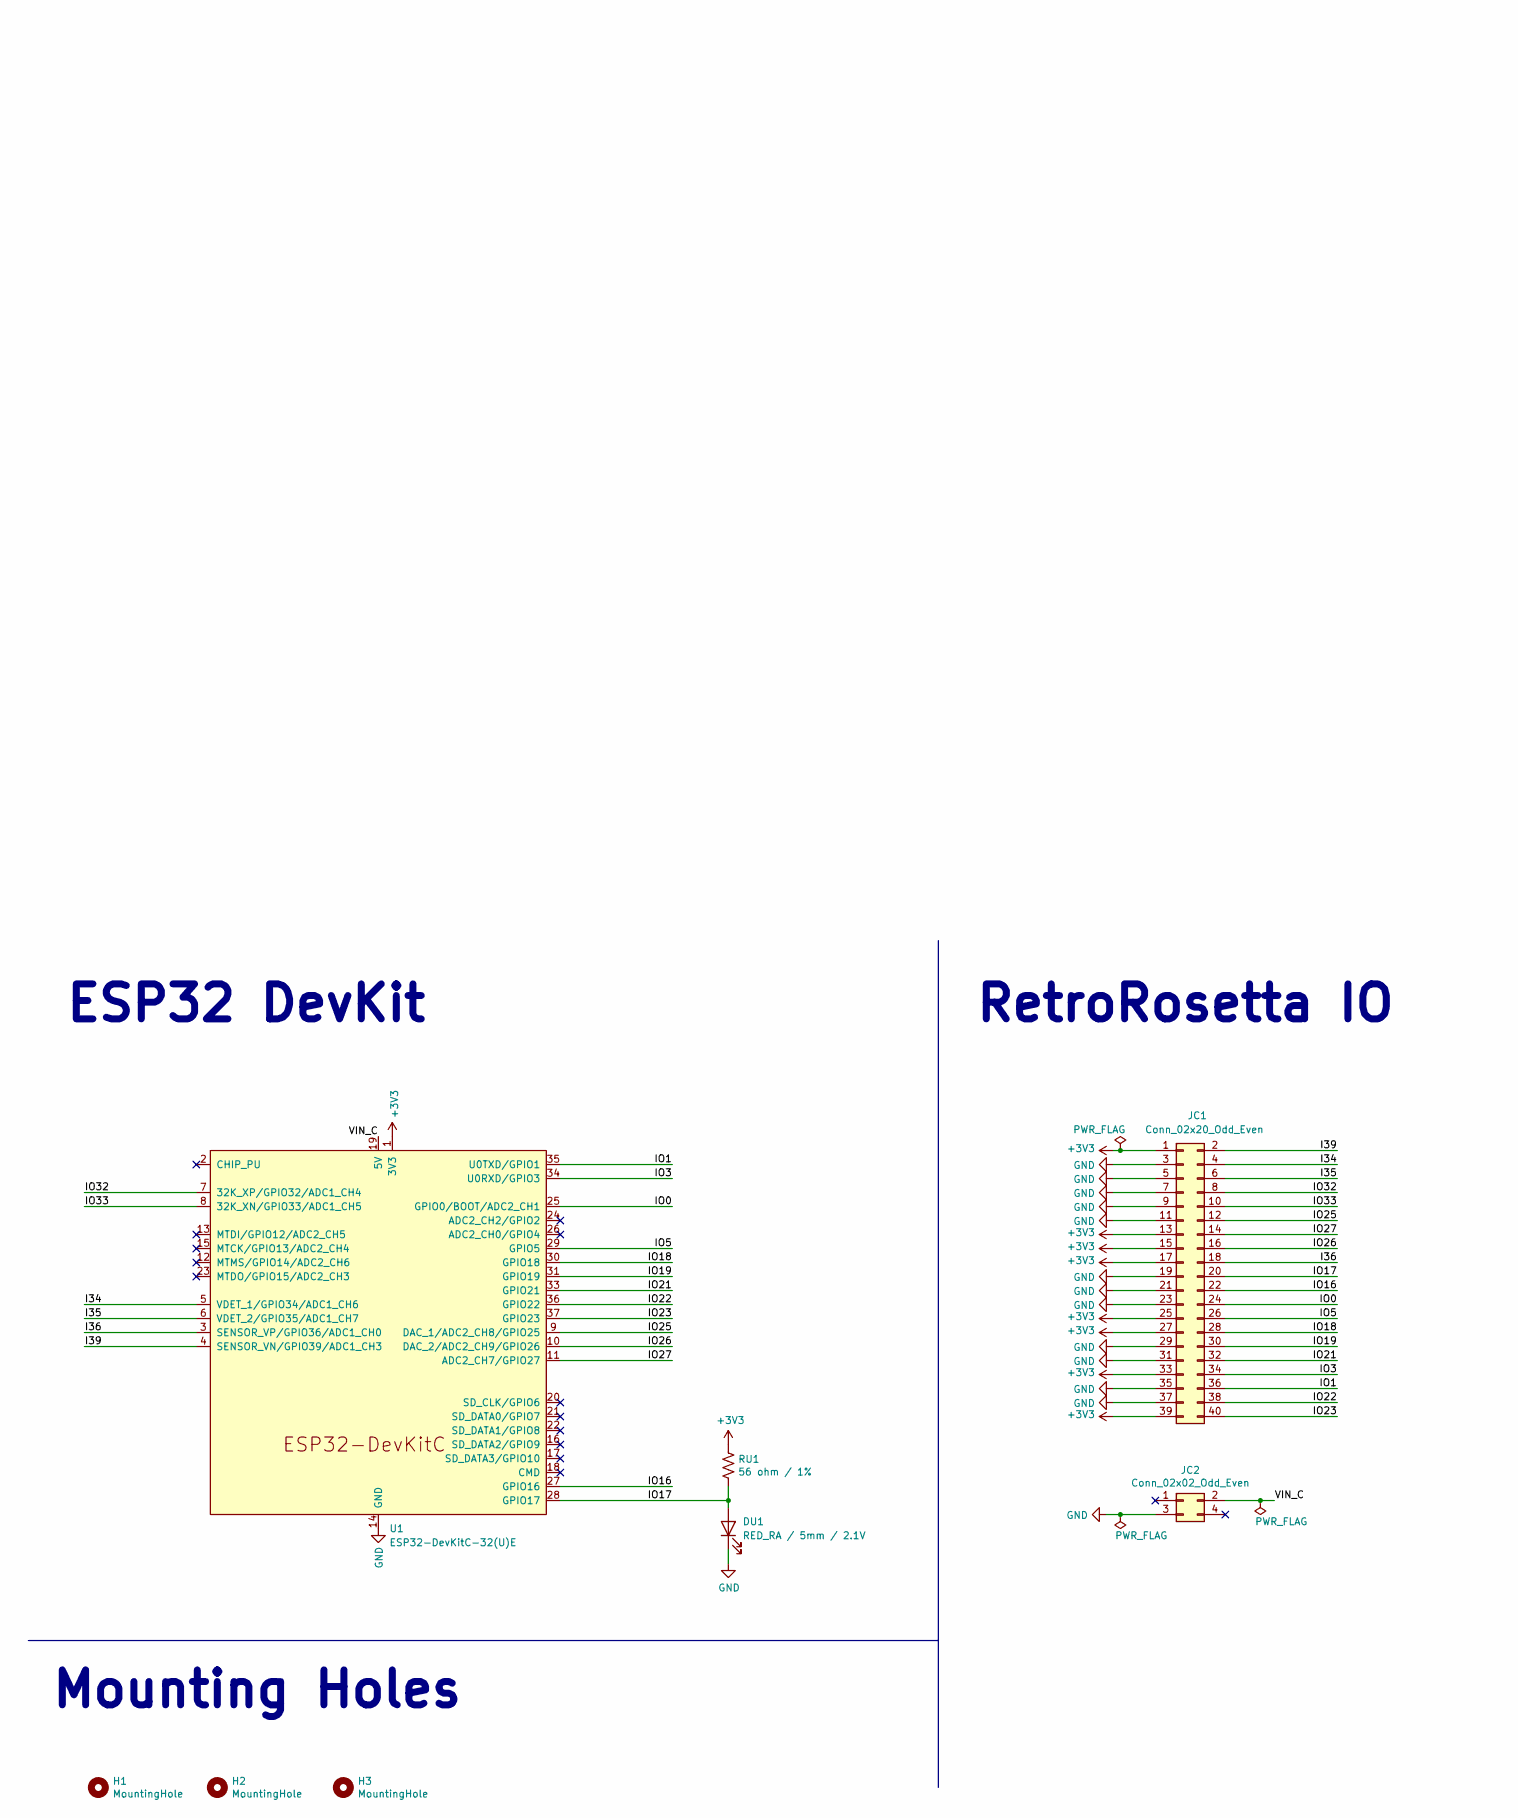
[picture p129: schematic RetroRosettaV2.kicad_sch, GT RetroRosetta, part in row 1, column 2]

Parts:
DU1: RED_RA / 5mm / 2.1V; LED_D5.0mm; Manufacturer_Part_Number C503B-RAN-CZ0C0AA2; DigiKey Part Number C503B-RAN-CZ0C0AA2CT-ND
H1, H2, H3: MountingHole; MountingHole_2.2mm_M2; Manufacturer_Part_Number DNP; DigiKey Part Number DNP
JC1: Conn_02x20_Odd_Even; PinHeader_2x20_P2.54mm_Vertical; Manufacturer_Part_Number Male 2.54mm pin header 2x20; DigiKey Part Number Male 2.54mm pin header 2x20
JC2: Conn_02x02_Odd_Even; PinHeader_2x02_P2.54mm_Vertical; Manufacturer_Part_Number Male 2.54mm pin header 2x2; DigiKey Part Number Male 2.54mm pin header 2x2
RU1: 56 ohm / 1%; R_Axial_DIN0204_L3.6mm_D1.6mm_P7.62mm_Horizontal; Manufacturer_Part_Number MFR-25FTE52-56R; DigiKey Part Number 13-MFR-25FTE52-56RCT-ND
U1: ESP32-DevKitC-32(U)E; ESP32-DevKitC; Manufacturer_Part_Number ESP32-DEVKITC-32E; DigiKey Part Number 1965-ESP32-DEVKITC-32E-ND

Connections:
+3V3: JC1.1, JC1.13, JC1.15, JC1.17, JC1.25, JC1.27, JC1.33, JC1.39, RU1.1, U1.1 (3V3)
/I34: JC1.4, U1.5 (VDET_1/GPIO34/ADC1_CH6)
/I35: JC1.6, U1.6 (VDET_2/GPIO35/ADC1_CH7)
/I36: JC1.18, U1.3 (SENSOR_VP/GPIO36/ADC1_CH0)
/I39: JC1.2, U1.4 (SENSOR_VN/GPIO39/ADC1_CH3)
/IO0: JC1.24, U1.25 (GPIO0/BOOT/ADC2_CH1)
/IO1: JC1.36, U1.35 (U0TXD/GPIO1)
/IO3: JC1.34, U1.34 (U0RXD/GPIO3)
/IO5: JC1.26, U1.29 (GPIO5)
/IO16: JC1.22, U1.27 (GPIO16)
/IO17: DU1.2 (A), JC1.20, RU1.2, U1.28 (GPIO17)
/IO18: JC1.28, U1.30 (GPIO18)
/IO19: JC1.30, U1.31 (GPIO19)
/IO21: JC1.32, U1.33 (GPIO21)
/IO22: JC1.38, U1.36 (GPIO22)
/IO23: JC1.40, U1.37 (GPIO23)
/IO25: JC1.12, U1.9 (DAC_1/ADC2_CH8/GPIO25)
/IO26: JC1.16, U1.10 (DAC_2/ADC2_CH9/GPIO26)
/IO27: JC1.14, U1.11 (ADC2_CH7/GPIO27)
/IO32: JC1.8, U1.7 (32K_XP/GPIO32/ADC1_CH4)
/IO33: JC1.10, U1.8 (32K_XN/GPIO33/ADC1_CH5)
/VIN_C: JC2.2, U1.19 (5V)
GND: DU1.1 (K), JC1.3, JC1.5, JC1.7, JC1.9, JC1.11, JC1.19, JC1.21, JC1.23, JC1.29, JC1.31, JC1.35, JC1.37, JC2.3, U1.14 (GND), U1.32 (GND), U1.38 (GND)

Notes on the sheet:
Mounting Holes
ESP32 DevKit
RetroRosetta IO

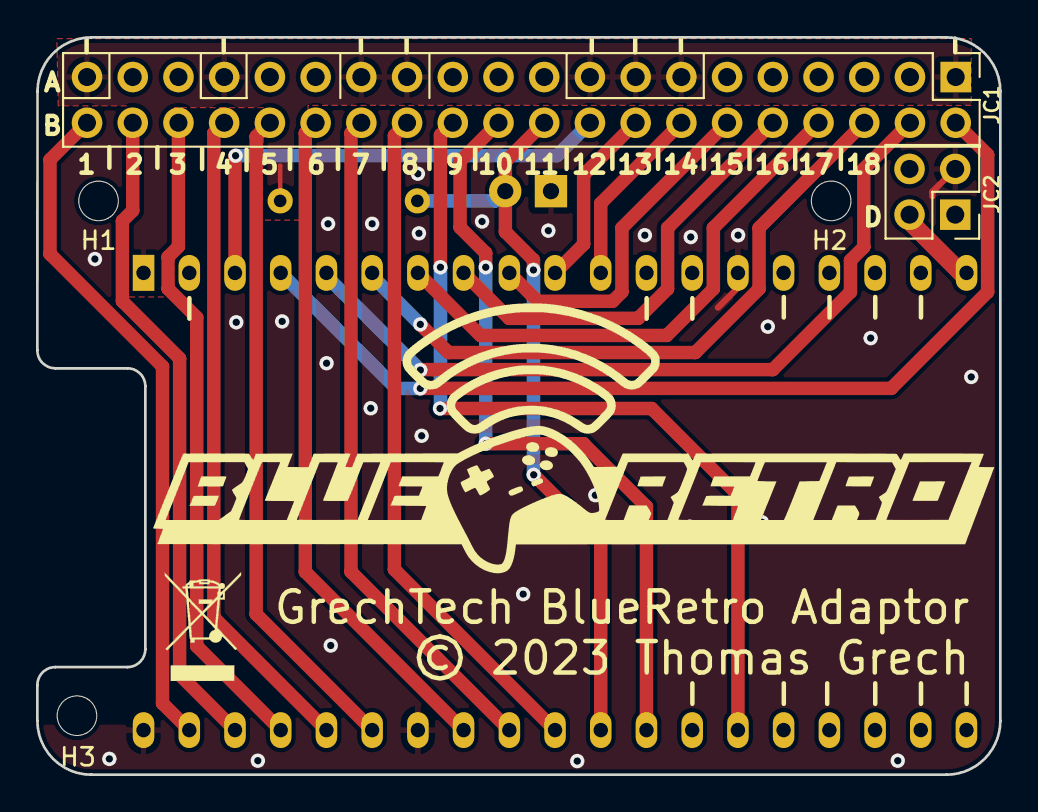
[picture p130: board RetroRosettaV2.kicad_pcb from above]

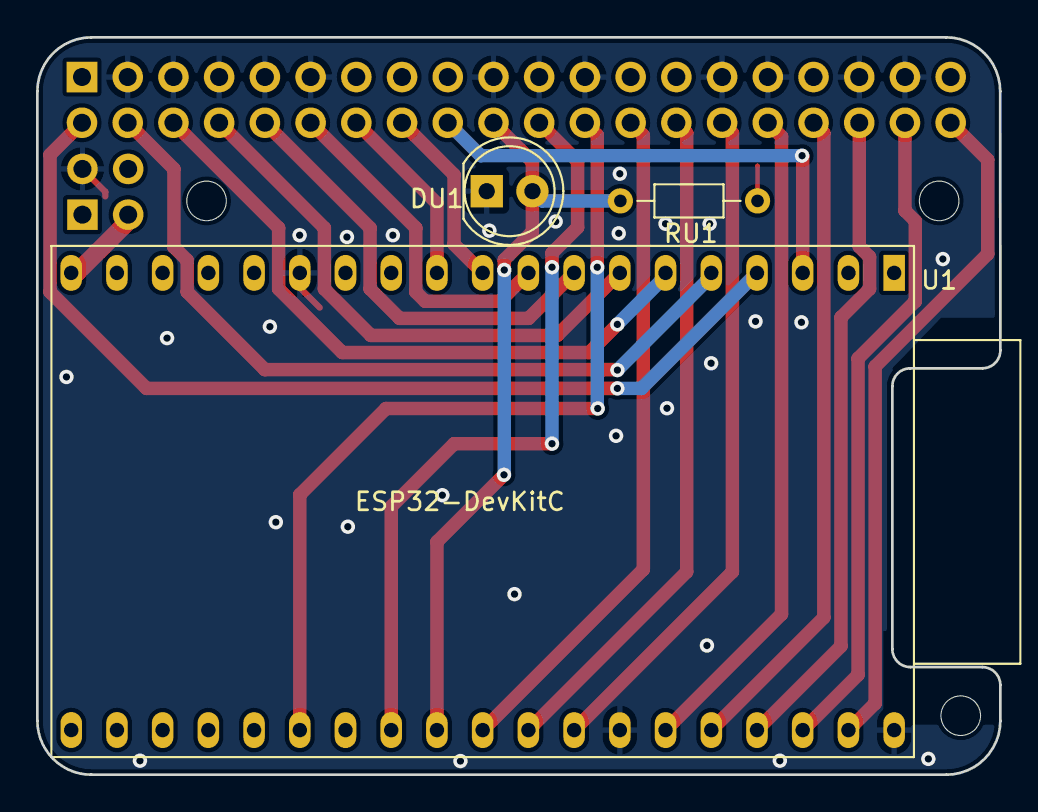
[picture p131: board RetroRosettaV2.kicad_pcb from below]

Board: 2 copper layers, 53.5 x 41.0 mm, 8 parts (3 on the bottom side), 23 nets.
