GrechTech/RetroRosetta/HW/V1/PCB/RetroRosettaLevelShifter/RetroRosettaLevelShifter.kicad_pcb

## KiCad design HW/V1/PCB/RetroRosettaLevelShifter/RetroRosettaLevelShifter.kicad_pcb (2023-12-24, an earlier design)

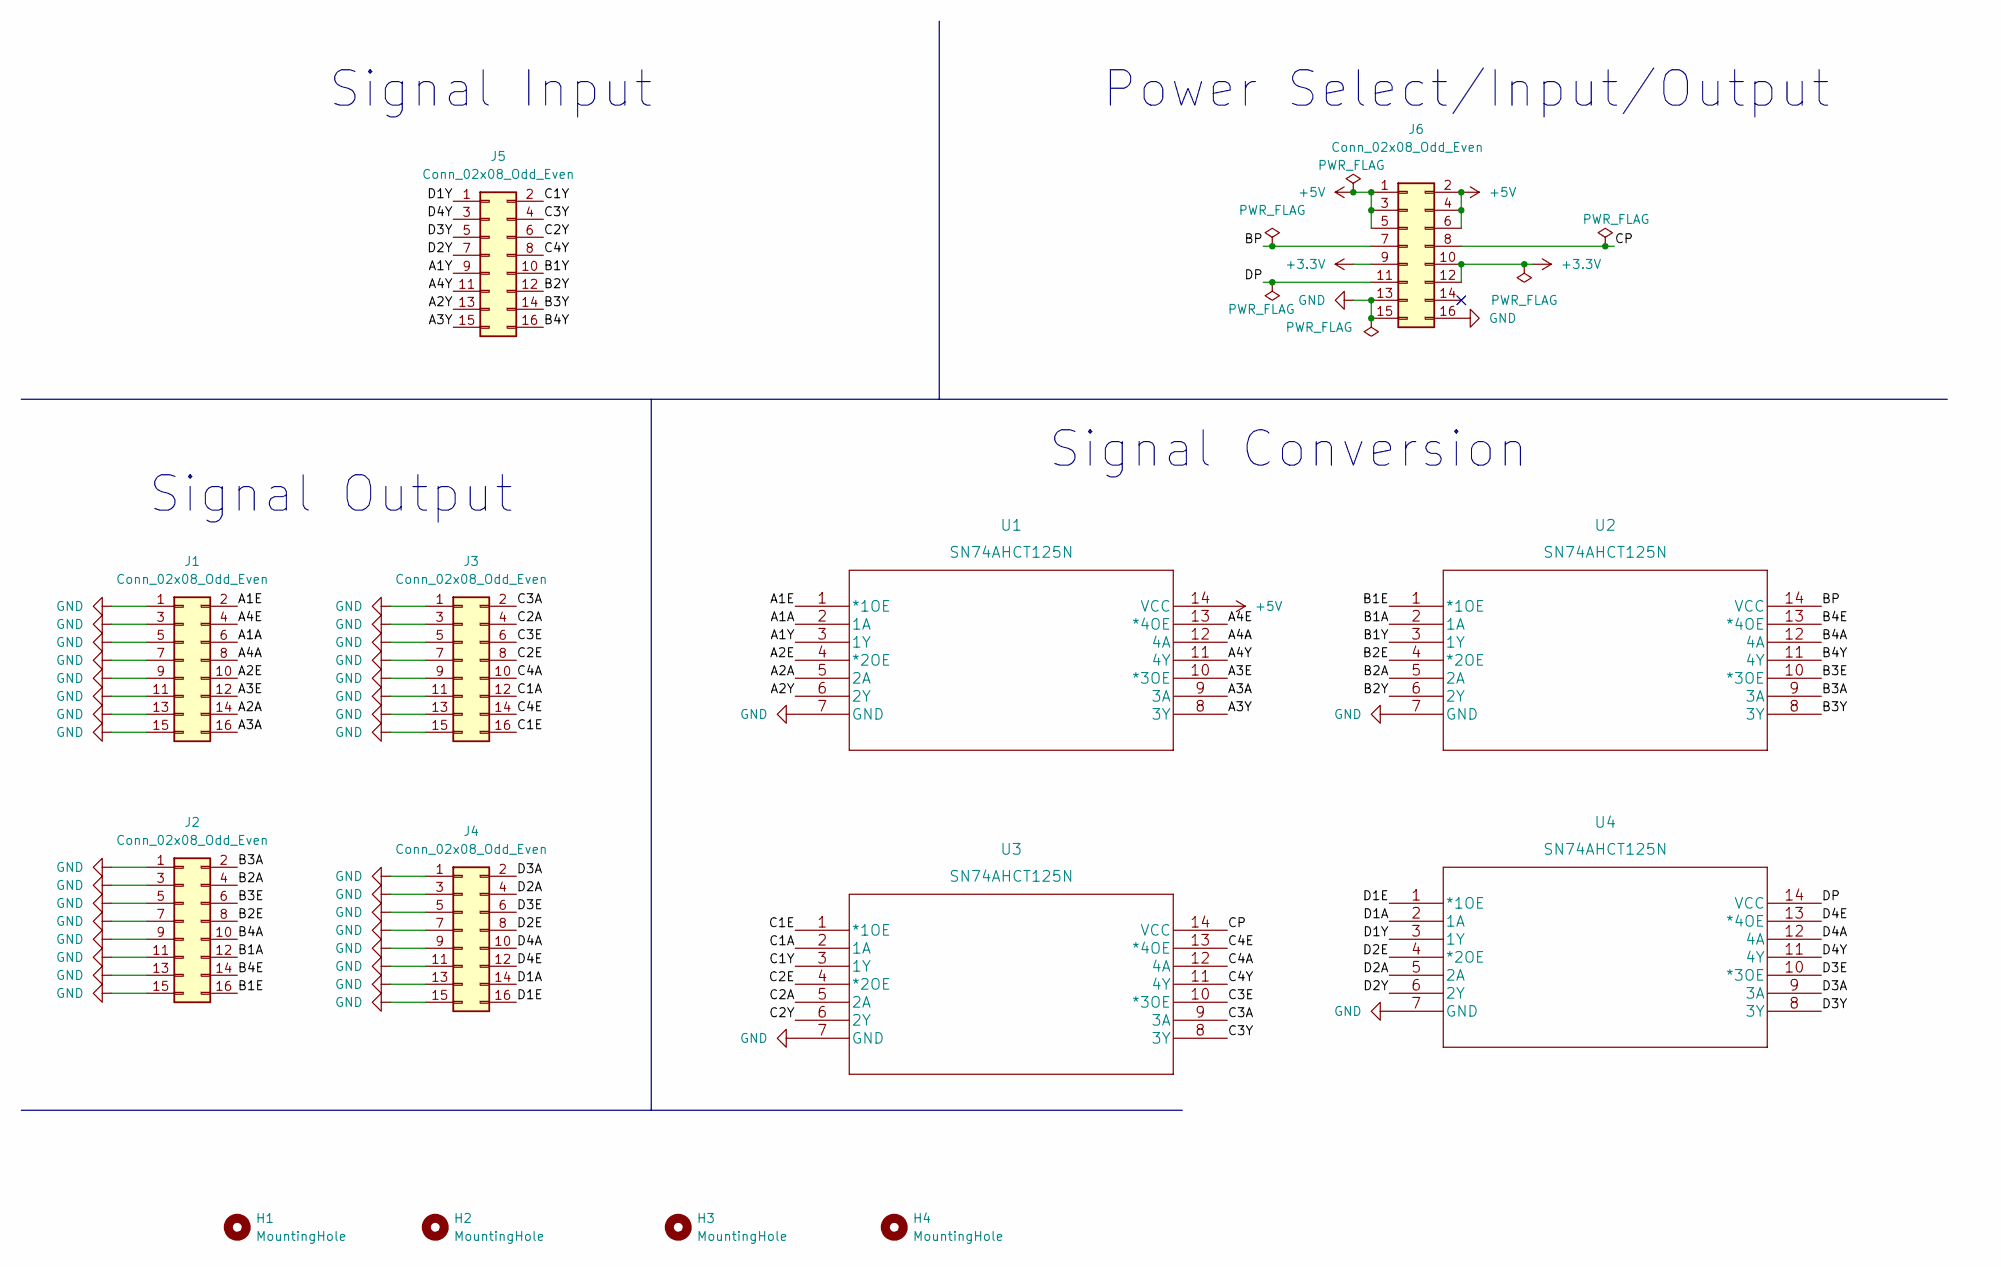
[picture p132: schematic RetroRosettaLevelShifter.kicad_sch, Buffered Level Shifter]

Parts:
H1, H2, H3, H4: MountingHole; MountingHole_2.7mm_M2.5
J1, J2, J3, J4, J5, J6: Conn_02x08_Odd_Even; PinHeader_2x08_P2.54mm_Vertical
U1, U2, U3, U4: SN74AHCT125N

Connections:
+3.3V: J6.9, J6.10, J6.12
+5V: J6.1, J6.2, J6.3, J6.4, J6.5, J6.6, U1.14 (VCC)
/A1A: J1.6, U1.2 (1A)
/A1E: J1.2, U1.1 (*1OE)
/A1Y: J5.9, U1.3 (1Y)
/A2A: J1.14, U1.5 (2A)
/A2E: J1.10, U1.4 (*2OE)
/A2Y: J5.13, U1.6 (2Y)
/A3A: J1.16, U1.9 (3A)
/A3E: J1.12, U1.10 (*3OE)
/A3Y: J5.15, U1.8 (3Y)
/A4A: J1.8, U1.12 (4A)
/A4E: J1.4, U1.13 (*4OE)
/A4Y: J5.11, U1.11 (4Y)
/B1A: J2.12, U2.2 (1A)
/B1E: J2.16, U2.1 (*1OE)
/B1Y: J5.10, U2.3 (1Y)
/B2A: J2.4, U2.5 (2A)
/B2E: J2.8, U2.4 (*2OE)
/B2Y: J5.12, U2.6 (2Y)
/B3A: J2.2, U2.9 (3A)
/B3E: J2.6, U2.10 (*3OE)
/B3Y: J5.14, U2.8 (3Y)
/B4A: J2.10, U2.12 (4A)
/B4E: J2.14, U2.13 (*4OE)
/B4Y: J5.16, U2.11 (4Y)
/BP: J6.7, U2.14 (VCC)
/C1A: J3.12, U3.2 (1A)
/C1E: J3.16, U3.1 (*1OE)
/C1Y: J5.2, U3.3 (1Y)
/C2A: J3.4, U3.5 (2A)
/C2E: J3.8, U3.4 (*2OE)
/C2Y: J5.6, U3.6 (2Y)
/C3A: J3.2, U3.9 (3A)
/C3E: J3.6, U3.10 (*3OE)
/C3Y: J5.4, U3.8 (3Y)
/C4A: J3.10, U3.12 (4A)
/C4E: J3.14, U3.13 (*4OE)
/C4Y: J5.8, U3.11 (4Y)
/CP: J6.8, U3.14 (VCC)
/D1A: J4.14, U4.2 (1A)
/D1E: J4.16, U4.1 (*1OE)
/D1Y: J5.1, U4.3 (1Y)
/D2A: J4.4, U4.5 (2A)
/D2E: J4.8, U4.4 (*2OE)
/D2Y: J5.7, U4.6 (2Y)
/D3A: J4.2, U4.9 (3A)
/D3E: J4.6, U4.10 (*3OE)
/D3Y: J5.5, U4.8 (3Y)
/D4A: J4.10, U4.12 (4A)
/D4E: J4.12, U4.13 (*4OE)
/D4Y: J5.3, U4.11 (4Y)
/DP: J6.11, U4.14 (VCC)
GND: J1.1, J1.3, J1.5, J1.7, J1.9, J1.11, J1.13, J1.15, J2.1, J2.3, J2.5, J2.7, J2.9, J2.11, J2.13, J2.15, J3.1, J3.3, J3.5, J3.7, J3.9, J3.11, J3.13, J3.15, J4.1, J4.3, J4.5, J4.7, J4.9, J4.11, J4.13, J4.15, J6.13, J6.15, J6.16, U1.7 (GND), U2.7 (GND), U3.7 (GND), U4.7 (GND)

Notes on the sheet:
Power Select/Input/Output
Signal Conversion
Signal Input
Signal Output

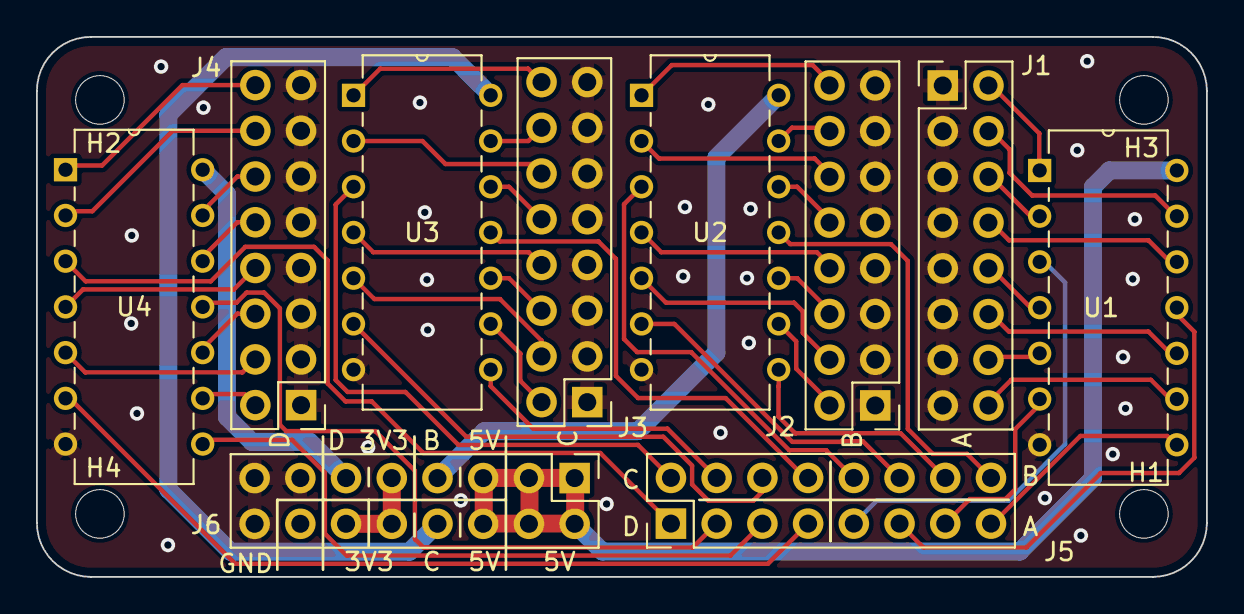
[picture p133: board RetroRosettaLevelShifter.kicad_pcb from above]

Board: 2 copper layers, 65.0 x 30.0 mm, 14 parts (0 on the bottom side), 54 nets.
