GrechTech/RetroRosetta/(commit log)

2022-08-09 Cable setup guides batch 1
    Cable guides for: N64, Gamecube, Dreamcast, PS1/PS2
    Details the construction of the cables, and the connections of the cables and accompanying jumper caps to the RetroRosetta PCB
2023-12-24 RR V2 upload
    [Case 2.f3d, Case C.step, Case C4.step, Case D.step, Case Ext.step, Case Flat.step, Case Flat.stl, Case Grip.step]
2023-12-26 Migrate documentation for V2
    [RetroRosettaV2.kicad_pcb, RetroRosettaV2.kicad_sch]
