GrechTech/RetroRosetta/(notices)

Notices in the files:
HW/V2/PCB/RetroRosettaV2.kicad_pcb:
This PCB design is licensed under MIT Open Source License.
© 2023 Thomas Grech
HW/V1/PCB/RetroRosettaV1/RetroRosettaV1.kicad_pcb:
For BlueRetro ESP32 Universal FW HW1 ©2020 Jacques Gagnon
HW/V2/PCB/RetroRosettaV2.kicad_sch:
For BlueRetro ESP32 Universal FW ©2020 Jacques Gagnon
